Robusr/DustArrow/media/README.md

# Media

## Photos

- `photos/project/` — author’s renders, bench photos, PCB screenshots, report
  figures and GIFs. `banner.png` is the README banner.
- `photos/project/cad_renders/` — 26 CAD and PCB screenshots from the original
  `演示图片` folder, numbered in capture order.
- `photos/reference/` — figures and equations extracted from the report. They
  are the author’s own figures.

## Videos

`videos/` keeps the original files:

- `cfd_demo.mp4` — CFD demonstration with watermark.
- `cfd_demo_alt.avi` — the clean CFD animation used for the GIF.
- `canard_parachute_animation.mp4` — nose separation, canard deployment and
  recovery animation.

### TV feature excerpts

The full January 2024 Shanghai TV feature is not stored in this repository.
Seven short excerpts are included under `photos/project/`:

- `tv_still_build.png` — DustArrow X whiteboard and printed airframe
- `tv_still_ground_station.png` — ground-station interface
- `tv_still_modular.png` — modular bays during assembly
- `tv_still_launch.png` — lift-off
- `tv_still_recovery.png` — recovered parachute
- `tv_launch.gif` — 6 s launch sequence, 800 × 450, 4.6 MB
- `tv_recovery.gif` — 6 s recovery sequence, 800 × 450, 5.9 MB

The full video is held at `F:\Desktop\Robusr\《少年爱迪生》郭沫晗.mp4`;
19:43.02, 640 × 360, 25 fps, about 72.8 MB, SHA-256
`27854a95a43206bc7dd3ea3188fd81b3f9bddbf61c9e64516de09805426529c9`.
The excerpts and the full programme remain copyright Shanghai Media Group and
are excluded from MIT. See `../docs/zh-CN/media_coverage.md` for the fact-check
and rights note.

## GIFs

GIFs are stored in `photos/project/` with a poster frame. Specifications:

| File | Width | Frame rate | Size |
|---|---:|---:|---:|
| `cfd_demo.gif` | 880 px | 12 fps | about 1.0 MB |
| `canard_deployment.gif` | 800 px | 10 fps | about 2.0 MB |

Both loop, have no audio and are below the 10 MB limit. The poster files are
`cfd_demo_poster.png` and `canard_deployment_poster.png`.

## Rights

Project renders and bench photos are the author’s work. Screenshots containing
the contest logo are kept only in the archived report and presentation, not in
the public media set. See `../docs/references/README.md`.
