Robusr/DustArrow/software/README.md

# Software

- `ground_station/` — archived PyQt5 ground-station source for DustArrow X.
- `../docs/archive/software_legacy/` — earlier Theta and contest builds, kept for
  traceability. Build outputs and `__pycache__` directories were removed.

The flight firmware is **not present** in the archive. See
`../firmware/README.md`.
