Robusr/DustArrow/docs/glossary.md

# Glossary / 术语表 / Glossaire

The three READMEs and the long-form documents use the terms below consistently.
Les trois README et les documents longs utilisent les termes ci-dessous de manière cohérente.

| English | 中文 | Français |
|---|---|---|
| DustArrow X | 沙尘利“箭” X | DustArrow X |
| meteorological sounding rocket | 气象探空火箭 | fusée-sonde météorologique |
| modular telemetry system | 模块化遥测系统 | système de télémétrie modulaire |
| airframe | 箭体 | cellule |
| bay / module bay | 舱段 / 模块舱 | baie / baie modulaire |
| nose cone | 头锥 | ogive |
| canard | 鸭翼 | plan canard |
| parachute bay | 降落伞舱 | baie de parachute |
| gold-finger connector | 金手指连接器 | connecteur à doigts dorés |
| flexible printed circuit (FPC) | 柔性电路板（FPC） | circuit imprimé flexible (FPC) |
| flight computer | 箭载计算机 | calculateur de bord |
| inertial measurement unit (IMU) | 惯性测量单元 | centrale inertielle (IMU) |
| attitude estimation | 姿态估计 | estimation d’attitude |
| complementary filter | 互补滤波 | filtre complémentaire |
| roll / pitch / yaw | 横滚 / 俯仰 / 偏航 | roulis / tangage / lacet |
| quaternion | 四元数 | quaternion |
| accelerometer | 加速度计 | accéléromètre |
| gyroscope | 陀螺仪 | gyroscope |
| barometer | 气压计 | baromètre |
| GNSS | 全球导航卫星系统 | GNSS |
| telemetry frame | 遥测帧 | trame de télémétrie |
| checksum / CRC | 校验和 / 循环冗余校验 | somme de contrôle / CRC |
| ground station | 地面站 | station au sol |
| serial port | 串口 | port série |
| bill of materials (BOM) | 物料清单 | nomenclature |
| Gerber file | Gerber 制造文件 | fichier Gerber |
| FDM 3D printing | 熔融沉积 3D 打印 | impression 3D FDM |
| von Kármán curve | 冯·卡门曲线 | courbe de von Kármán |
| reproducibility | 可复现性 | reproductibilité |
| verification | 验证 | vérification |
| design target | 设计目标 | objectif de conception |
| measured value | 实测值 | valeur mesurée |
| unverified claim | 未验证结论 | affirmation non vérifiée |
| media coverage | 媒体报道 | couverture médiatique |
| test flight | 试飞 | essai en vol |
| ignition | 点火 | allumage |
| wired ignition | 线控点火 | allumage filaire |
| recovery | 回收 | récupération |
| partial recovery | 部分回收 | récupération partielle |
| broadcast | 播出 | diffusion |
