Robusr/DustArrow/docs/en/index.md

# DustArrow X Documentation

- [Theory of operation](theory_of_operation.md) — coordinate frames, attitude
  estimation, complementary filtering, telemetry framing and quaternion
  conventions.
- [System design](system_design.md) — airframe, electronics, ground station and
  interfaces.
- [Replication guide](replication_guide.md) — what can be built, tested and what
  is missing.
- [Media coverage](media_coverage.md) — TV feature, flight-test evidence and
  rights.
- [Errata](../errata.md) — sixteen reviewed items, with status and evidence.
- [Verification](../verification.md) — test inventory, results and limitations.
- [Glossary](../glossary.md) — English, Chinese and French terms.
- [References](../references/README.md) — report, datasheets and media rights.
- [Archive](../archive/README.md) — original report, presentation and legacy code.

Return to the [English README](../../README.md).
