Robusr/DustArrow/docs/fr/index.md

# Documentation DustArrow X

- [Principe de fonctionnement](theory_of_operation.md) — repères, estimation
  d’attitude, filtre complémentaire, trame de télémétrie et conventions de
  quaternion.
- [Conception du système](system_design.md) — cellule, électronique, station au
  sol et interfaces.
- [Guide de reproduction](replication_guide.md) — ce qui peut être fabriqué,
  testé et ce qui manque.
- [Couverture médiatique](media_coverage.md) — sujet télévisé, preuve d’essai en
  vol et droits.
- [Errata](../errata.md) — seize points examinés, avec statut et preuves.
- [Vérification](../verification.md) — inventaire des tests, résultats et limites.
- [Glossaire](../glossary.md) — termes en anglais, chinois et français.
- [Références](../references/README.md) — rapport, fiches techniques et droits
  sur les médias.
- [Archives](../archive/README.md) — rapport original, présentation et ancien
  code.

Retour au [README français](../../README.fr.md).
