Robusr/DustArrow/docs/zh-CN/index.md

# DustArrow X 文档

- [工作原理](theory_of_operation.md)：坐标约定、姿态解算、互补滤波、遥测分帧与
  四元数约定。
- [系统设计](system_design.md)：箭体、电子、地面站与接口。
- [复现指南](replication_guide.md)：可以制造和测试什么，还缺少什么。
- [媒体报道](media_coverage.md)：电视专题、试飞证据与版权说明。
- [勘误记录](../errata.md)：16 项审查条目、状态与依据。
- [验证记录](../verification.md)：测试清单、结果与局限。
- [术语表](../glossary.md)：英文、中文、法文对照。
- [参考资料](../references/README.md)：报告、器件手册与媒体授权。
- [归档](../archive/README.md)：原始报告、答辩材料与旧版代码。

返回[中文 README](../../README.zh-CN.md)。
