Robusr/DustArrow/docs/zh-CN/media_coverage.md

# 媒体报道：《少年爱迪生》第八季《明日世界》

<p align="center">
  <a href="../en/media_coverage.md">English</a> |
  <a href="media_coverage.md">中文</a> |
  <a href="../fr/media_coverage.md">Français</a>
</p>

本文整理上海广播电视台青少年科学梦想秀《少年爱迪生》第八季《明日世界》中郭沫晗与“沙尘利箭”专题的公开信息，并把电视叙述与仓库中的设计、代码和验证记录区分开。电视节目是叙事性证据，不是遥测数据或实验报告。

## 1. 节目与播出信息

| 项目 | 内容 |
|---|---|
| 节目 | 青少年科学梦想秀《少年爱迪生》第八季《明日世界》 |
| 制作与播出 | 上海市科委、上海市教委、上海广播电视台；上视新闻综合频道、看看新闻 APP |
| 郭沫晗专题预告 | 2024-01-25 19:53，看看新闻 |
| 郭沫晗专题页 | 2024-01-27 23:09，看看新闻 |
| 节目综述 | 2024-02-25 10:28，看看新闻 |
| 节目季背景 | 2024-01-20 首播；16 组少年发明家，来自 40 多个国家和地区 |
| 科学顾问 | 陈凯先、倪闽景、陶虎、贾阳、戴伟、汪婧雅等 |

播出时间在不同页面存在差异：预告写“1 月 27 日晚 19 点 45 分”，综述写“每周六晚 20:30”。本文保留两种口径，不把具体分钟当作已核实事实。

官方页面：

- 预告：<https://www.kankanews.com/detail/ELwxNKJWGy9>
- 专题：<https://www.kankanews.com/detail/LMwVGm9WB2z>
- 综述：<https://www.kankanews.com/detail/boy4AKjBxQ1>

## 2. 本地视频记录

| 属性 | 数值 |
|---|---|
| 文件 | `F:\Desktop\Robusr\《少年爱迪生》郭沫晗.mp4` |
| 时长 | 19:43.02 |
| 分辨率 | 640 × 360 |
| 帧率 | 25 fps |
| 视频编码 | H.264 Main，约 447 kb/s |
| 音频编码 | AAC LC，44.1 kHz，立体声，约 65 kb/s |
| 文件大小 | 76,333,836 字节，约 72.8 MB |
| SHA-256 | `27854a95a43206bc7dd3ea3188fd81b3f9bddbf61c9e64516de09805426529c9` |

完整视频为第三方电视节目，未复制进本仓库；仓库保留 5 张截图与 2 段 GIF 摘要，
位于 `media/photos/project/`。完整视频、完整字幕与其余截帧不再分发。截图与 GIF
版权归上海广播电视台所有，不在 MIT 许可范围内。

### 转录说明

音轨使用 `faster-whisper small` 本地模型转写，并人工校正人名、专有名词和明显同音错误。转写不是官方字幕，时间码为近似值。片中内嵌中文字幕用于交叉核对。完整机器转录保存在仓库外的临时目录，不纳入版本控制。

## 3. 片中确认的项目信息

### 3.1 三代火箭与命名

| 时间 | 片中陈述 |
|---|---|
| 2023-02 | 第一代火箭完成，可以监测当前姿态并把数据返回电脑地面端软件 |
| 之后 | 第二代火箭进行初步模块化设计 |
| 第三代 | 命名为 **DustArrow X**；“X 就意味着有着无限的可能” |
| 第三代结构 | 片中称“总共四个部分，可以随意拼接”；粉尘传感器可与气体传感器拼接，组成三个传感器的探测段 |
| 模块化目标 | 探测沙尘暴、酸雨等不同天气时，不更换整个箭体，只更换相应模块 |

片中在 08:08 左右说“四个部分”，而仓库正式 CAD 将箭体细分为十个功能舱段。两者不矛盾：电视用四个功能分组讲述，CAD 用十个舱段实现。该口径差异标记为需要作者确认。

### 3.2 试飞过程

片头把时间放在“2023 年秋末初冬的一天”，地点是“固原市郊外的戈壁滩”。

1. 遥控点火程序测试失败。片中解释为开发板 I/O 口有保护机制，原方案被否定。
2. 改用线控点火，在 7.5 m 距离测试成功。
3. 在戈壁滩安装临时发射架，完成倒计时和发射。
4. 火箭升空后回收。片中陈述：“伞舱部分和推进模块都丢了”，“最重要的传感器部分留了下来”，“回收的完整程度达到了 80%”。
5. 学生表示“比预期要好很多”，片中以“成功”字幕描述这次试飞。

因此，这次试飞可以表述为：**火箭成功离架并完成回收，传感器段被找回；伞舱与推进模块丢失，整箭回收并不完整。** 80% 是学生现场估计，不是独立测量。

### 3.3 地面站与数据链

片中在 08:47 左右说明地面端“读取一个文本文件中的数据，然后完成一些简单的姿态反馈任务”。这与仓库归档代码的行为一致：串口正则解析后写入 `data.txt`，六张图是占位曲线，OpenGL 组件未启用。

学生在 18:04 左右补充了两条数据链设想：

- 设计 SD 卡记录装置；
- 在主控部分增加远程数传装置；
- “理论上是可以实时把数据传回来的”。

这是设计意图，不是片中演示结果。片中未展示遥测日志、SD 卡数据或实时回传画面。

### 3.4 设计理念

- 模块化、可回收；可以连续发射多枚火箭，对沙尘天气做立体分析。
- 现有市售粉尘传感器多为模拟传感器，存在误差；学生希望未来使用更专业、更精密的传感器。
- 项目从个人兴趣出发，逐渐转向为家乡沙尘天气监测提供工具。

## 4. 片中未提供的量化信息

片中**没有**给出以下数据：

- 飞行高度、速度、加速度、姿态角、气压、温度、湿度；
- 粉尘浓度、气体浓度或传感器标定结果；
- 通信距离、RSSI、误码率、链路余量；
- 回收撞击速度、伞舱分离高度或残骸位置；
- 整箭质量、推力、质心或转动惯量。

因此，电视节目不能替代飞行日志、传感器标定或链路预算。它只证明“进行过一次试飞并回收了部分箭体”，不证明“千米级稳定数传”或“精确气象探测”。

## 5. 与仓库资料的口径差异

| 主题 | 电视表述 | 仓库表述 | 处理 |
|---|---|---|---|
| 项目类型 | 气候监测火箭 | 气象探空火箭、模块化遥测系统 | 同一对象的不同表述；仓库使用技术术语 |
| 第三代结构 | 四个部分，可随意拼接 | 十个功能舱段 | 功能分组与 CAD 细分不同，待作者确认 |
| 第一代完成时间 | 2023-02 | 报告与 BOM 为 2023-08 | 不矛盾：2 月完成第一代，8 月形成比赛/报告材料 |
| 回收结果 | “成功”，回收完整度 80% | 归档无飞行日志 | 采用“部分回收”表述，80% 标注为学生估计 |
| 数据链 | “理论上可以实时传回” | 归档无遥测日志 | 设计意图，不作实测结论 |
| 奖项 | SkillsMP 资料称全国二等奖 | 仓库只写参加全国青少年科技创新大赛 | 官方名单未取得，标记 `[未核实]` |

关于奖项：第三方资料 SkillsMP 称项目在 2023 年 8 月第 37 届全国青少年科技创新大赛获二等奖。检索未取得官方获奖名单附件，因此本文不把它写成既成事实，也不写入 README 主规格。

## 6. 事实核查表

| 陈述 | 证据 | 状态 |
|---|---|---|
| 进行过一次火箭试飞 | 专题片 00:27–17:24；看看新闻专题页 | 电视已确认 |
| 遥控点火失败，改用线控 | 专题片 11:30–12:23 | 电视已确认 |
| 7.5 m 线控点火成功 | 专题片 12:21–12:23 | 电视已确认 |
| 传感器段回收，伞舱与推进模块丢失 | 专题片 17:09–17:24 | 电视已确认 |
| 回收完整度 80% | 专题片 17:16–17:19 | 学生现场估计，非独立测量 |
| 地面站读取文本文件并做简单姿态反馈 | 专题片 08:47–08:49；归档代码 | 已确认，属原型 |
| 实时数传 | 专题片 18:20–18:22 | 设计意图，未演示 |
| 千米级数传 | 报告声明 | 未验证 |
| 全国二等奖 | SkillsMP 资料 | `[未核实]`，无官方名单 |
| X 表示无限可能 | 专题片 08:02–08:05 | 电视已确认 |
| 试飞时间为 2023 年秋末初冬 | 专题片 00:27–00:32 | 电视陈述，无精确日期 |

## 7. 引用、版权与使用边界

- 电视节目版权归上海广播电视台及节目制作方所有。看看新闻页面注明“未经授权，不得转载”。
- 仓库包含 5 张截图和 2 段 GIF 摘要，位于 `media/photos/project/`；不包含完整视频、完整字幕或其他截帧。这些摘要属于第三方材料，不适用 MIT 许可。
- 引用建议：上海广播电视台《少年爱迪生》第八季《明日世界》郭沫晗专题，2024-01-27；本地视频文件 SHA-256 见上。
- 节目中的学生陈述属于个人叙述；涉及技术性能的数字应按“电视陈述”而非“实测数据”引用。

## 8. 对仓库信息的影响

- 三个 README 增加“媒体报道”章节，并补充 X 命名来源。
- 设计规格表把“飞行试验”从“归档中无记录”改为“电视记录的试飞，部分回收，无遥测日志”。
- 勘误表新增 E-16，记录电视证据的范围与限制。
- 不修改理论推导、BOM、CAD 或验证结果；电视叙述不作为定量依据。
