Robusr/DustArrow/docs/archive/display_board/展板文字.docx

项目背景

每逢初春，频繁恶劣的沙尘天气席卷西北大地。年初，各省市的猛烈沙尘暴登上了新闻热搜，粉尘携带细菌，造成空气质量下降，人居环境健康每况愈下，导致了呼吸系统疾病，严重影响了日常的工作和生活，沙尘天气的危害不言而喻。有效治理以精确探测为基础，地面的低空沙尘监测装置往往不能得到全面立体的沙尘暴数据，目前的气象火箭不能针对沙尘天气进行有效的实时探测，对各类恶劣天气的研究也存在局限性。中国空间站的模块化结构让我受到启发，研究设计了气象探测火箭的模块化遥测系统。

创新要点

火箭端

箭体由10个功能模块构成，根据实际需求，主体采用不同材质3D打印，各模块间设计了PCB金手指结构连接电路。其中运算模块使用了RP2040芯片作为微处理器；测控模块搭载了MPU6050六轴运动处理组件、GNSS卫星定位模组和BMP280气压传感器，用于反馈火箭姿态、高度和定位数据，参与运算并执行控制命令；数据模块使用了A39C-T400A22D1a数传模组，能实现千米级稳定精确的数据传输；3个传感器模块可根据具体的探测需求灵活调整；鸭翼和降落伞模块保障了火箭的平稳运行和有效回收。

地面端

在地面端遥测软件中，使用Python的Matplotlib数据可视化库，以Qt为UI框架，开发了简洁高效的操作界面。搭配OpenGL组件实现了3D姿态信息的实时反馈，结合Numpy库编写了相关的数据分析算法，对传感器返回的气象数据进行实时分析和精确记录，可实现多元化的探测需求。

发展前景

在各类恶劣气象灾害的防治过程中，继续完善火箭的控制算法和回收机制，以应对复杂多变的气象条件。拓展火箭搭载的传感器种类，探索模块化结构更多的可能性。接入智慧城市的物联网系统，多部门协调统筹管理，对气象灾害的预防治理整体规划，统一部署，让沙尘利“箭”带来天朗气清。
