Robusr/DustArrow/electronics/output/silkscreen/dustarrow_silkscreen.png

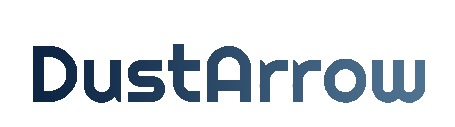
electronics/output/silkscreen/dustarrow_silkscreen.png
