Robusr/DustArrow/electronics/output/silkscreen/name_silkscreen.png

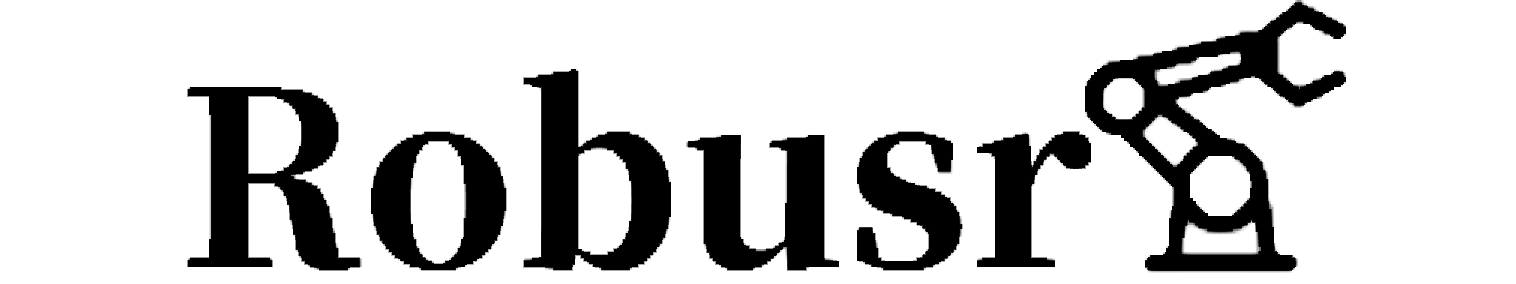
electronics/output/silkscreen/name_silkscreen.png
