Robusr/DustArrow/electronics/output/silkscreen/rocket_silkscreen.png

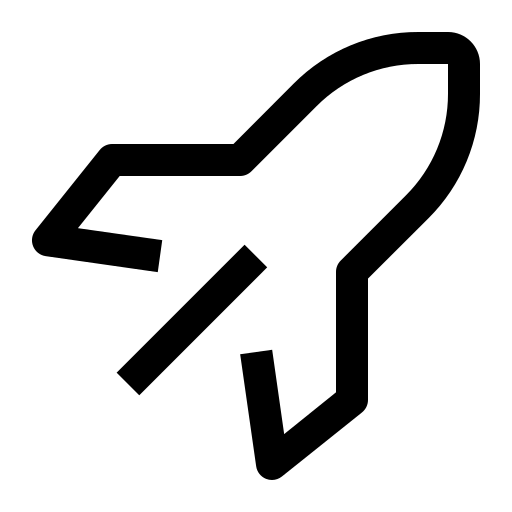
electronics/output/silkscreen/rocket_silkscreen.png
