Robusr/DustArrow/media/photos/project/attitude_render_x60_y90.png

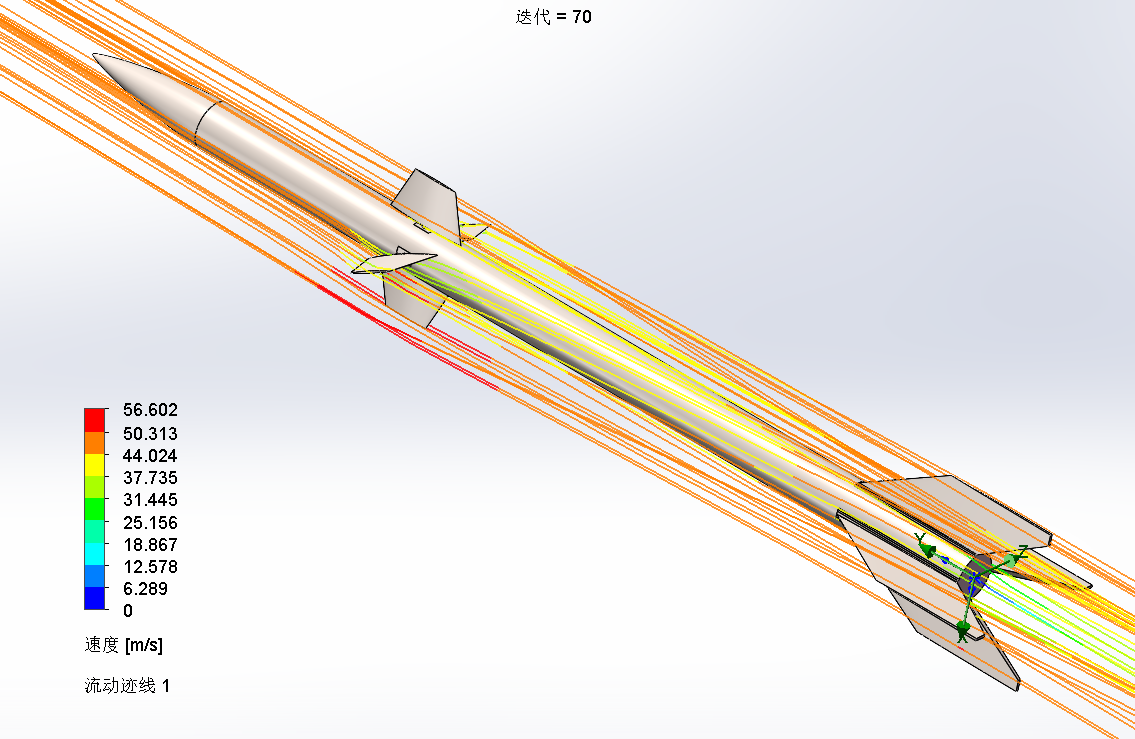
media/photos/project/attitude_render_x60_y90.png
