Robusr/DustArrow/media/photos/project/attitude_render_x90_y90.png

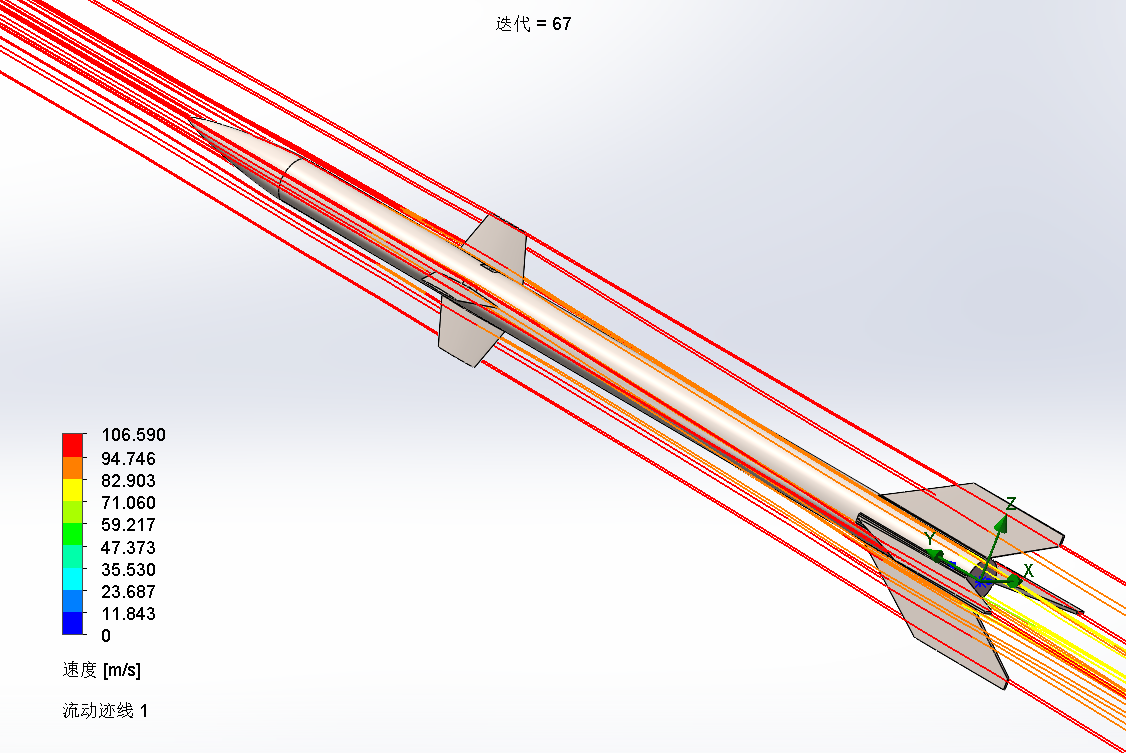
media/photos/project/attitude_render_x90_y90.png
