Robusr/DustArrow/media/photos/project/cad_renders/cad_render_01.png

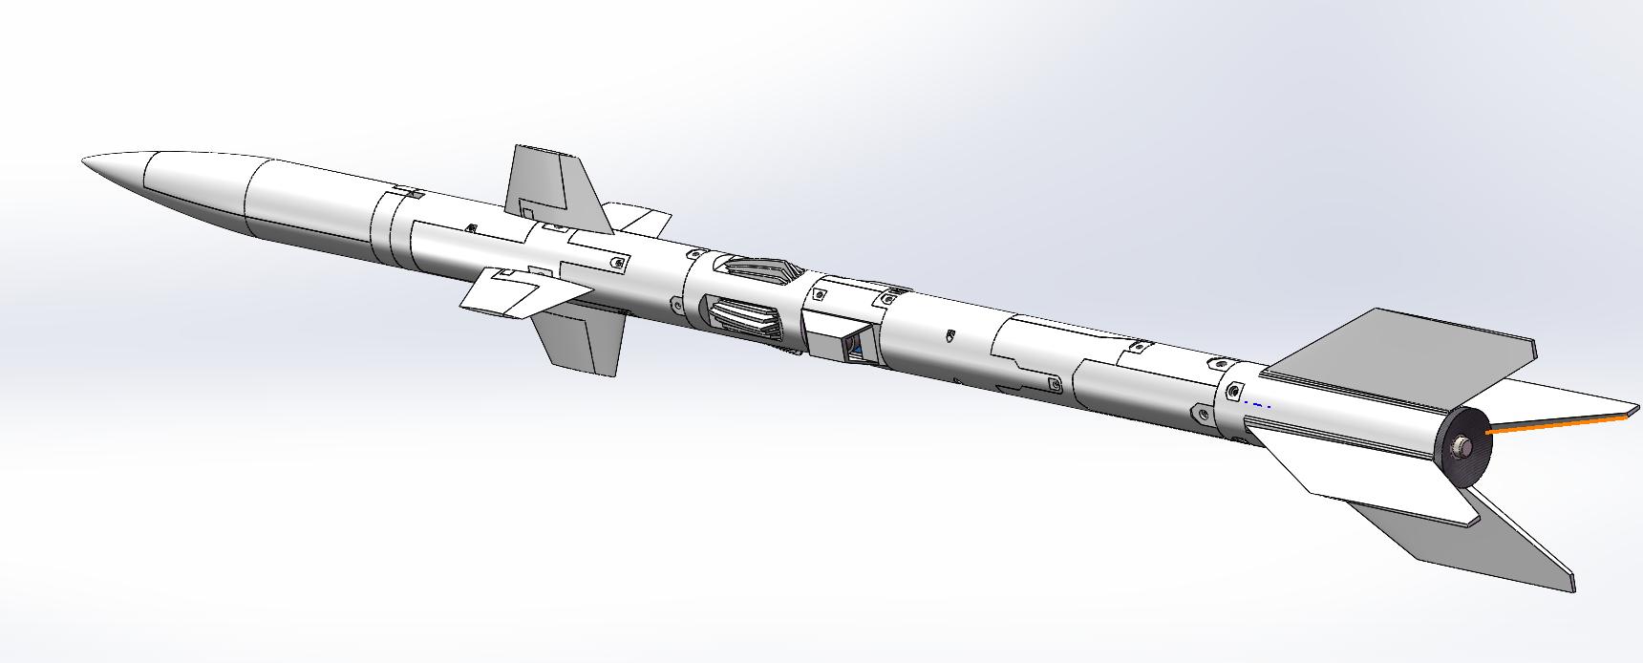
media/photos/project/cad_renders/cad_render_01.png
