Robusr/DustArrow/media/photos/project/cad_renders/cad_render_02.png

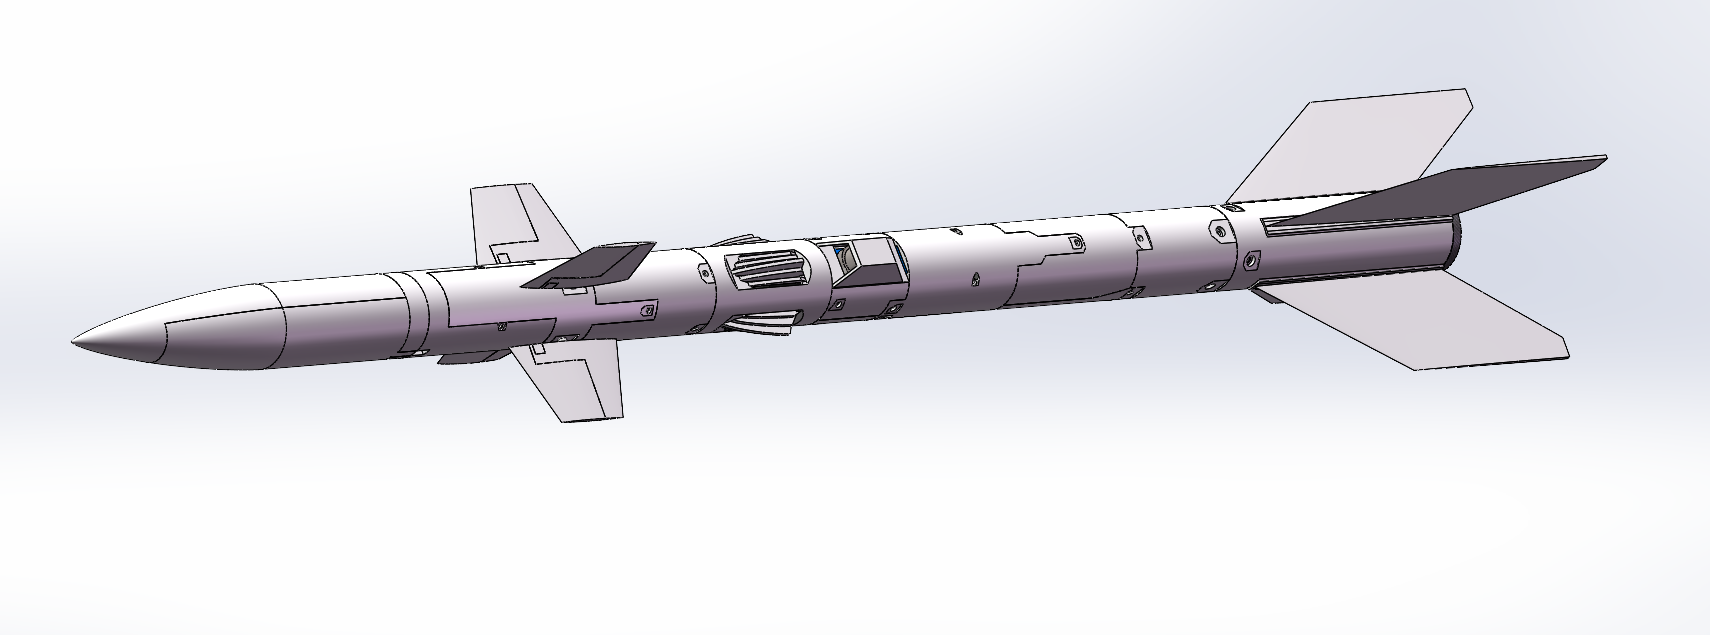
media/photos/project/cad_renders/cad_render_02.png
