Robusr/DustArrow/media/photos/project/cad_renders/cad_render_03.png

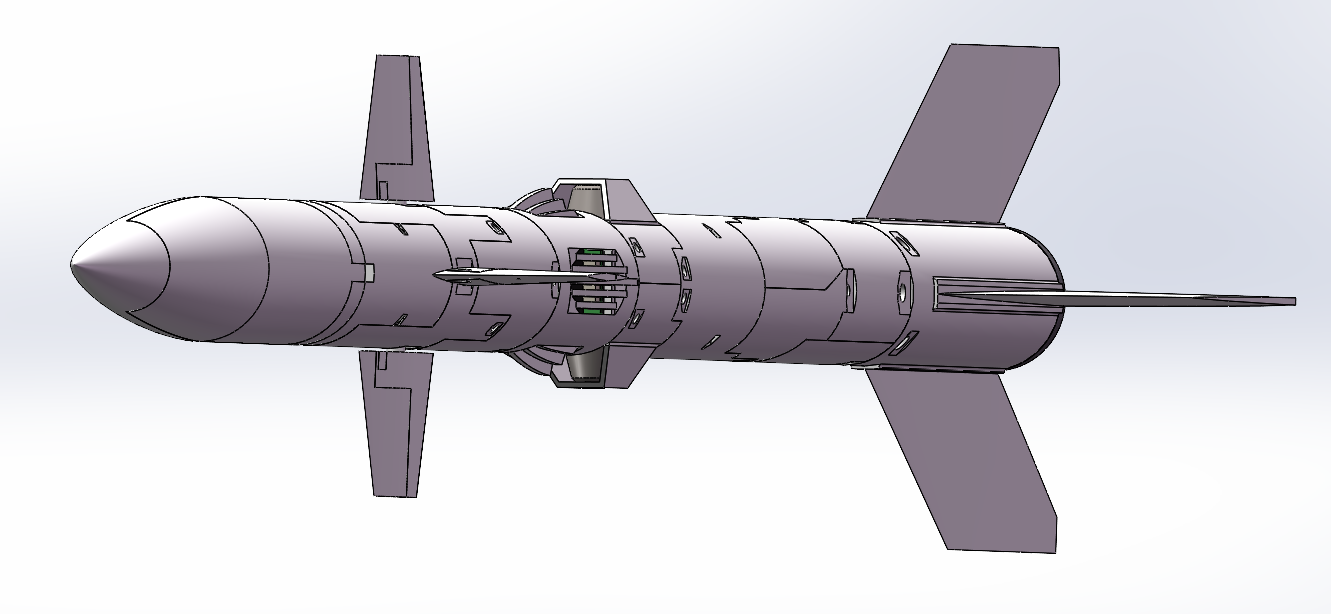
media/photos/project/cad_renders/cad_render_03.png
