Robusr/DustArrow/media/photos/project/cad_renders/cad_render_04.png

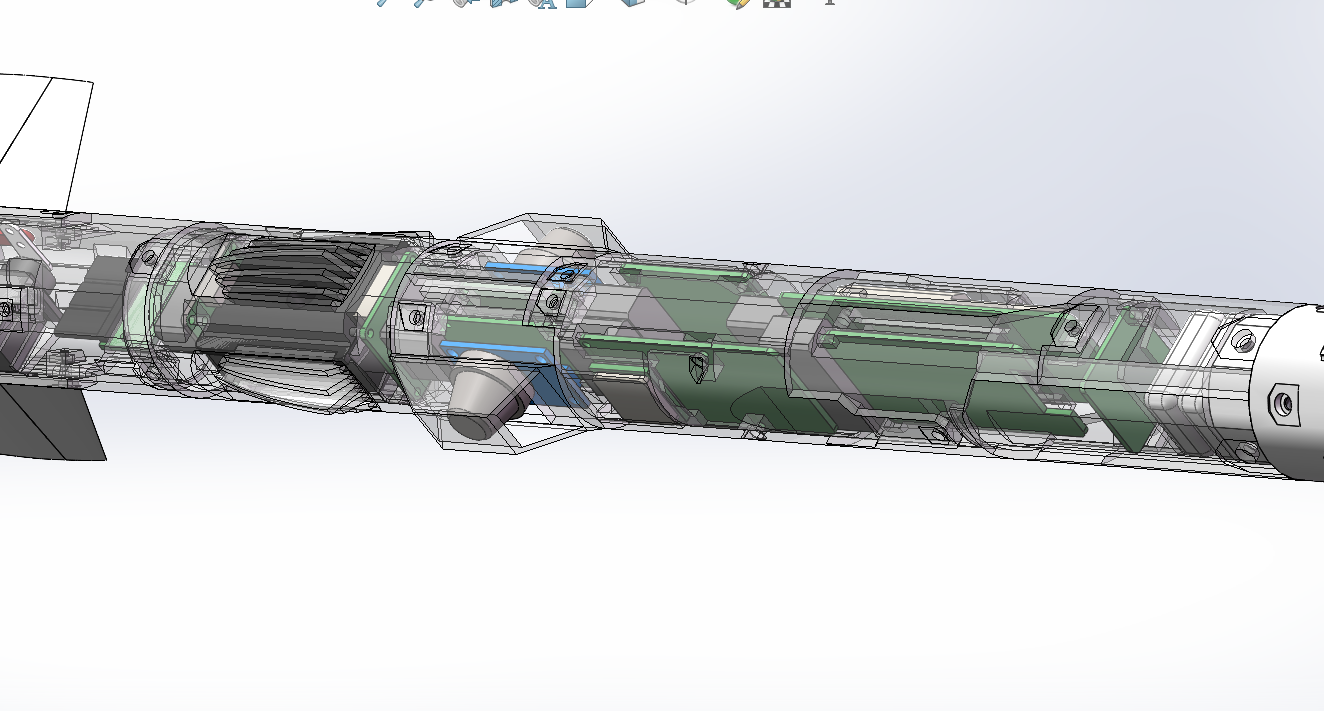
media/photos/project/cad_renders/cad_render_04.png
