Robusr/DustArrow/media/photos/project/cad_renders/cad_render_05.png

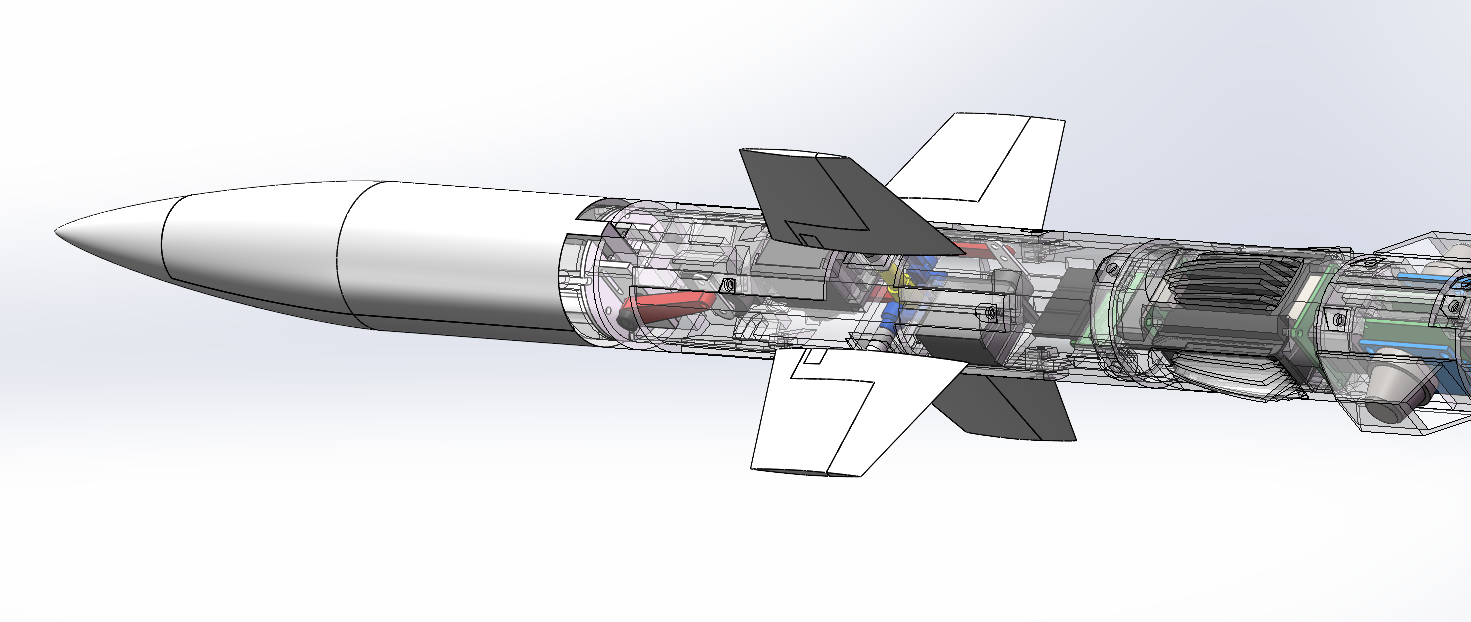
media/photos/project/cad_renders/cad_render_05.png
