Robusr/DustArrow/media/photos/project/cad_renders/cad_render_11.png

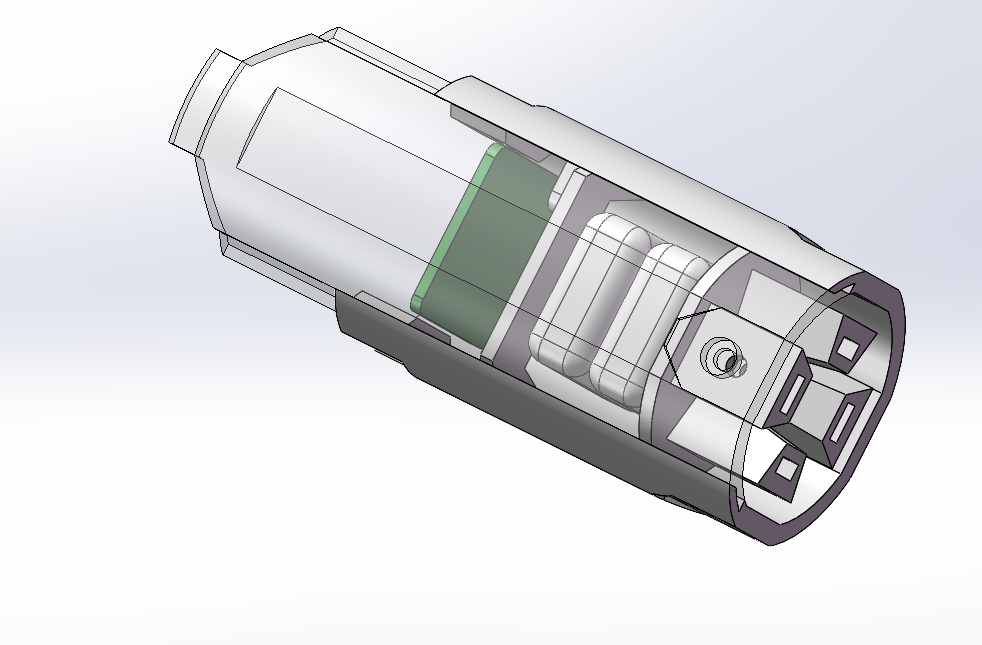
media/photos/project/cad_renders/cad_render_11.png
