Robusr/DustArrow/media/photos/project/cad_renders/cad_render_13.png

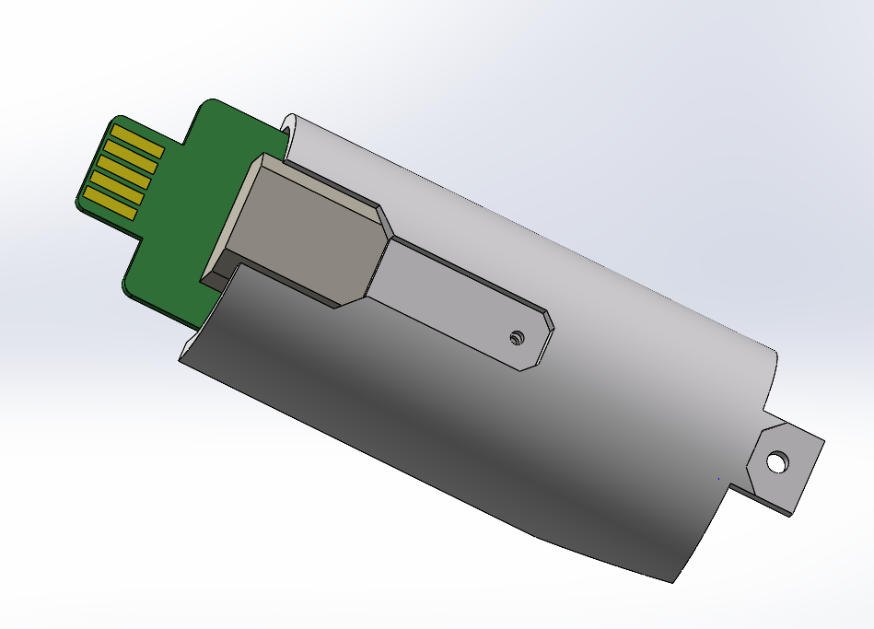
media/photos/project/cad_renders/cad_render_13.png
