Robusr/DustArrow/media/photos/project/cad_renders/cad_render_14.png

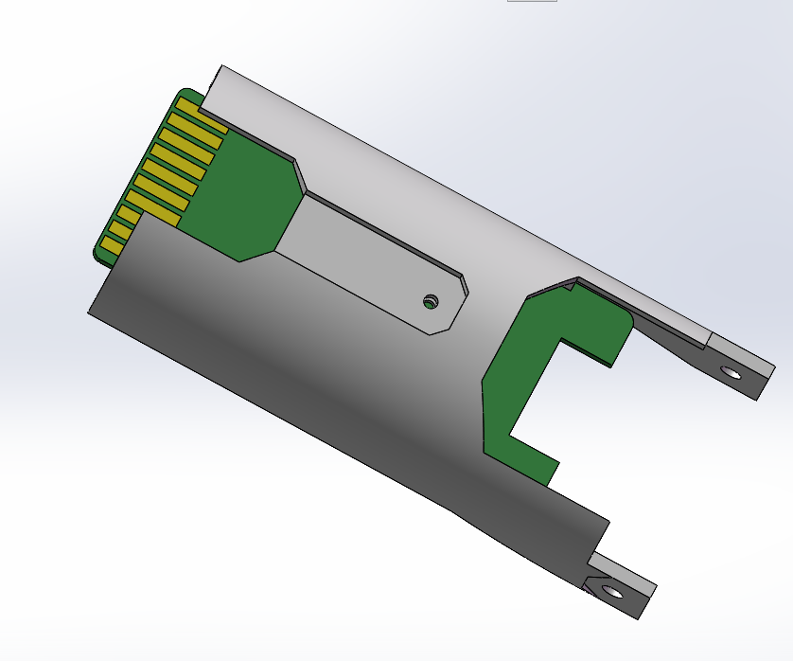
media/photos/project/cad_renders/cad_render_14.png
