Robusr/DustArrow/media/photos/project/cad_renders/cad_render_15.png

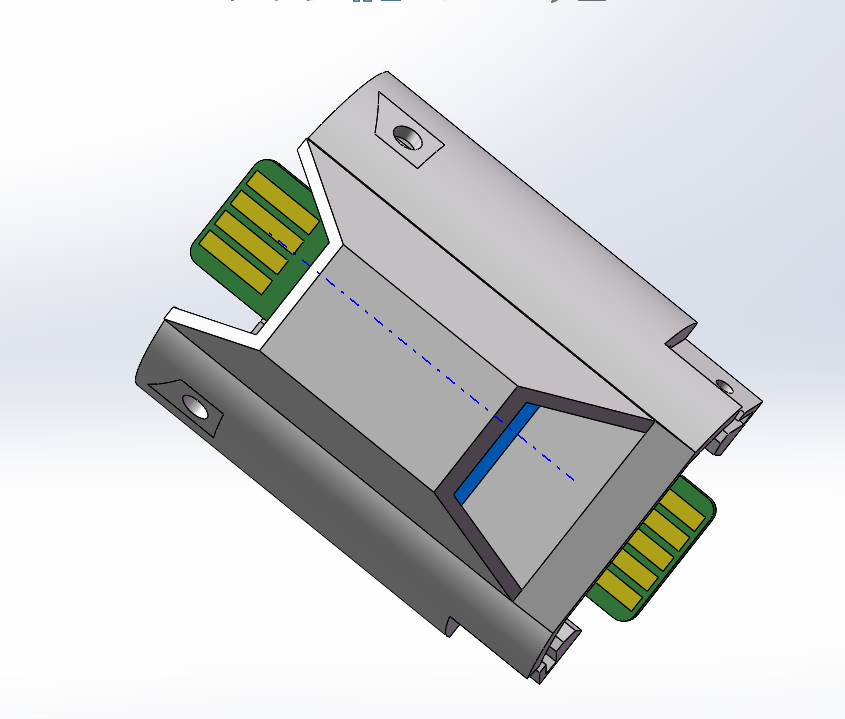
media/photos/project/cad_renders/cad_render_15.png
