Robusr/DustArrow/media/photos/project/cad_renders/cad_render_16.png

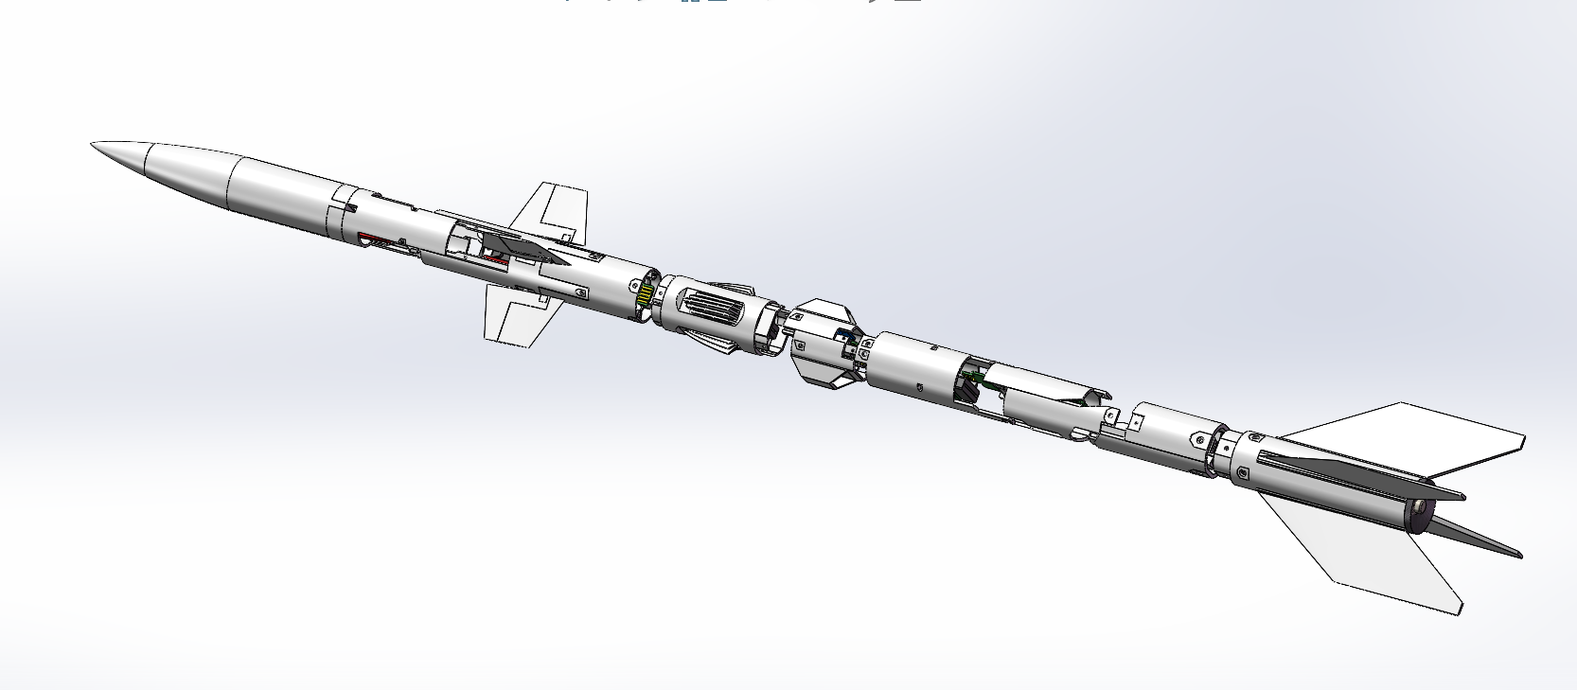
media/photos/project/cad_renders/cad_render_16.png
