Robusr/DustArrow/media/photos/project/cad_renders/cad_render_17.png

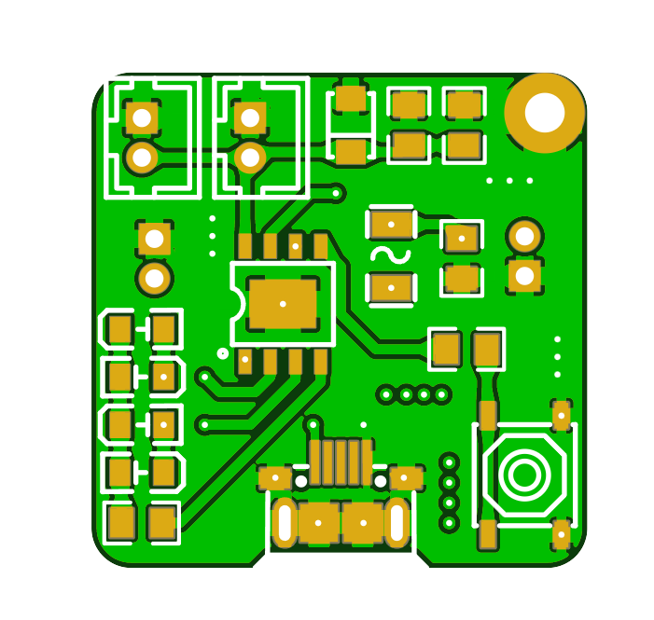
media/photos/project/cad_renders/cad_render_17.png
