Robusr/DustArrow/media/photos/project/cad_renders/cad_render_18.png

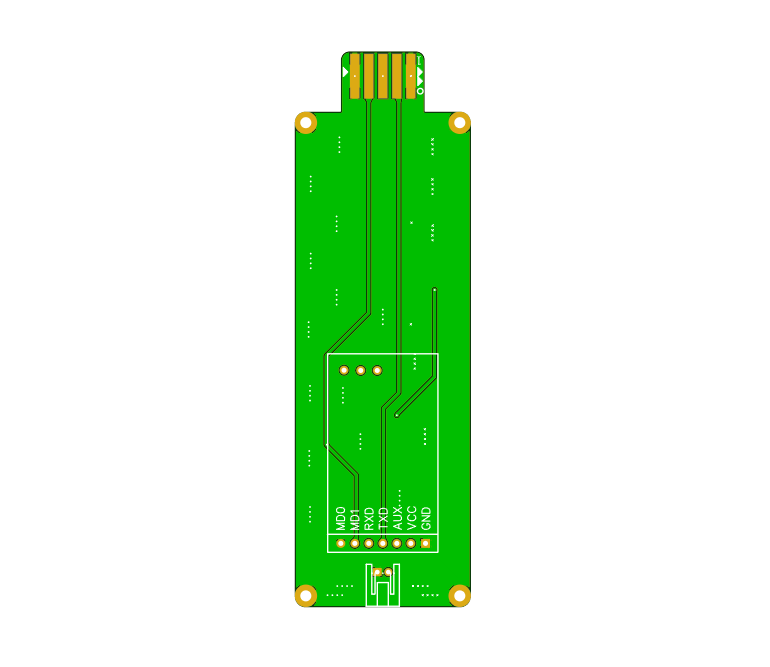
media/photos/project/cad_renders/cad_render_18.png
