Robusr/DustArrow/media/photos/project/cad_renders/cad_render_20.png

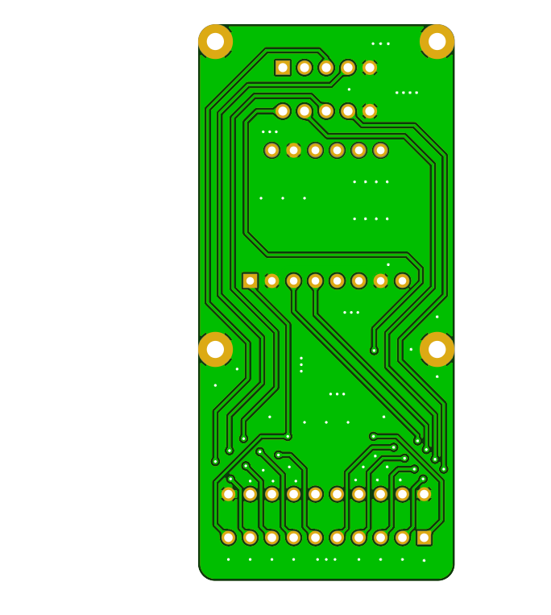
media/photos/project/cad_renders/cad_render_20.png
