Robusr/DustArrow/media/photos/project/cad_renders/cad_render_22.png

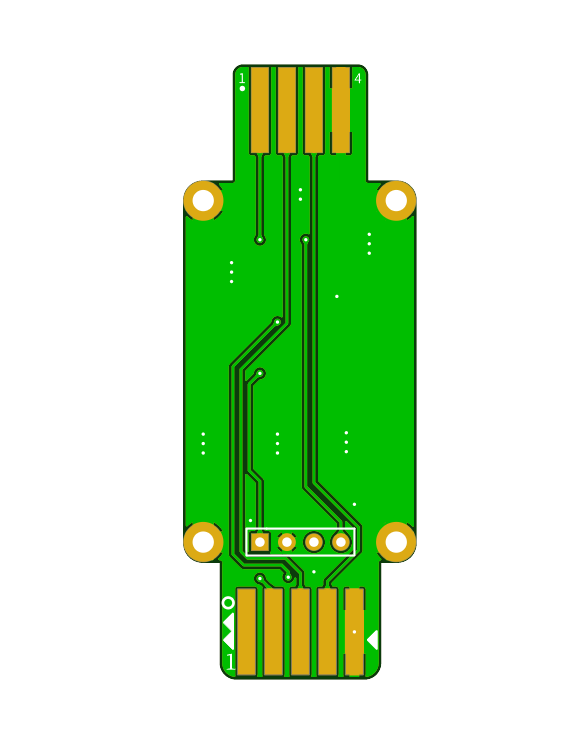
media/photos/project/cad_renders/cad_render_22.png
