Robusr/DustArrow/media/photos/project/cad_renders/cad_render_24.png

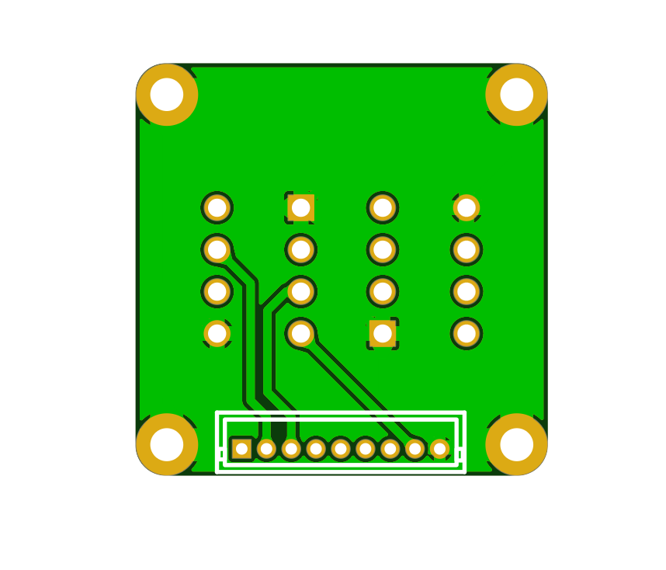
media/photos/project/cad_renders/cad_render_24.png
