Robusr/DustArrow/media/photos/project/canard_bay_render.jpg

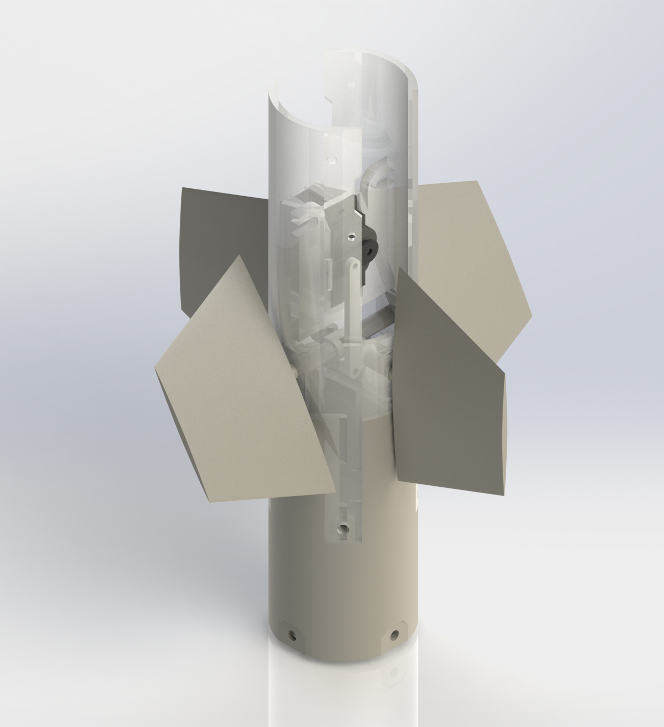
media/photos/project/canard_bay_render.jpg
