Robusr/DustArrow/media/photos/project/canard_deployment_poster.png

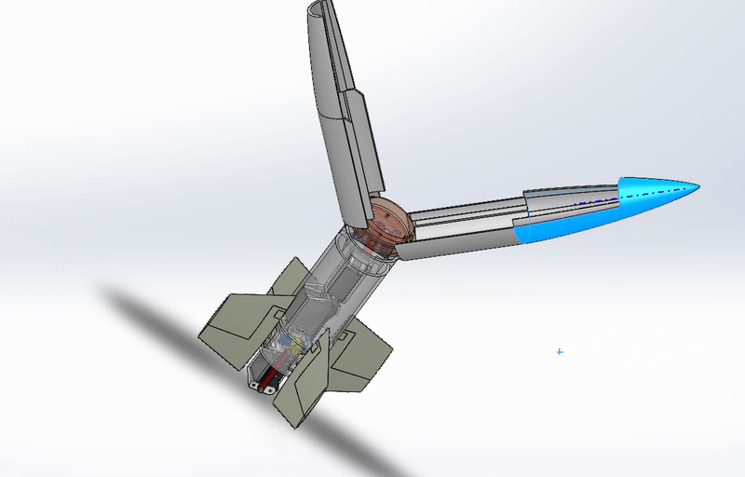
media/photos/project/canard_deployment_poster.png
