Robusr/DustArrow/media/photos/project/cfd_demo_poster.png

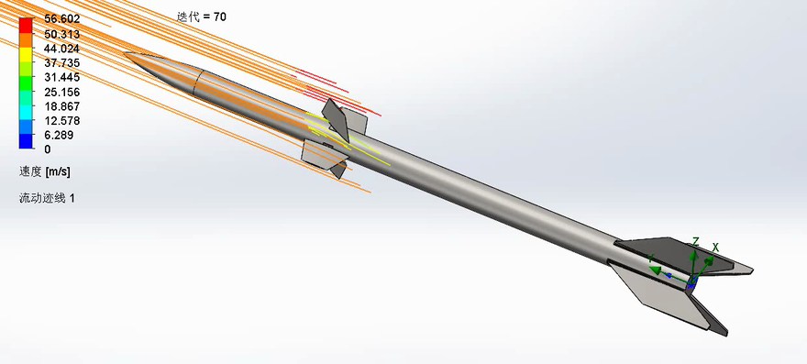
media/photos/project/cfd_demo_poster.png
