Robusr/DustArrow/media/photos/project/gas_sensor_module_render.jpg

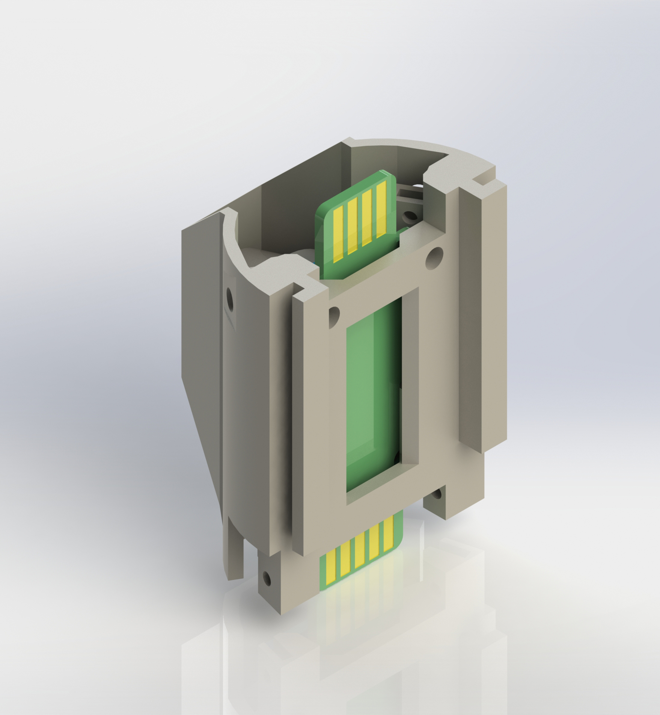
media/photos/project/gas_sensor_module_render.jpg
