Robusr/DustArrow/media/photos/reference/fig2_1b_control_flowchart.png

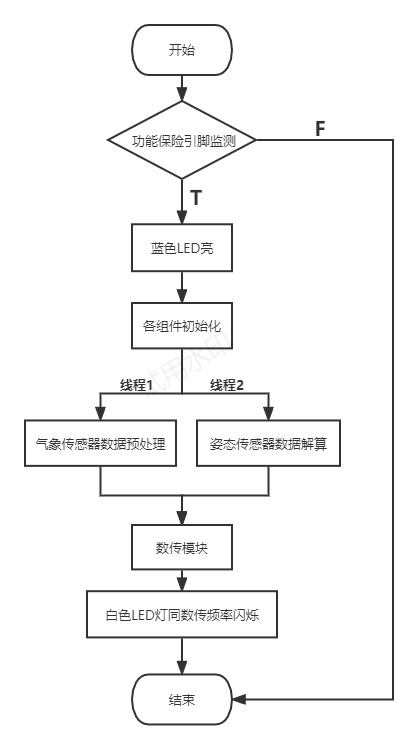
media/photos/reference/fig2_1b_control_flowchart.png
