Robusr/DustArrow/media/photos/reference/fig2_111_rp2040_pico_module.png

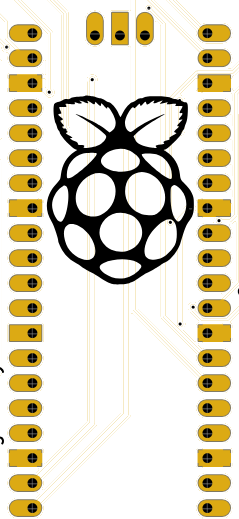
media/photos/reference/fig2_111_rp2040_pico_module.png
