Robusr/DustArrow/media/photos/reference/fig2_132_program_structure.png

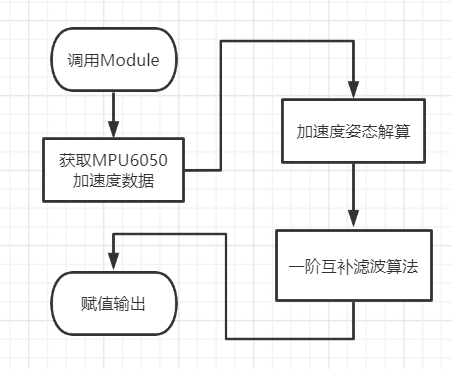
media/photos/reference/fig2_132_program_structure.png
