Robusr/DustArrow/media/photos/reference/fig2_141b_telemetry_pcba.png

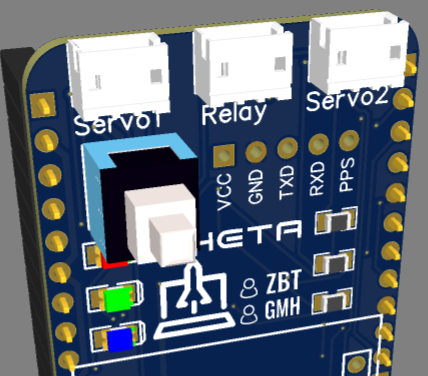
media/photos/reference/fig2_141b_telemetry_pcba.png
