Robusr/DustArrow/media/photos/reference/fig2_214_opengl_attitude_cube.png

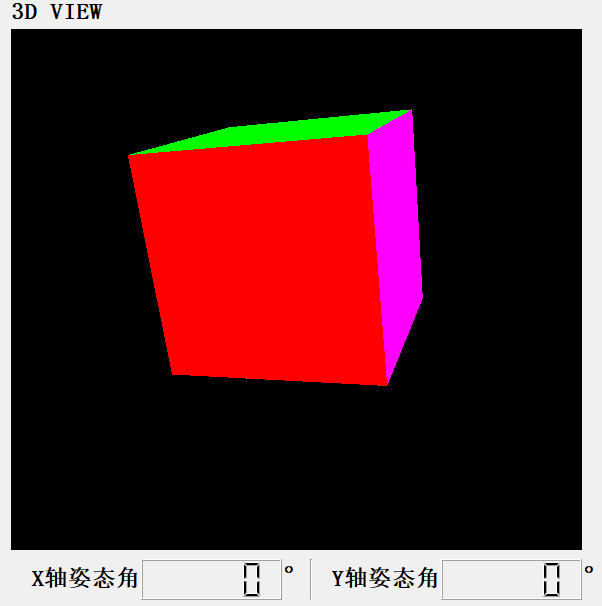
media/photos/reference/fig2_214_opengl_attitude_cube.png
