Robusr/DustArrow/BOM/bill_of_materials.csv

module | id | name | designator | footprint | quantity | manufacturer_part | manufacturer | supplier | supplier_part | unit_price_cny | line_total_cny | price_status
command_a | 1 | Connection | FPC1 | FPC-SMD_P1.00-14P_LCS-XJ-H2.5 | 1 | AFA07-S14FCA-00 | JS(钜硕电子) | LCSC | C262720 | 0.6868 | 0.6868 | priced
command_a | 2 | GPS_Module | U1 | CONN-TH_5P-P2.00_HDGC_HDGC2001WV-5P | 1 | HDGC2001WV-5P | HDGC(华德共创) | LCSC | C5175233 | 0.0884 | 0.0884 | priced
command_a | 3 | Connection | U2,U3 | CONN-TH_10P-P2.54_WINGTAT_ER10BGFBK | 2 | ER10BGFBK | WingTAT(格林柏) | LCSC | C5173327 | 2.4000 | 4.8000 | priced
command_b | 1 | Connection | FPC1 | FPC-SMD_P1.00-14P_LCS-XJ-H2.5 | 1 | AFA07-S14FCA-00 | JS(钜硕电子) | LCSC | C262720 | 0.6868 | 0.6868 | priced
command_b | 2 | MPU6050 | J1 | HDR-M-2.54_1X8 | 1 |  |  | LCSC | C190820 | 0.3252 | 0.3252 | priced
command_b | 3 | MCU | U1 | CONN-TH_ER20BGFBK | 1 | ER20BGFBK | WingTAT(格林柏) | LCSC | C5173332 | 3.4200 | 3.4200 | priced
command_b | 4 | Connection | U2 | CONN-TH_10P-P2.54_WINGTAT_ER10BGFBK | 1 | ER10BGFBK | WingTAT(格林柏) | LCSC | C5173327 | 2.4000 | 2.4000 | priced
command_b | 5 | GY-BMP280 | U3 | GY-BMP280 | 1 |  |  |  |  |  |  | missing
data | 1 | LoRa-A39C | U2 | LORA-A39C-MODULE | 1 |  | ashining |  |  |  |  | missing
data | 2 | Power | U1 | CONN-TH_S2B-PH-K-S-LF-SN | 1 | S2B-PH-K-S(LF)(SN) | JST | LCSC | C173752 | 0.1806 | 0.1806 | priced
dust_sensor_down | 1 | MQ-2 | CN1 | CONN-TH_SA08BL01D | 1 | SA08BL01D | UMaxconn | LCSC | C601198 | 3.0600 | 3.0600 | priced
dust_sensor_down | 2 | MQ-135 | CN2 | CONN-TH_SA08BL01D | 1 | SA08BL01D | UMaxconn | LCSC | C601198 | 3.0600 | 3.0600 | priced
dust_sensor_down | 3 | Connection | CN3 | CONN-TH_9P-P1.50_HCTL_HC-ZH1.5-9A | 1 | HC-ZH1.5-9A | HCTL(华灿天禄) | LCSC | C2845557 | 0.5167 | 0.5167 | priced
dust_sensor_up | 1 | 220u | C1 | C0805 | 1 |  |  |  |  |  |  | missing
dust_sensor_up | 2 | Connection | CN2 | CONN-TH_9P-P1.50_HCTL_HC-ZH1.5-9A | 1 | HC-ZH1.5-9A | HCTL(华灿天禄) | LCSC | C2845557 | 0.5167 | 0.5167 | priced
dust_sensor_up | 3 | DustSensor | CN3 | CONN-TH_HC-ZH1.5-6A | 1 | HC-ZH1.5-6A | HCTL(华灿天禄) | LCSC | C2845554 | 0.3317 | 0.3317 | priced
dust_sensor_up | 4 | 150 | R1 | R0805 | 1 |  |  |  |  |  |  | missing
dust_sensor_up | 5 | CF_10P | CN1 | CONN-TH_SA10BL01D | 1 | SA10BL01D | UMaxconn | LCSC | C444351 | 3.2900 | 3.2900 | priced
dust_sensor_up | 6 | LED_DustSensor | LED1 | LED0603_RED | 1 | 19-217/R6C-AL1M2VY/3T | EVERLIGHT(台湾亿光) | LCSC | C72044 | 0.0995 | 0.0995 | priced
exploration | 1 | Power | U2 | CONN-TH_S2B-PH-K-S-LF-SN | 1 | S2B-PH-K-S(LF)(SN) | JST | LCSC | C173752 | 0.1806 | 0.1806 | priced
exploration | 2 | Switch | J1 | HDR-M-2.54_1X2 | 1 |  |  | LCSC | C124375 | 0.1546 | 0.1546 | priced
exploration | 3 | LED_Power | LED1 | LED0805_RED | 1 | 17-21SURC/S530-A3/TR8 | EVERLIGHT(台湾亿光) |  | C72037 | 0.1116 | 0.1116 | priced
exploration | 4 | LED_Data | LED2 | LED0805_GREEN | 1 | NCD0805G1 | 国星光电 |  | C84260 | 0.1200 | 0.1200 | priced
exploration | 5 | NO | U1 | 2.54MM金手指20PIN | 1 |  |  |  |  |  |  | missing
exploration | 6 | 树莓派-PICO（引脚正常） | M1 | RASPBERRYPI-PICO使用 | 1 |  |  |  |  |  |  | missing
gas_sensor_hat | 1 | MQ-135 | H1 | HDR-F-2.54_1X4 | 1 |  |  | LCSC | C225501 | 0.4525 | 0.4525 | priced
gas_sensor_hat | 2 | NO | U1 | 金手指插板 2.54-2*4 | 1 | 1125-1204G0S165C001 | Wcon | LCSC | C721448 | 0.9613 | 0.9613 | priced
power | 1 | 1K | R1,R2,R4 | 0805 | 3 |  |  |  |  |  |  | missing
power | 2 | 471 | C1,C5,C4 | 0805 | 3 |  |  |  |  |  |  | missing
power | 3 | 105 | C2,C6 | 0805 | 2 |  |  |  |  |  |  | missing
power | 4 | 0Ω | R3 | 0805 | 1 |  |  |  |  |  |  | missing
power | 5 | 10μF | C3,C7 | CAP-SMD_L3.2-W1.6 | 2 | CA45-A010K106T | Xiangyee | LCSC | C119052 | 0.2460 | 0.4920 | priced
power | 6 | 1μH | L1 | IND-SMD_L6.0-W6.0_SMDRS6028 | 1 | PCMB063T-1R0MS | Cyntec | LCSC | C367324 | 1.6845 | 1.6845 | priced
power | 7 | Power | U2,U3 | CONN-TH_2P-P2.00_HDGC_HDGC2001WV-2P | 2 | HDGC2001WV-2P | HDGC(华德共创) | LCSC | C5175230 | 0.0424 | 0.0848 | priced
power | 8 | 25% | LED1 | LED0805-RD | 1 | D-G080508G1 | ARKLED | LCSC | C107402 | 0.1324 | 0.1324 | priced
power | 9 | 50% | LED2 | LED0805-RD | 1 | D-G080508G1 | ARKLED | LCSC | C107402 | 0.1324 | 0.1324 | priced
power | 10 | 75% | LED3 | LED0805-RD | 1 | D-G080508G1 | ARKLED | LCSC | C107402 | 0.1324 | 0.1324 | priced
power | 11 | 100% | LED4 | LED0805-RD | 1 | D-G080508G1 | ARKLED | LCSC | C107402 | 0.1324 | 0.1324 | priced
power | 12 | TS-1187A-B-A-B | SW2 | SW-SMD_4P-L5.1-W5.1-P3.70-LS6.4 | 1 | TS-1187A-B-A-B | XKB Enterprise | LCSC | C318884 | 0.0970 | 0.0970 | priced
power | 13 | IP5306 | U1 | ESOP-8_L4.9-W3.9-P1.27-LS6.0-BL-EP | 1 | IP5306 | INJOINIC | LCSC | C181692 | 1.3600 | 1.3600 | priced
power | 14 | Power_OUT | U4,U5 | CONN-TH_2P-P2.00_HDGC_HDGC2001WV-2P | 2 | HDGC2001WV-2P | HDGC(华德共创) | LCSC | C5175230 | 0.0424 | 0.0848 | priced
power | 15 | MICROUSB | USB1 | MICRO USB | 1 | MICRO5.9mmusb | SHOU HAN | LCSC | C393940 | 0.1722 | 0.1722 | priced
power | 16 | 10K | R5 | 0805 | 1 |  |  |  |  |  |  | missing
power | 17 | 1A5-8V | F1 | F1206 | 1 | JK-nSMD150SF | Shenzhen Jinkaisheng Elec | LCSC | C369553 | 0.2586 | 0.2586 | priced
servo_hat | 1 | ServoPara | LED1 | LED0805_RED | 1 | 17-21SURC/S530-A3/TR8 | EVERLIGHT(台湾亿光) |  | C72037 | 0.1116 | 0.1116 | priced
servo_hat | 2 | ServoA | LED2 | LED0805_GREEN | 1 | NCD0805G1 | 国星光电 |  | C84260 | 0.1200 | 0.1200 | priced
servo_hat | 3 | ServoB | LED3 | LED0805_BLUE | 1 | D-B080508B1-KS2 | 方舟 ARKLED |  | C108412 | 0.1204 | 0.1204 | priced
servo_hat | 4 | Servo | J1 | HDR-M-2.54_1X9 | 1 |  |  | LCSC | C225484 | 0.8787 | 0.8787 | priced
