Robusr/DustArrow/electronics/output/bom/command_b_bom.csv

ID | Name | Designator | Footprint | Quantity | Manufacturer Part | Manufacturer | Supplier | Supplier Part | Price
1 | Connection | FPC1 | FPC-SMD_P1.00-14P_LCS-XJ-H2.5 | 1 | AFA07-S14FCA-00 | JS(钜硕电子) | LCSC | C262720 | 0.6868
2 | MPU6050 | J1 | HDR-M-2.54_1X8 | 1 |  |  | LCSC | C190820 | 0.3252
3 | MCU | U1 | CONN-TH_ER20BGFBK | 1 | ER20BGFBK | WingTAT(格林柏) | LCSC | C5173332 | 3.42
4 | Connection | U2 | CONN-TH_10P-P2.54_WINGTAT_ER10BGFBK | 1 | ER10BGFBK | WingTAT(格林柏) | LCSC | C5173327 | 2.4
5 | GY-BMP280 | U3 | GY-BMP280 | 1
