Robusr/DustArrow/electronics/output/bom/exploration_bom.csv

ID | Name | Designator | Footprint | Quantity | Manufacturer Part | Manufacturer | Supplier | Supplier Part | Price
1 | Power | U2 | CONN-TH_S2B-PH-K-S-LF-SN | 1 | S2B-PH-K-S(LF)(SN) | JST | LCSC | C173752 | 0.1806
2 | Switch | J1 | HDR-M-2.54_1X2 | 1 |  |  | LCSC | C124375 | 0.1546
3 | LED_Power | LED1 | LED0805_RED | 1 | 17-21SURC/S530-A3/TR8 | EVERLIGHT(台湾亿光) |  | C72037 | 0.1116
4 | LED_Data | LED2 | LED0805_GREEN | 1 | NCD0805G1 | 国星光电 |  | C84260 | 0.12
5 | NO | U1 | 2.54MM金手指20PIN | 1
6 | 树莓派-PICO（引脚正常） | M1 | RASPBERRYPI-PICO使用 | 1
