Robusr/DustArrow/electronics/output/bom/power_bom.csv

ID | Name | Designator | Footprint | Quantity | Manufacturer Part | Manufacturer | Supplier | Supplier Part | Price
1 | 1K | R1,R2,R4 | 0805 | 3
2 | 471 | C1,C5,C4 | 0805 | 3
3 | 105 | C2,C6 | 0805 | 2
4 | 0Ω | R3 | 0805 | 1
5 | 10μF | C3,C7 | CAP-SMD_L3.2-W1.6 | 2 | CA45-A010K106T | Xiangyee | LCSC | C119052 | 0.246
6 | 1μH | L1 | IND-SMD_L6.0-W6.0_SMDRS6028 | 1 | PCMB063T-1R0MS | Cyntec | LCSC | C367324 | 1.6845
7 | Power | U2,U3 | CONN-TH_2P-P2.00_HDGC_HDGC2001WV-2P | 2 | HDGC2001WV-2P | HDGC(华德共创) | LCSC | C5175230 | 0.0424
8 | 25% | LED1 | LED0805-RD | 1 | D-G080508G1 | ARKLED | LCSC | C107402 | 0.1324
9 | 50% | LED2 | LED0805-RD | 1 | D-G080508G1 | ARKLED | LCSC | C107402 | 0.1324
10 | 75% | LED3 | LED0805-RD | 1 | D-G080508G1 | ARKLED | LCSC | C107402 | 0.1324
11 | 100% | LED4 | LED0805-RD | 1 | D-G080508G1 | ARKLED | LCSC | C107402 | 0.1324
12 | TS-1187A-B-A-B | SW2 | SW-SMD_4P-L5.1-W5.1-P3.70-LS6.4 | 1 | TS-1187A-B-A-B | XKB Enterprise | LCSC | C318884 | 0.097
13 | IP5306 | U1 | ESOP-8_L4.9-W3.9-P1.27-LS6.0-BL-EP | 1 | IP5306 | INJOINIC | LCSC | C181692 | 1.36
14 | Power_OUT | U4,U5 | CONN-TH_2P-P2.00_HDGC_HDGC2001WV-2P | 2 | HDGC2001WV-2P | HDGC(华德共创) | LCSC | C5175230 | 0.0424
15 | MICROUSB | USB1 | MICRO USB | 1 | MICRO5.9mmusb | SHOU HAN | LCSC | C393940 | 0.1722
16 | 10K | R5 | 0805 | 1
17 | 1A5-8V | F1 | F1206 | 1 | JK-nSMD150SF | Shenzhen Jinkaisheng Elec | LCSC | C369553 | 0.2586
