Robusr/DustArrow/mechanical/output/step/overall_assembly.step

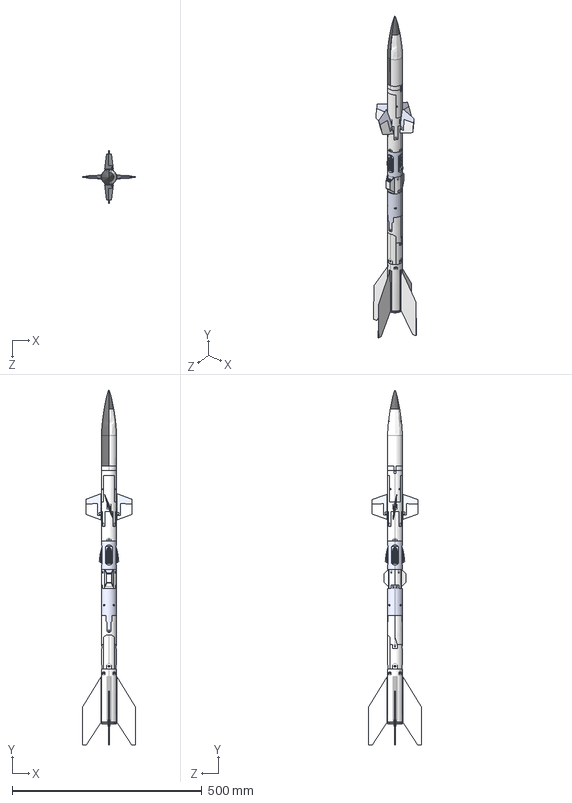
[picture p41: CAD file, 2026-10-19]
mechanical/output/step/overall_assembly.step
139.7 x 935.9 x 139.7 mm
推进舱段主体
推进发动机支撑
YSR-25楷雄儂
电源模块主体
萇喀 x 2
ｵ釀ｴﾄ｣ｿ餘CB
电源模块调试滑动盖板
主控模块主体
主控模块PCB
数据模块主体
数据模块PCB
测控模块主体
Aえ聆諷PCB
Bえ聆諷PCB
烟雾传感器模块主体
烟雾传感器模块PCB
MQ-2ァ极換覜ん
有害气体传感器模块主体
有害气体传感器模块PCB
MQ-135ァ极換覜ん
粉尘传感器模块主体
粉尘传感器模块下端PCB
GP2Y1014AU0F粉尘传感器
粉尘传感器模块上端PCB
鸭翼舱段连接
舵机控制引出PCB
鸭翼舱段主体
ES08AII舵机(部分拟合) x 3
15T舵机臂(部分拟合) x 3
捊秫Aえ x 4
捊秫Bえ x 4
捊秫嘐隅脣种 x 4
鸭翼内直轴
鸭翼传动连杆 x 2
鸭翼内弯轴
伞舱基座
ͷAƬ
ͷBƬ
氶組賑輸
氶組賑輸裔啣
GPS耀輸
陶瓷天线
头锥推出连杆
伞舱舵机轴A段
伞舱舵机轴B段
