Robusr/DustArrow/mechanical/source/draft/3D/航电舱/主控模块/主控模块装配.SLDASM

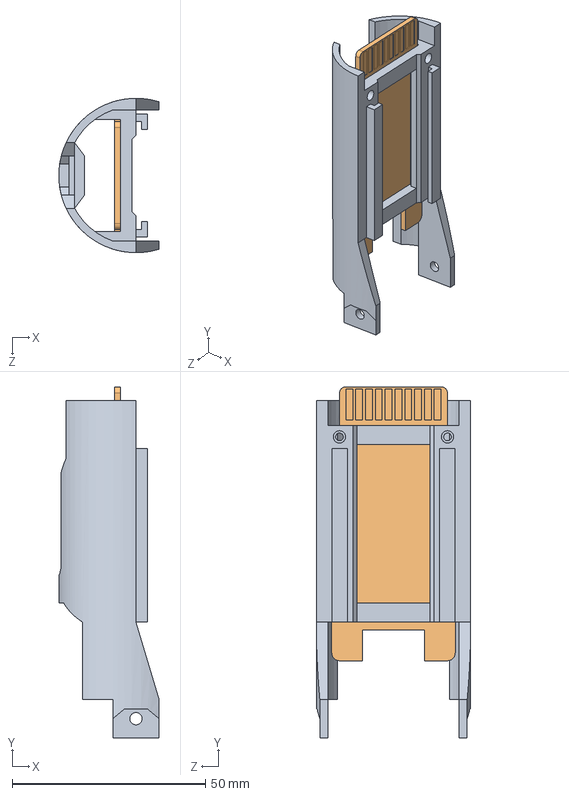
[picture p42: CAD file, 2026-10-19]
mechanical/source/draft/3D/航电舱/主控模块/主控模块装配.SLDASM
26.0 x 90.9 x 40.0 mm
主控模块
主控模块PCB
