Robusr/DustArrow/mechanical/source/draft/3D/航电舱/粉尘传感器模块/粉尘传感器模块装配.SLDASM

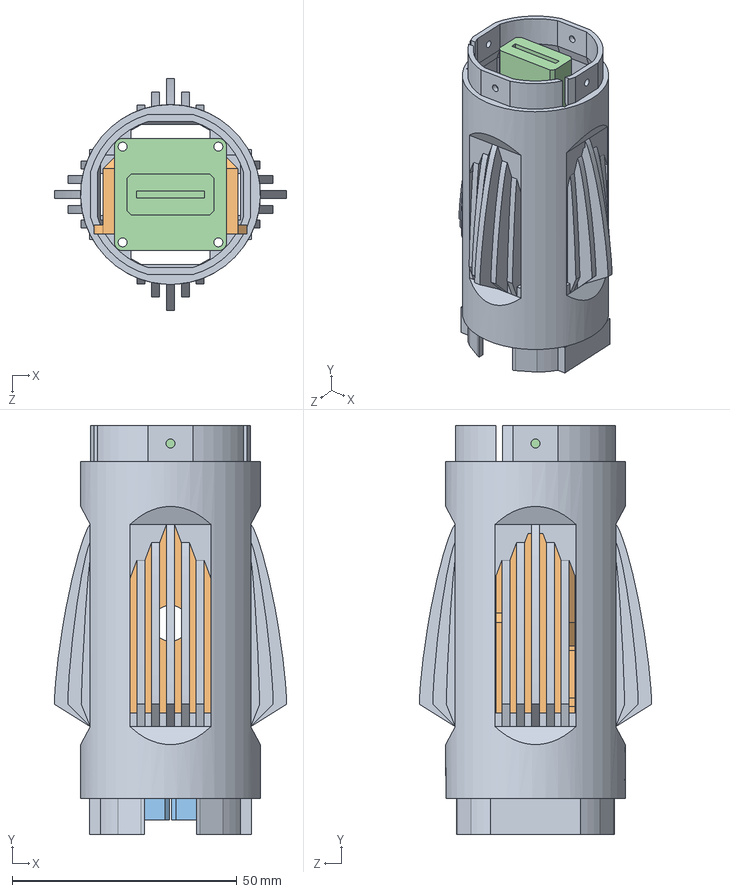
[picture p43: CAD file, 2026-10-19]
mechanical/source/draft/3D/航电舱/粉尘传感器模块/粉尘传感器模块装配.SLDASM
51.7 x 91.0 x 51.7 mm
粉尘传感器模块
GP2Y1014AU0F粉尘传感器
粉尘传感器模块下端PCB
粉尘传感器模块上端PCB
