Robusr/DustArrow/mechanical/source/draft/3D/鸭翼舱/四通道/鸭翼舵机舵臂.SLDASM

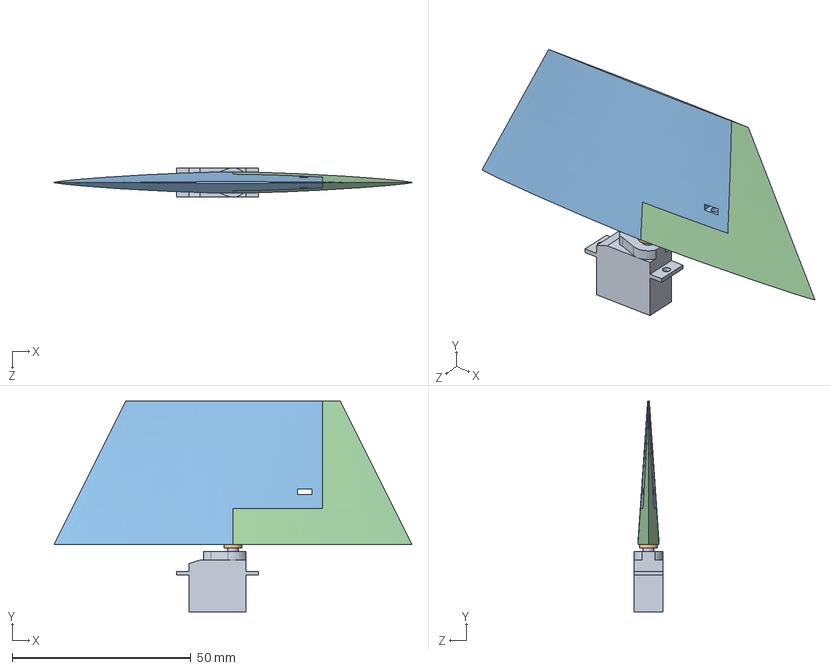
[picture p44: CAD file, 2026-10-19]
mechanical/source/draft/3D/鸭翼舱/四通道/鸭翼舵机舵臂.SLDASM
100.0 x 58.9 x 8.20 mm
AS0017舵机
AS0017舵臂
鸭翼A片
鸭翼B片
