Robusr/DustArrow/mechanical/source/formal/装配/整体装配.SLDASM

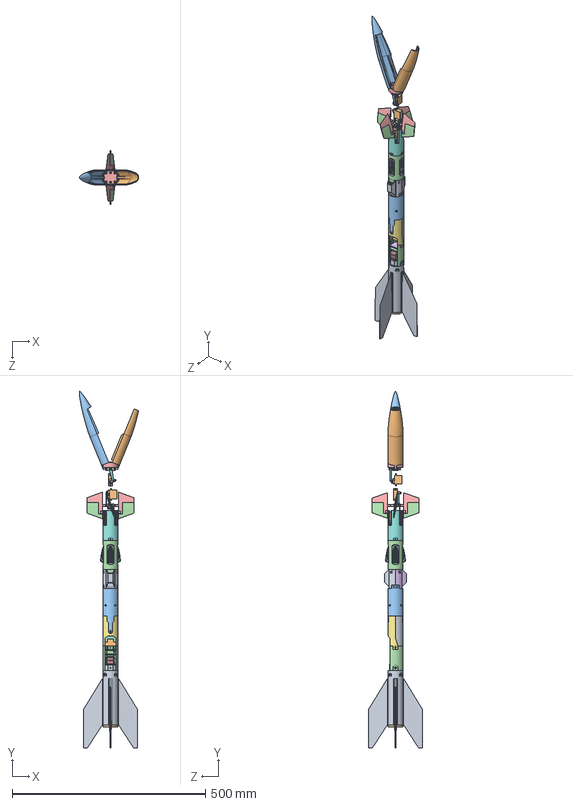
[picture p45: CAD file, 2026-10-19]
mechanical/source/formal/装配/整体装配.SLDASM
153.7 x 924.2 x 139.7 mm
推进舱段主体
推进发动机支撑
YSR-25发动机
电源模块主体
电池 x 2
电源模块PCB
主控模块主体
主控模块PCB
数据模块主体
数据模块PCB
测控模块主体
A片测控PCB
B片测控PCB
烟雾传感器模块主体
烟雾传感器模块PCB
MQ-2气体传感器
有害气体传感器模块主体
有害气体传感器模块PCB
MQ-135气体传感器
粉尘传感器模块主体
粉尘传感器模块下端PCB
GP2Y1014AU0F粉尘传感器
粉尘传感器模块上端PCB
鸭翼舱段连接
舵机控制引出PCB
ES08AII舵机(部分拟合) x 3
15T舵机臂(部分拟合) x 3
鸭翼A片 x 4
鸭翼B片 x 4
鸭翼固定插销 x 4
鸭翼内直轴
鸭翼传动连杆 x 2
鸭翼内弯轴
头锥A片
头锥B片
伞舱滑块
伞舱滑块盖板
GPS模块
陶瓷天线
头锥推出连杆
伞舱舵机轴A段
伞舱舵机轴B段
