Robusr/DustArrow/mechanical/source/formal/零件/模块化舱段/数据模块/分体装配/数据模块装配.SLDASM

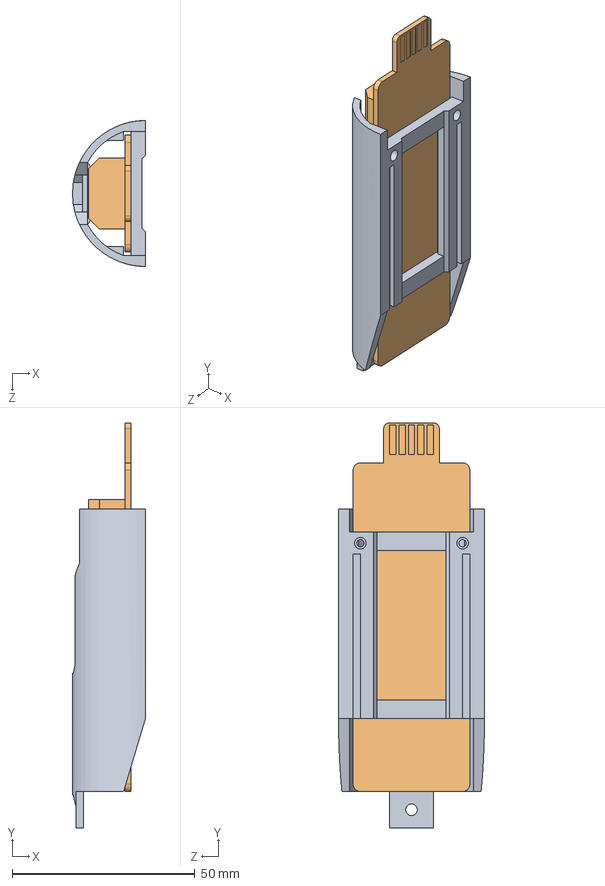
[picture p46: CAD file, 2026-10-19]
mechanical/source/formal/零件/模块化舱段/数据模块/分体装配/数据模块装配.SLDASM
20.0 x 110.9 x 40.0 mm
数据模块主体
数据模块PCB
