Robusr/DustArrow/mechanical/source/formal/零件/模块化舱段/测控模块/分体装配/测控模块装配.SLDASM

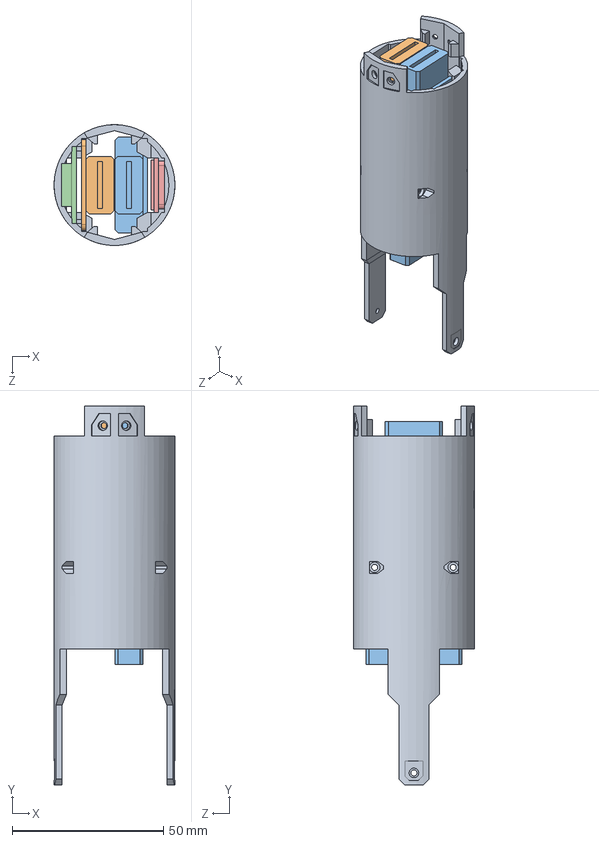
[picture p47: CAD file, 2026-10-19]
mechanical/source/formal/零件/模块化舱段/测控模块/分体装配/测控模块装配.SLDASM
40.0 x 125.4 x 40.0 mm
测控模块主体
A片测控PCB
B片测控PCB
GPS模块
陶瓷天线
