Robusr/DustArrow/mechanical/source/formal/零件/模块化舱段/烟雾传感器/分体装配/烟雾模块装配.SLDASM

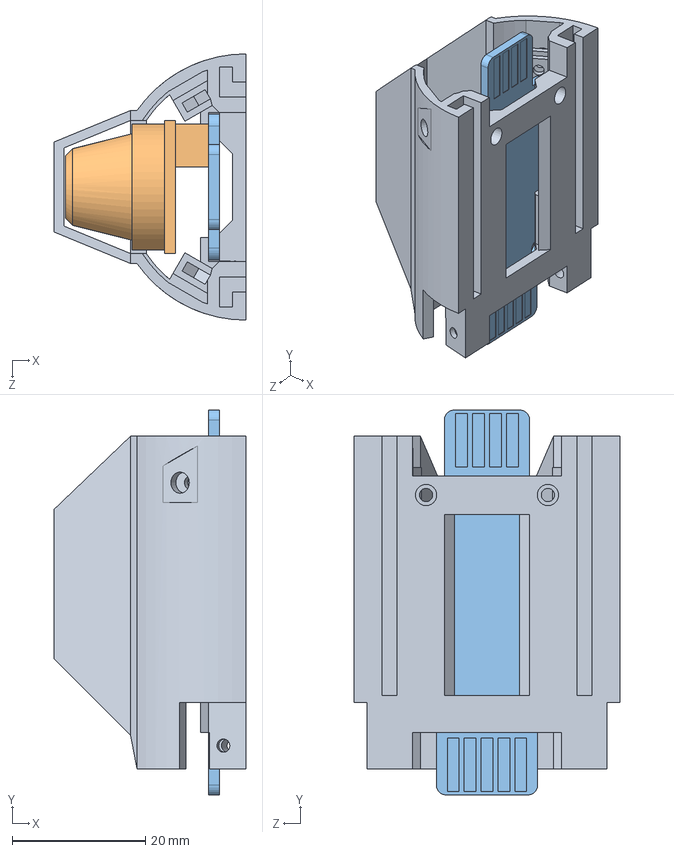
[picture p48: CAD file, 2026-10-19]
mechanical/source/formal/零件/模块化舱段/烟雾传感器/分体装配/烟雾模块装配.SLDASM
28.8 x 57.8 x 40.0 mm
烟雾传感器模块主体
MQ-2气体传感器
烟雾传感器模块PCB
