Robusr/DustArrow/mechanical/source/formal/零件/降落伞舱段/分体装配/伞舱装配.SLDASM

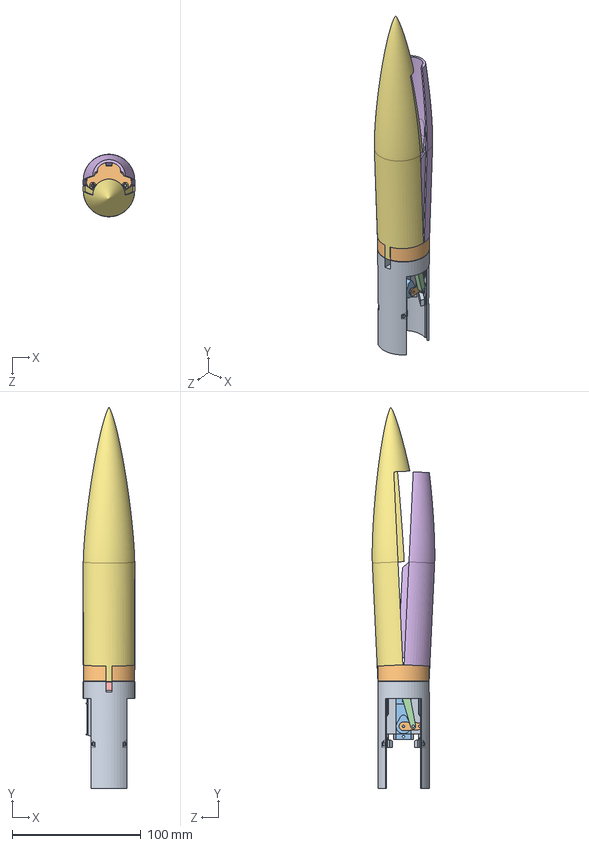
[picture p49: CAD file, 2026-10-19]
mechanical/source/formal/零件/降落伞舱段/分体装配/伞舱装配.SLDASM
40.0 x 295.8 x 48.6 mm
伞舱基座
15T舵机臂(部分拟合)
ES08AII舵机(部分拟合)
头锥推出连杆
伞舱滑块
头锥A片
头锥B片
伞舱舵机轴A段
伞舱舵机轴B段
