Robusr/DustArrow/mechanical/source/formal/零件/鸭翼舱段/分体装配/鸭翼装配.SLDASM

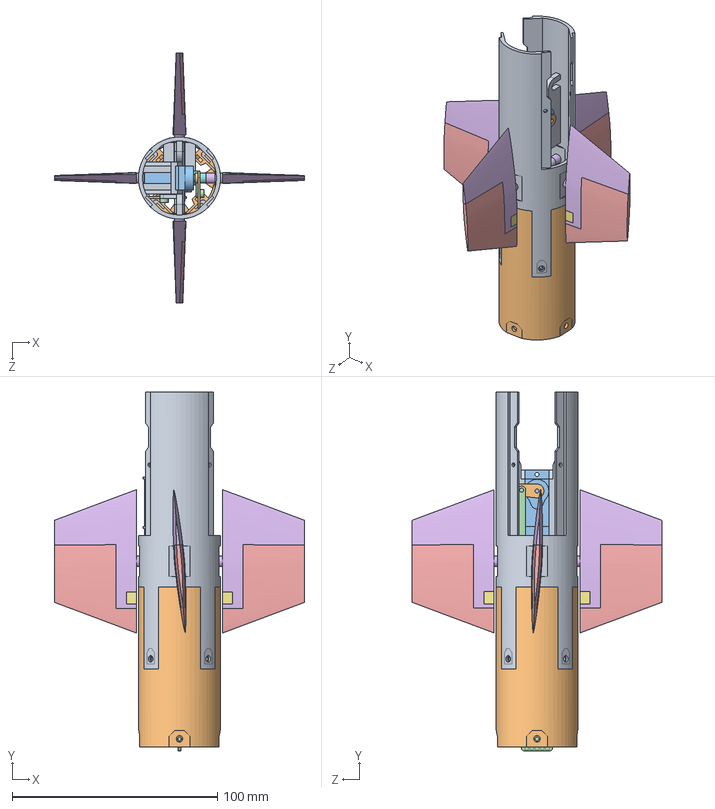
[picture p50: CAD file, 2026-10-19]
mechanical/source/formal/零件/鸭翼舱段/分体装配/鸭翼装配.SLDASM
121.9 x 174.9 x 121.9 mm
鸭翼舱段主体
15T舵机臂(部分拟合) x 2
ES08AII舵机(部分拟合) x 2
鸭翼传动连杆 x 2
鸭翼A片 x 4
鸭翼B片 x 4
鸭翼固定插销 x 4
鸭翼内弯轴
鸭翼内直轴
鸭翼舱段连接
舵机插头
舵机控制引出PCB
