Robusr/DustArrow/mechanical/source/draft/3D/航电舱/数据模块/数据模块装配测试.SLDASM

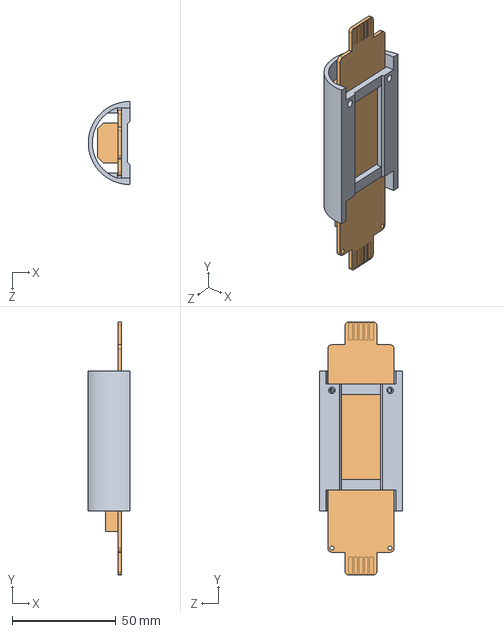
[picture p51: CAD file, 2026-10-19]
mechanical/source/draft/3D/航电舱/数据模块/数据模块装配测试.SLDASM
20.0 x 121.8 x 40.0 mm
数据模块测试
数据模块PCB
