Robusr/DustArrow/mechanical/source/draft/3D/航电舱/烟雾传感器模块/气体模块连接装配.SLDASM

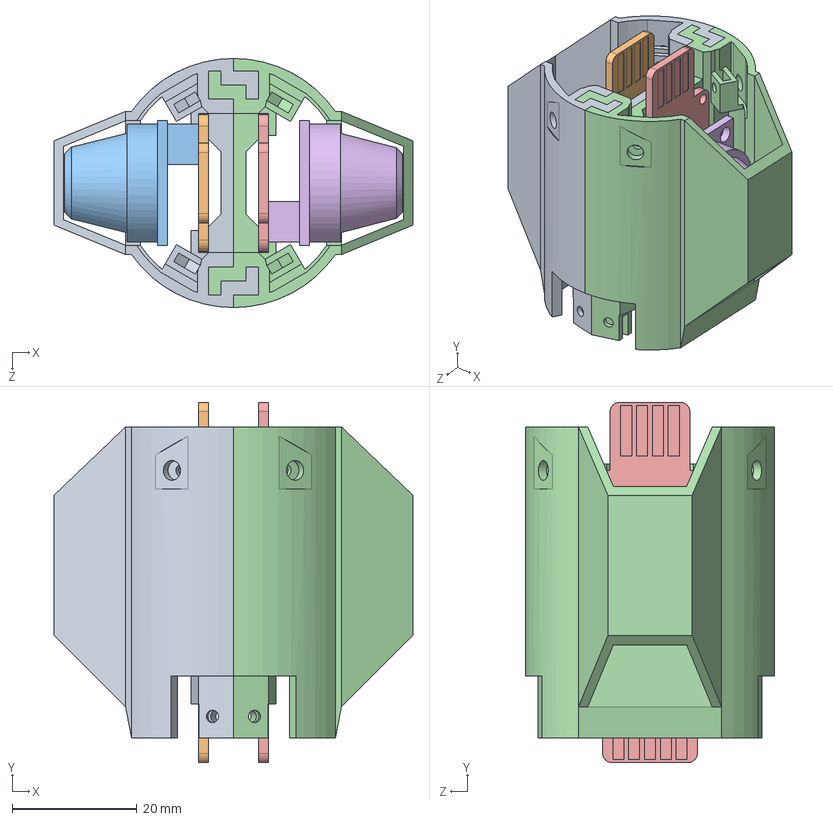
[picture p52: CAD file, 2026-10-19]
mechanical/source/draft/3D/航电舱/烟雾传感器模块/气体模块连接装配.SLDASM
57.6 x 57.8 x 40.0 mm
烟雾传感器模块
烟雾传感器模块PCB
MQ-2气体传感器
有害气体传感器模块
有害气体传感器模块PCB
MQ-135气体传感器
