Robusr/DustArrow/mechanical/source/draft/3D/鸭翼舱/两通道/X轴鸭翼装配.SLDASM

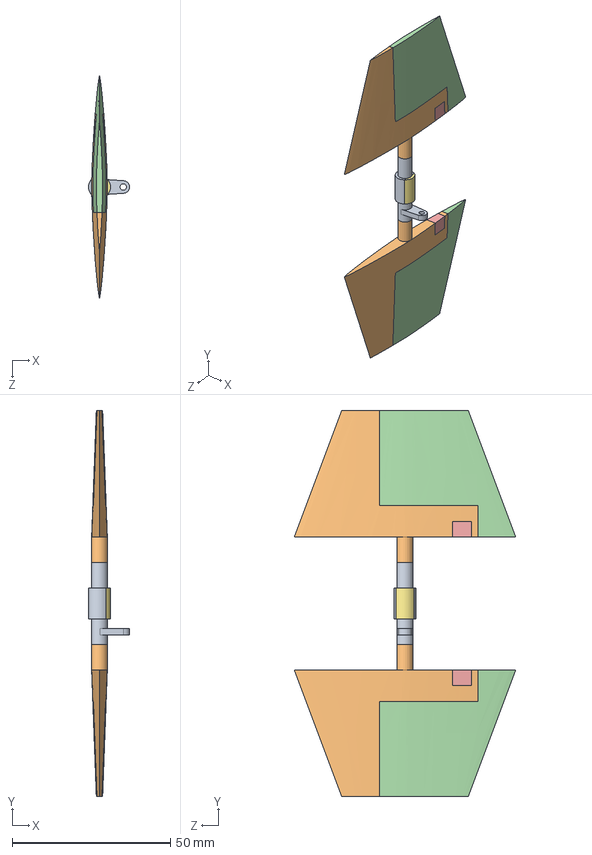
[picture p53: CAD file, 2026-10-19]
mechanical/source/draft/3D/鸭翼舱/两通道/X轴鸭翼装配.SLDASM
13.0 x 121.9 x 70.0 mm
内直连杆
两通道鸭翼B片 x 2
M2-20螺丝 x 2
两通道鸭翼A片 x 2
鸭翼固定插销 x 2
M2螺母 x 2
内直螺母固定插销
