Robusr/DustArrow/mechanical/source/draft/草图/鸭翼伞舱连接段装配测试、.SLDASM

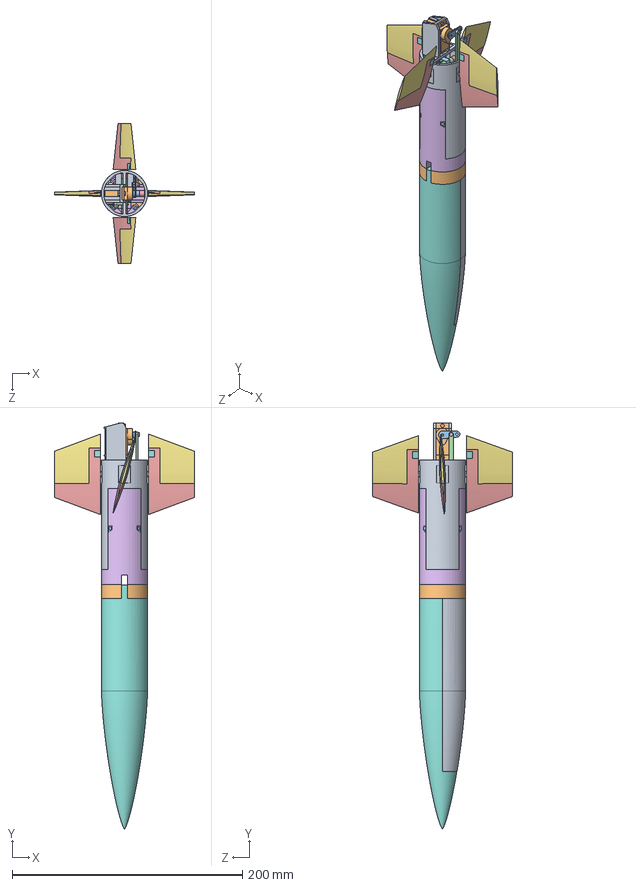
[picture p54: CAD file, 2026-10-19]
mechanical/source/draft/草图/鸭翼伞舱连接段装配测试、.SLDASM
121.9 x 352.6 x 121.9 mm
两通道鸭翼舱精简
ES08AII舵机(部分拟合) x 3
15T舵机臂(部分拟合) x 3
内直连杆
两通道鸭翼B片 x 4
M2-20螺丝 x 4
两通道鸭翼A片 x 4
鸭翼固定插销 x 4
M2螺母 x 11
内直螺母固定插销
内弯连杆
直连传动杆 x 2
M2-5螺丝 x 8
滑杆基座
滑杆
头锥B片
头锥A片
竖直滑道上盖板
M2-10螺丝 x 3
