Robusr/DustArrow/mechanical/source/draft/草图/总装配测试4.SLDASM

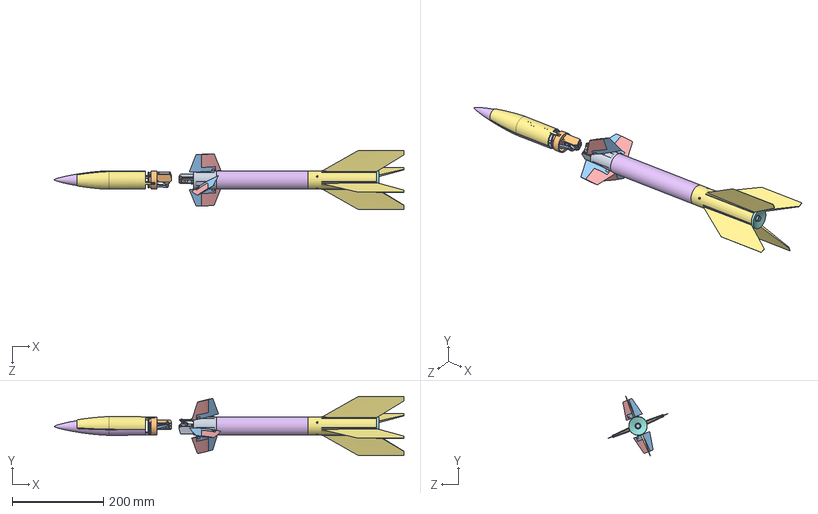
[picture p55: CAD file, 2026-10-19]
mechanical/source/draft/草图/总装配测试4.SLDASM
765.6 x 129.3 x 129.3 mm
两通道鸭翼舱优化
内直连杆
两通道鸭翼B片 x 4
M2-20螺丝 x 4
两通道鸭翼A片 x 4
鸭翼固定插销 x 4
M2螺母 x 12
内直螺母固定插销
ES08AII舵机(部分拟合) x 3
15T舵机臂(部分拟合) x 3
内弯连杆
M2-4螺丝 x 8
直连传动杆 x 2
航电舱测试
动力一体舱段平滑曲面
发动机支撑
YSR-25发动机
滑杆基座
滑杆
开口测试2 x 2
竖直滑道
头锥A片
头锥B片
