Robusr/DustArrow/mechanical/source/draft/3D/伞舱/头锥装配.SLDASM

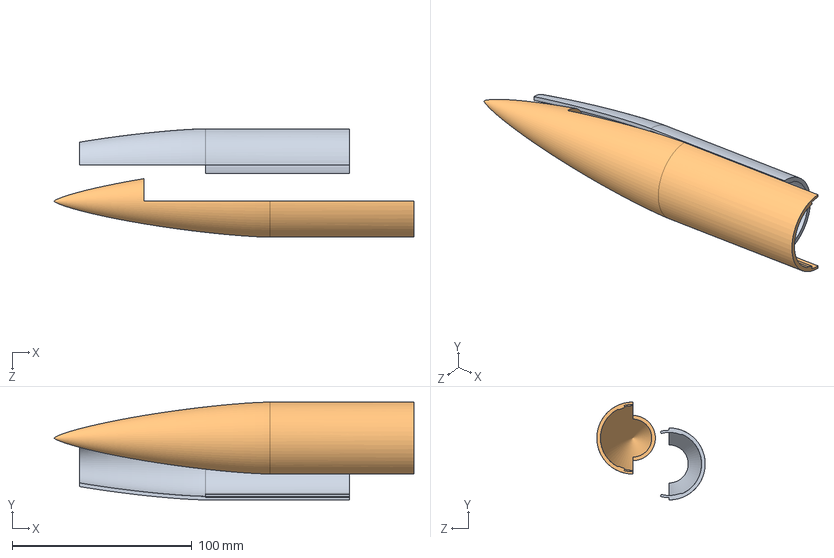
[picture p56: CAD file, 2026-10-19]
mechanical/source/draft/3D/伞舱/头锥装配.SLDASM
200.0 x 54.4 x 60.2 mm
头锥A片
头锥B片
