Robusr/DustArrow/mechanical/source/draft/3D/伞舱/伞舱装配测试1.SLDASM

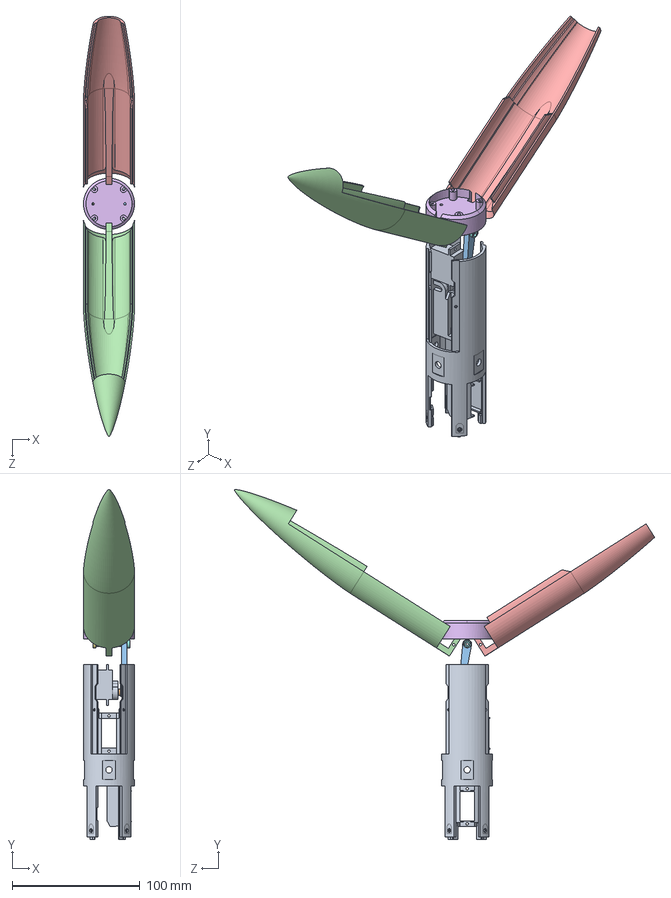
[picture p57: CAD file, 2026-10-19]
mechanical/source/draft/3D/伞舱/伞舱装配测试1.SLDASM
40.0 x 273.9 x 329.0 mm
ES08AII舵机(部分拟合)
15T舵机臂(部分拟合)
滑杆
头锥B片
头锥A片
竖直滑道上盖板
伞舱舵机轴B段
伞舱舵机轴A段
两通道鸭翼舱精简
