Robusr/DustArrow/mechanical/source/draft/草图/总装配测试5.SLDASM

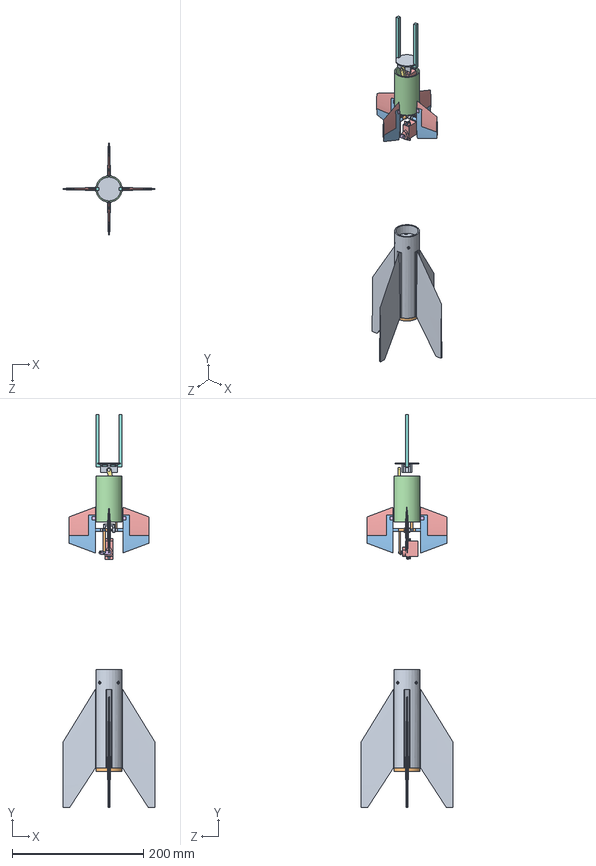
[picture p58: CAD file, 2026-10-19]
mechanical/source/draft/草图/总装配测试5.SLDASM
139.7 x 598.5 x 139.7 mm
动力一体舱段平滑曲面
发动机支撑
YSR-25发动机
伞舱测试
ES08AII舵机(部分拟合) x 3
15T舵机臂(部分拟合) x 3
滑杆
开口测试2 x 2
竖直滑道
内直连杆
两通道鸭翼B片 x 4
M2-20螺丝 x 4
两通道鸭翼A片 x 4
鸭翼固定插销 x 4
M2螺母 x 11
内直螺母固定插销
内弯连杆
直连传动杆 x 2
M2-5螺丝 x 8
