Robusr/DustArrow/mechanical/source/draft/草图/总装配测试3.SLDASM

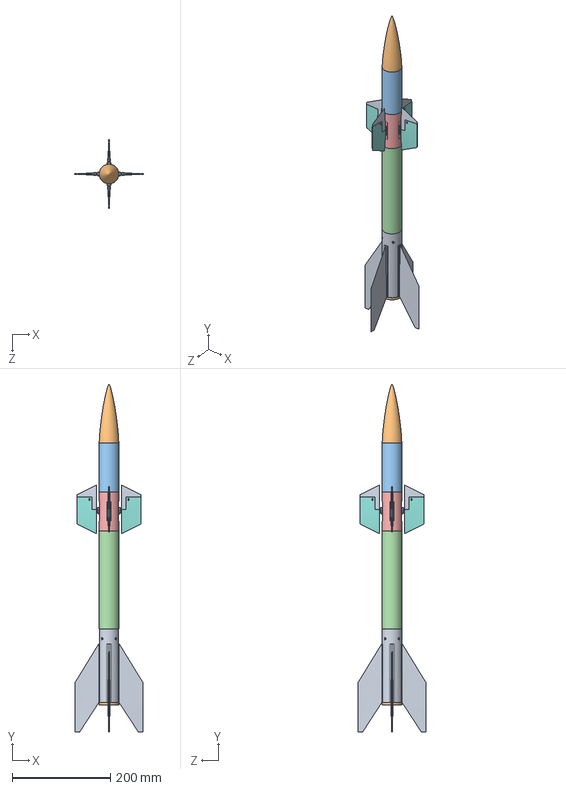
[picture p60: CAD file, 2026-10-19]
mechanical/source/draft/草图/总装配测试3.SLDASM
139.7 x 710.0 x 139.7 mm
动力一体舱段平滑曲面
发动机支撑
YSR-25发动机
航电舱测试
鸭翼舱
AS0017舵机 x 4
AS0017舵臂 x 4
鸭翼A片 x 4
鸭翼B片 x 4
头锥测试
伞舱测试
