Robusr/DustArrow/mechanical/source/draft/草图/鸭翼舱装配测试1.SLDASM

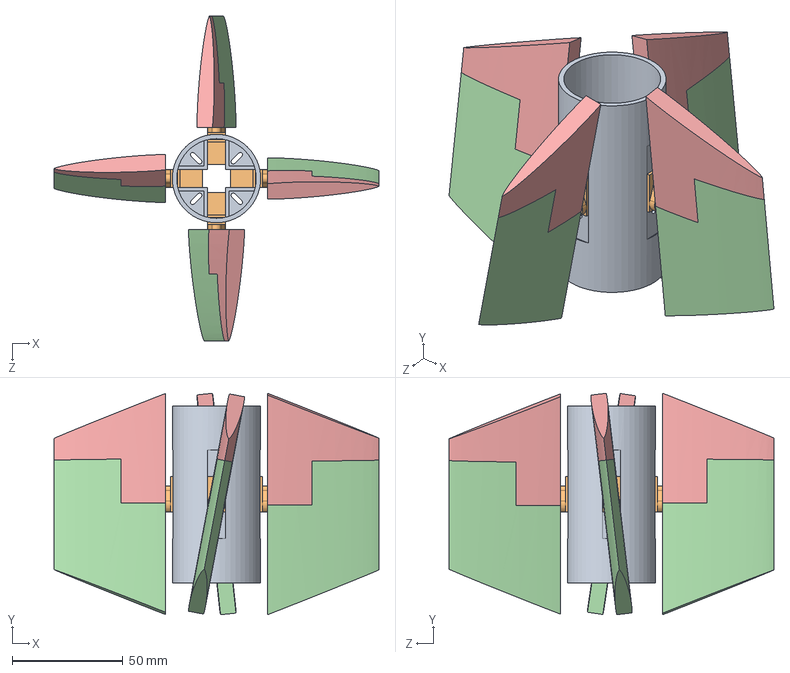
[picture p61: CAD file, 2026-10-19]
mechanical/source/draft/草图/鸭翼舱装配测试1.SLDASM
147.0 x 100.2 x 147.0 mm
鸭翼舱
AS0017舵机 x 4
舵臂测试 x 4
鸭翼测试2 x 4
鸭翼测试3 x 4
