Robusr/DustArrow/mechanical/output/3dp/propulsion_bay_body.stl

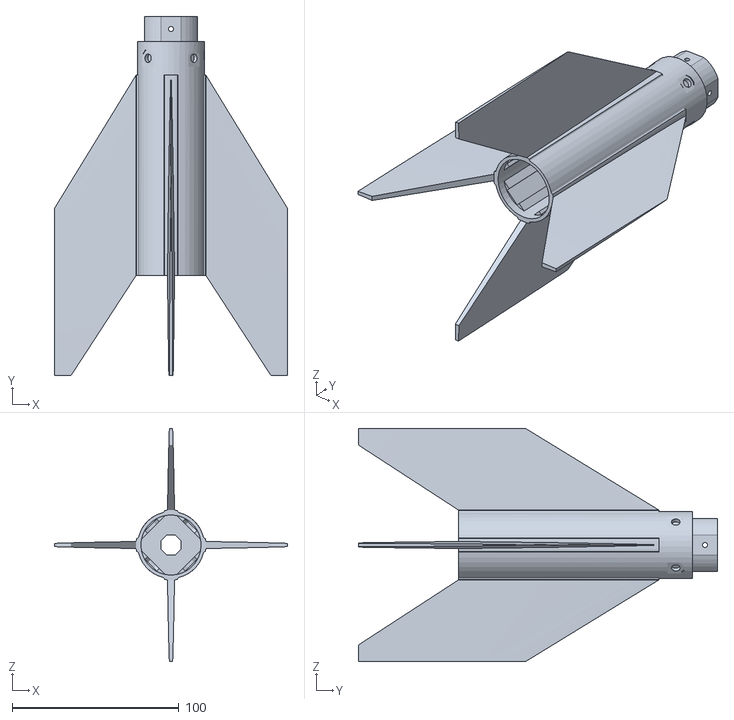
[picture p62: CAD file, 2026-10-19]
mechanical/output/3dp/propulsion_bay_body.stl
139.7 x 215.0 x 139.7
