Robusr/DustArrow/mechanical/output/reprint/reprint_parachute_bay_slider_cover.stl

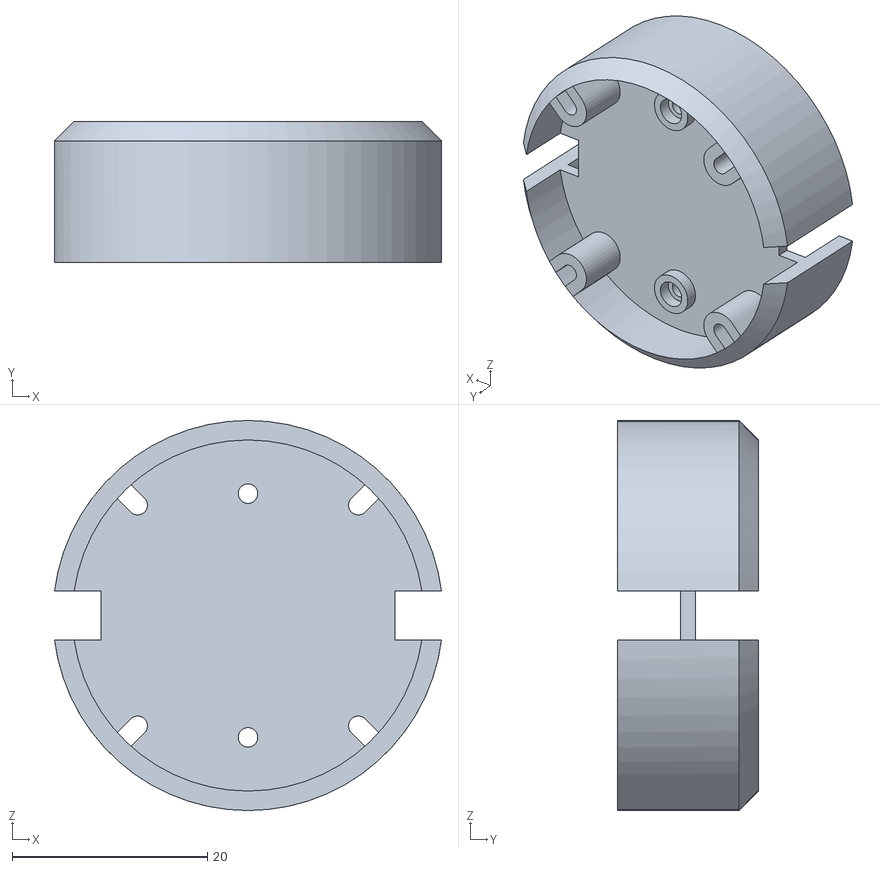
[picture p63: CAD file, 2026-10-19]
mechanical/output/reprint/reprint_parachute_bay_slider_cover.stl
39.7 x 14.5 x 40.0
