Robusr/DustArrow/mechanical/source/draft/3D/伞舱/连接杆测试.SLDPRT

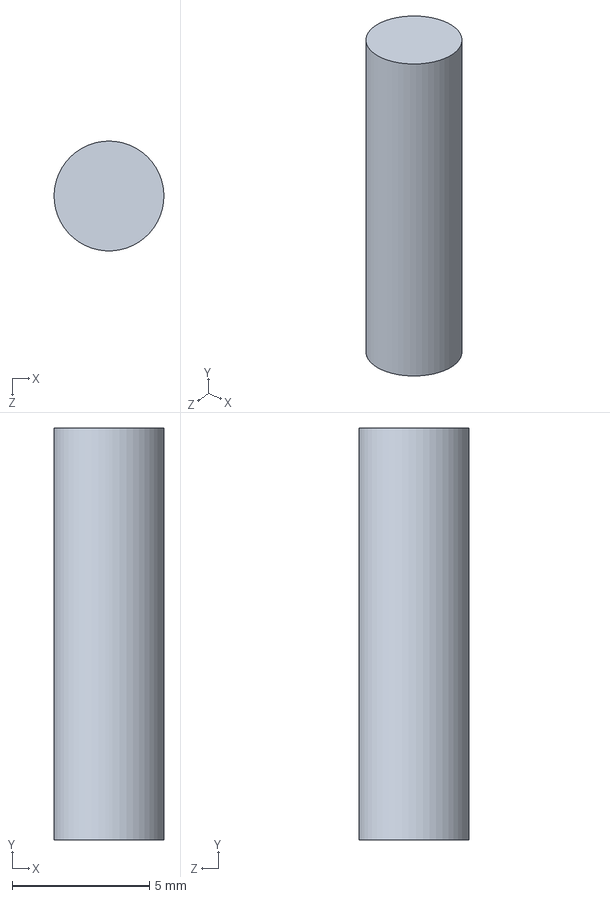
[picture p64: CAD file, 2026-10-19]
mechanical/source/draft/3D/伞舱/连接杆测试.SLDPRT
4.00 x 15.0 x 4.00 mm
