Robusr/DustArrow/mechanical/source/draft/3D/推进舱/动力一体舱段.SLDPRT

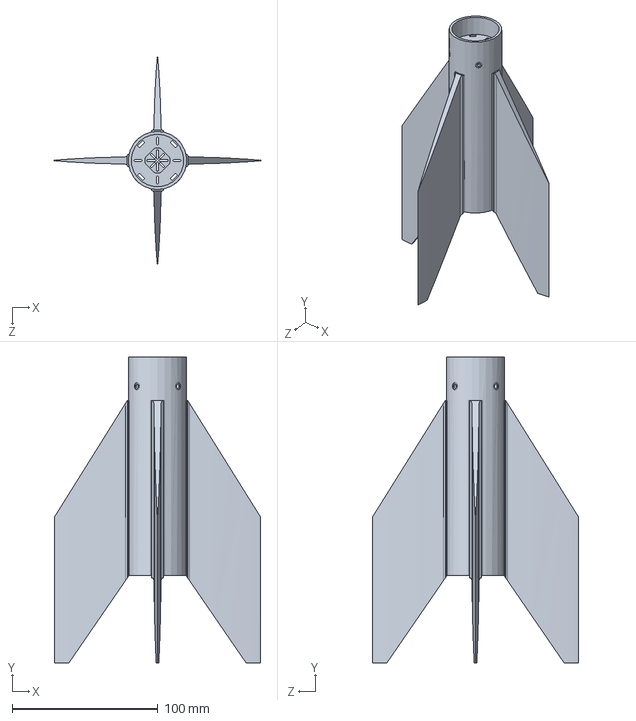
[picture p65: CAD file, 2026-10-19]
mechanical/source/draft/3D/推进舱/动力一体舱段.SLDPRT
141.7 x 210.0 x 141.7 mm
