Robusr/DustArrow/mechanical/source/draft/3D/航电舱/伞舱鸭翼/舵机插头.SLDPRT

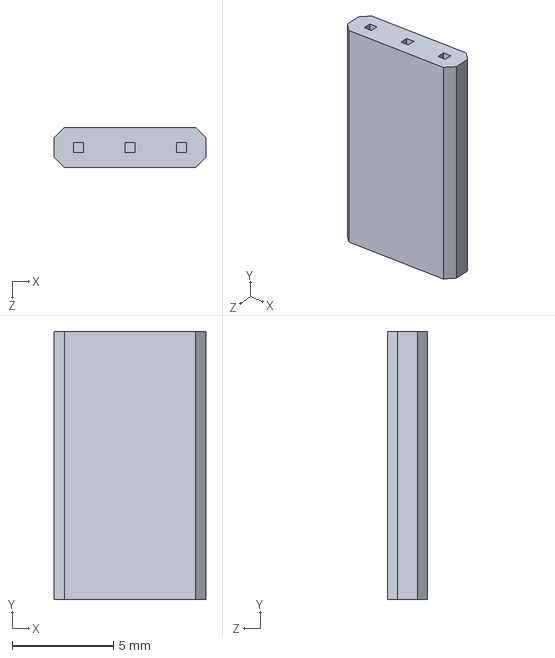
[picture p66: CAD file, 2026-10-19]
mechanical/source/draft/3D/航电舱/伞舱鸭翼/舵机插头.SLDPRT
7.50 x 13.2 x 2.00 mm
