Robusr/DustArrow/mechanical/source/draft/3D/航电舱/有害气体传感器模块/有害气体传感器模块.SLDPRT

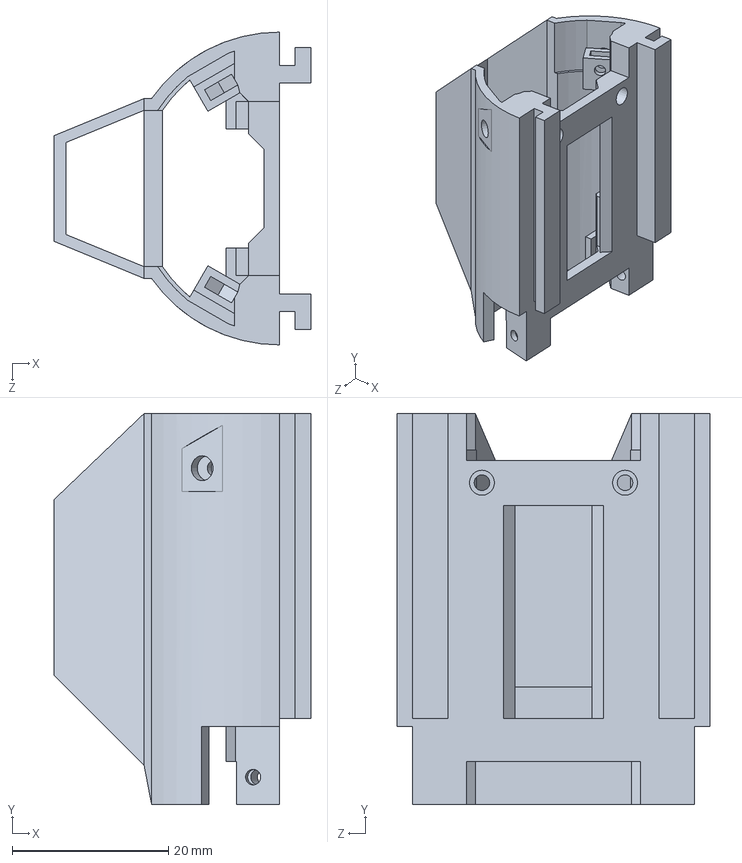
[picture p68: CAD file, 2026-10-19]
mechanical/source/draft/3D/航电舱/有害气体传感器模块/有害气体传感器模块.SLDPRT
32.8 x 50.0 x 40.0 mm
