Robusr/DustArrow/mechanical/source/draft/3D/航电舱/测控模块/B片测控PCB.SLDPRT

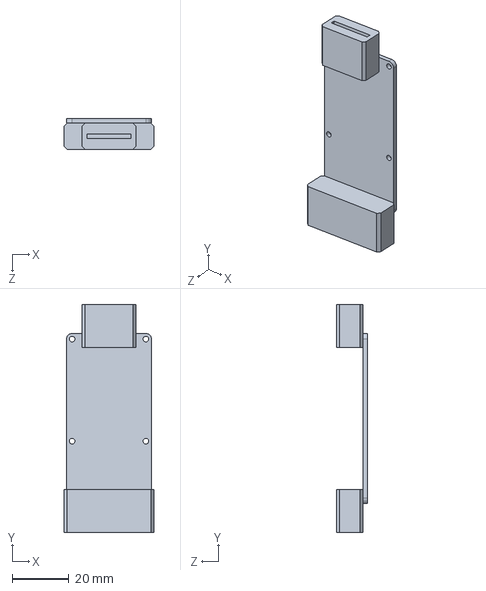
[picture p69: CAD file, 2026-10-19]
mechanical/source/draft/3D/航电舱/测控模块/B片测控PCB.SLDPRT
31.7 x 80.4 x 10.8 mm
