Robusr/DustArrow/mechanical/source/draft/3D/航电舱/烟雾传感器模块/MQ-2气体传感器.SLDPRT

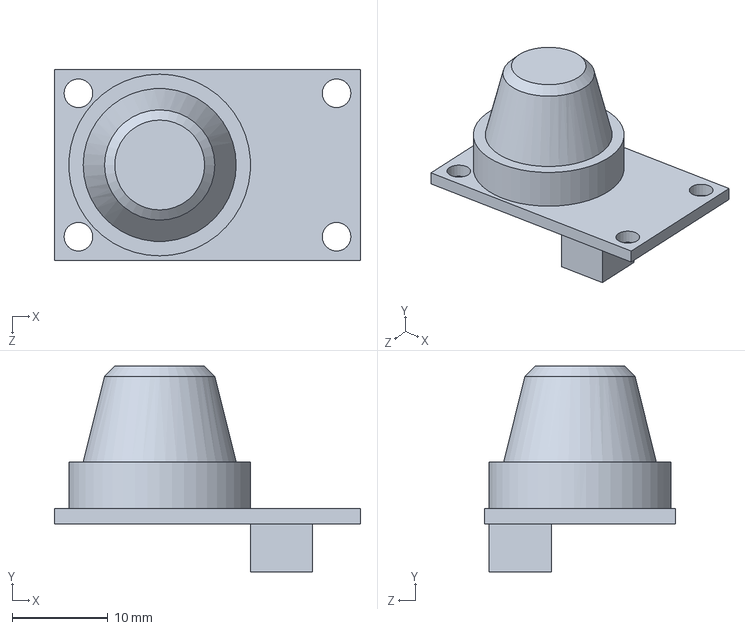
[picture p70: CAD file, 2026-10-19]
mechanical/source/draft/3D/航电舱/烟雾传感器模块/MQ-2气体传感器.SLDPRT
32.0 x 21.5 x 20.0 mm
