Robusr/DustArrow/mechanical/source/draft/3D/航电舱/电源模块/电池.SLDPRT

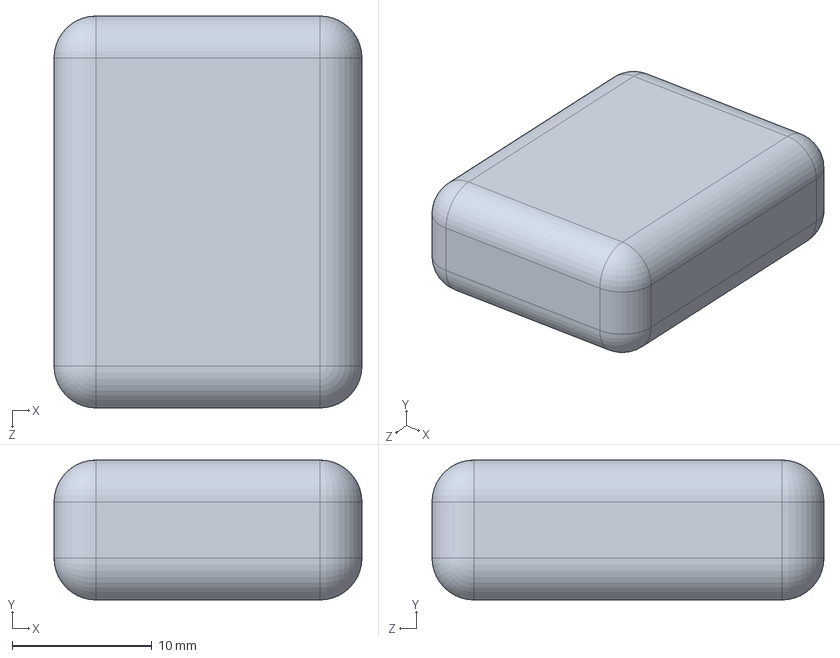
[picture p71: CAD file, 2026-10-19]
mechanical/source/draft/3D/航电舱/电源模块/电池.SLDPRT
22.0 x 10.0 x 28.0 mm
