Robusr/DustArrow/mechanical/source/draft/3D/鸭翼舱/两通道/内直螺母固定插销.SLDPRT

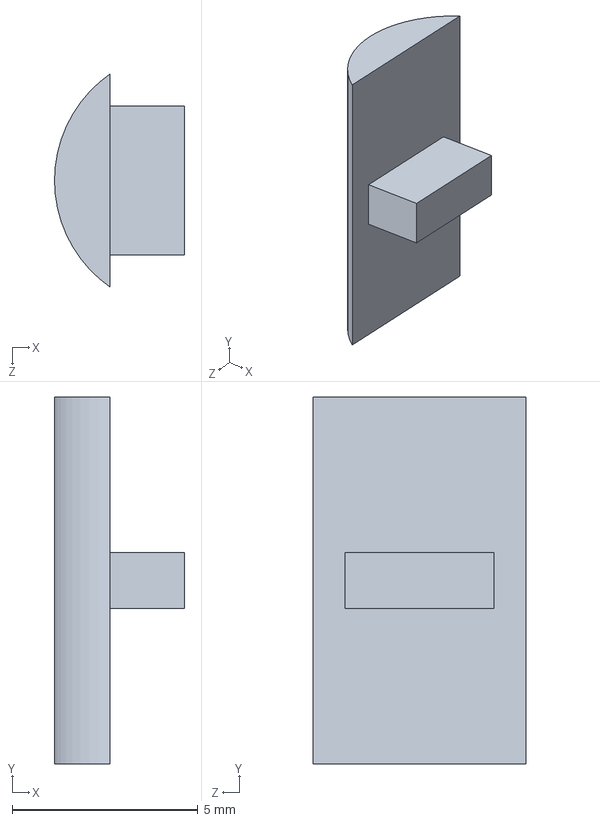
[picture p72: CAD file, 2026-10-19]
mechanical/source/draft/3D/鸭翼舱/两通道/内直螺母固定插销.SLDPRT
3.50 x 9.88 x 5.74 mm
