Robusr/DustArrow/mechanical/source/draft/草图/连接件测试.SLDPRT

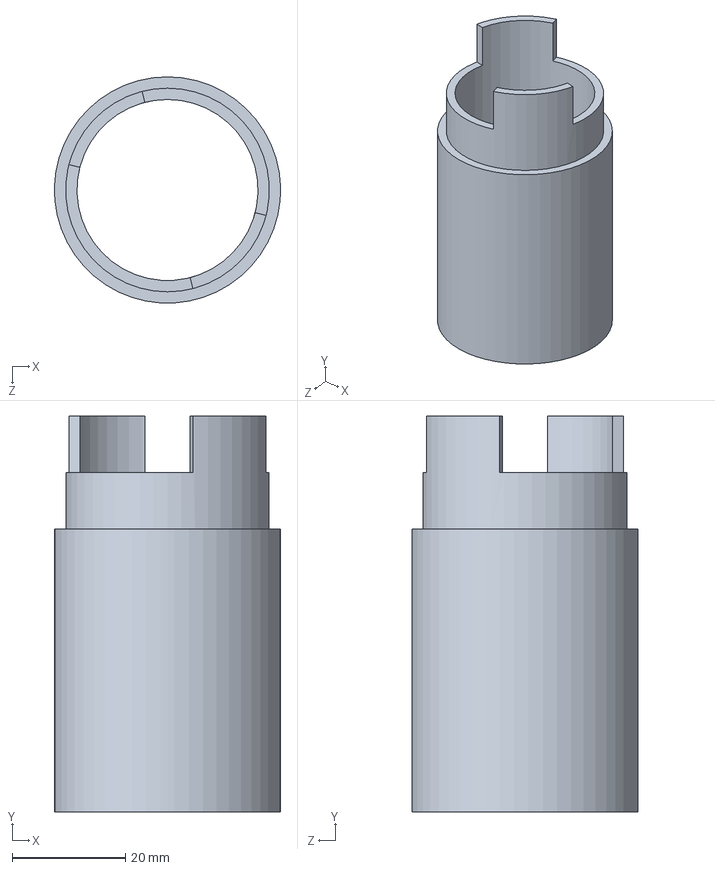
[picture p73: CAD file, 2026-10-19]
mechanical/source/draft/草图/连接件测试.SLDPRT
40.0 x 70.0 x 40.0 mm
