Robusr/DustArrow/mechanical/source/formal/3D打印/原文件/鸭翼舱段连接.SLDPRT

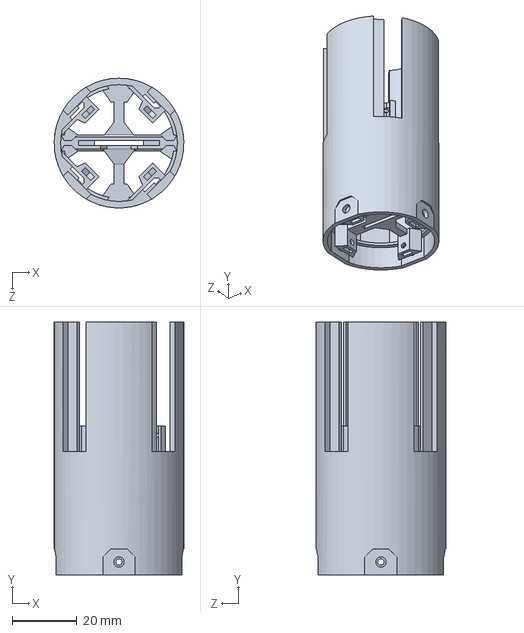
[picture p74: CAD file, 2026-10-19]
mechanical/source/formal/3D打印/原文件/鸭翼舱段连接.SLDPRT
40.0 x 78.0 x 40.0 mm
