Robusr/DustArrow/mechanical/source/formal/零件/推进尾翼舱段/推进发动机支撑.SLDPRT

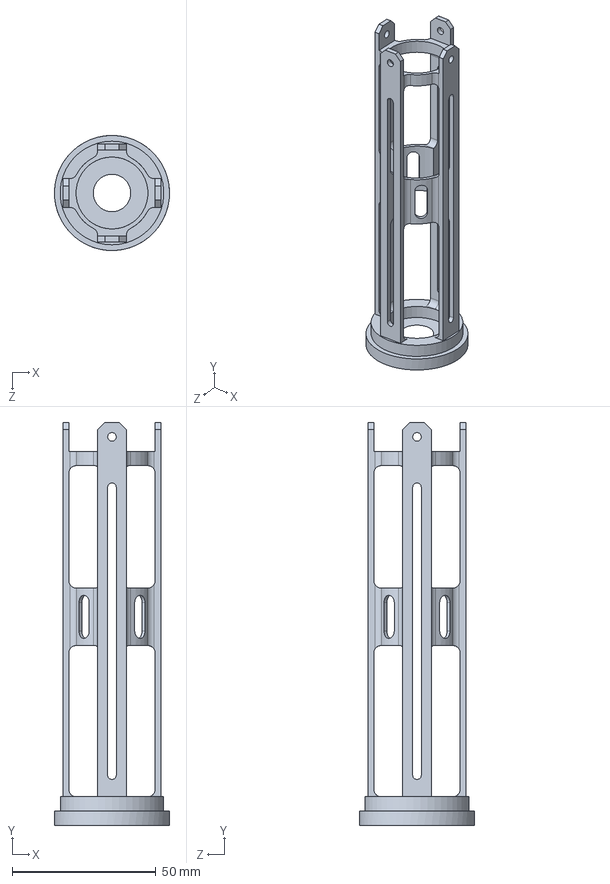
[picture p75: CAD file, 2026-10-19]
mechanical/source/formal/零件/推进尾翼舱段/推进发动机支撑.SLDPRT
40.0 x 140.0 x 40.0 mm
