Robusr/DustArrow/mechanical/source/formal/零件/推进尾翼舱段/模拟/YSR-25发动机.SLDPRT

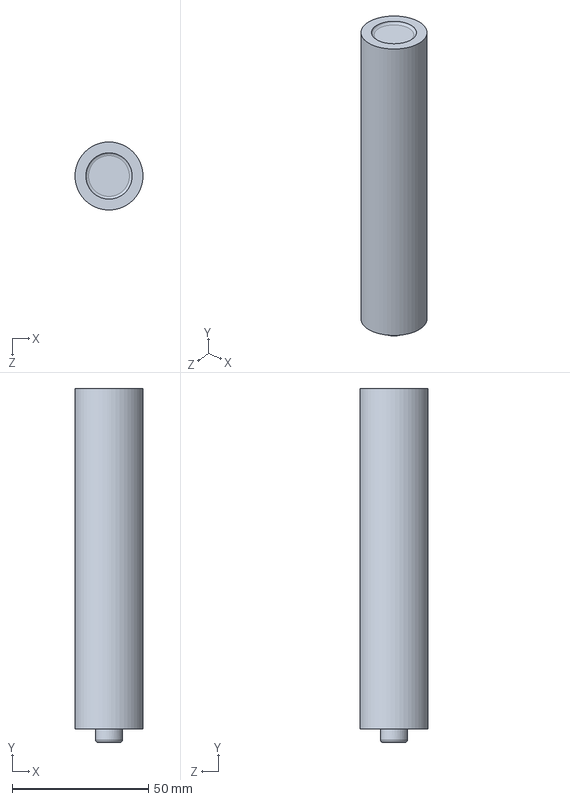
[picture p76: CAD file, 2026-10-19]
mechanical/source/formal/零件/推进尾翼舱段/模拟/YSR-25发动机.SLDPRT
25.0 x 130.0 x 25.0 mm
