Robusr/DustArrow/mechanical/source/formal/零件/模块化舱段/测控模块/模拟/A片测控PCB.SLDPRT

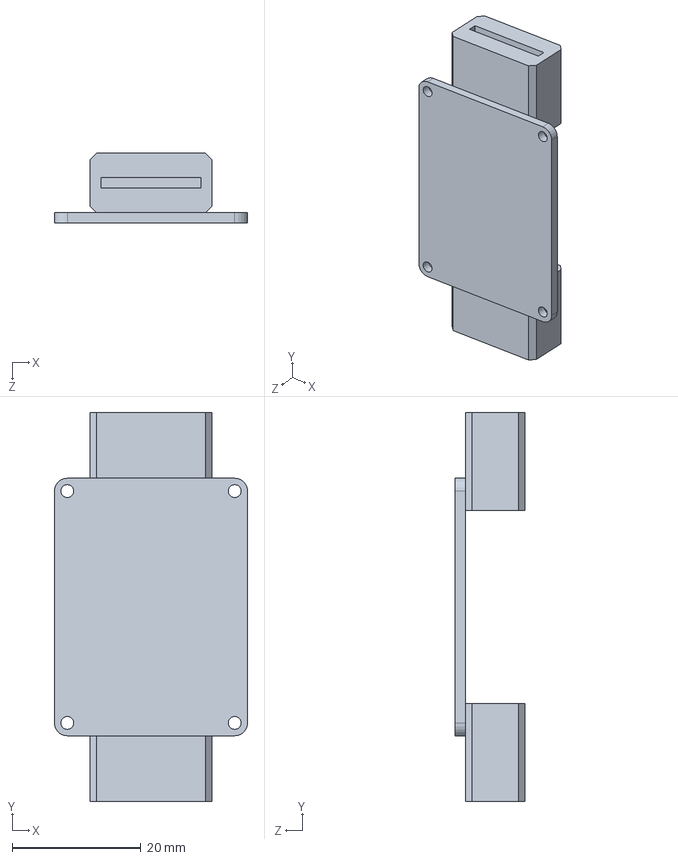
[picture p77: CAD file, 2026-10-19]
mechanical/source/formal/零件/模块化舱段/测控模块/模拟/A片测控PCB.SLDPRT
30.0 x 60.4 x 10.8 mm
