Robusr/DustArrow/mechanical/source/formal/零件/模块化舱段/测控模块/测控模块主体.SLDPRT

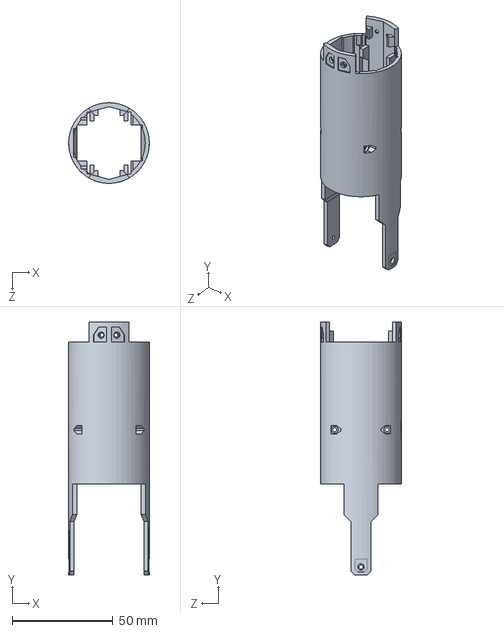
[picture p78: CAD file, 2026-10-19]
mechanical/source/formal/零件/模块化舱段/测控模块/测控模块主体.SLDPRT
40.0 x 125.4 x 40.0 mm
