Robusr/DustArrow/mechanical/source/formal/零件/模块化舱段/烟雾传感器/模拟/烟雾传感器模块PCB.SLDPRT

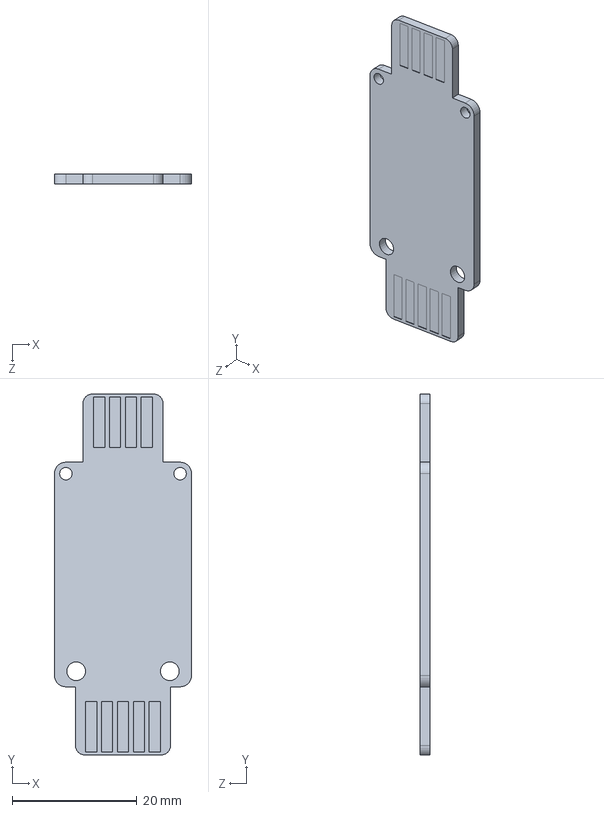
[picture p79: CAD file, 2026-10-19]
mechanical/source/formal/零件/模块化舱段/烟雾传感器/模拟/烟雾传感器模块PCB.SLDPRT
22.0 x 57.8 x 1.60 mm
