Robusr/DustArrow/mechanical/source/formal/零件/模块化舱段/电源模块/电源模块主体.SLDPRT

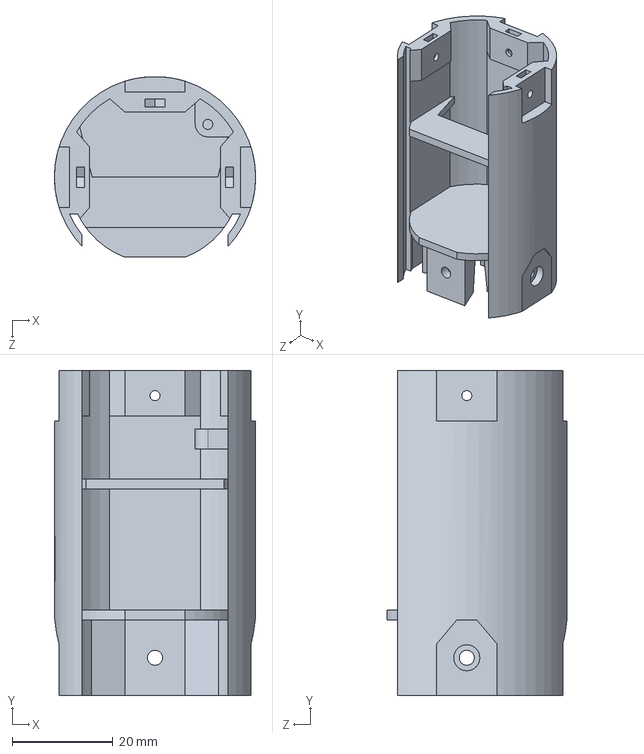
[picture p80: CAD file, 2026-10-19]
mechanical/source/formal/零件/模块化舱段/电源模块/电源模块主体.SLDPRT
40.0 x 64.6 x 35.9 mm
