Robusr/DustArrow/mechanical/source/formal/零件/模块化舱段/粉尘传感器/模拟/GP2Y1014AU0F粉尘传感器.SLDPRT

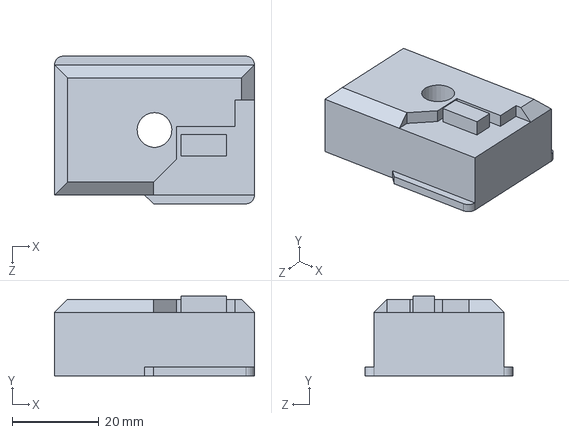
[picture p81: CAD file, 2026-10-19]
mechanical/source/formal/零件/模块化舱段/粉尘传感器/模拟/GP2Y1014AU0F粉尘传感器.SLDPRT
46.0 x 18.3 x 34.0 mm
