Robusr/DustArrow/mechanical/source/formal/零件/降落伞舱段/头锥推出连杆.SLDPRT

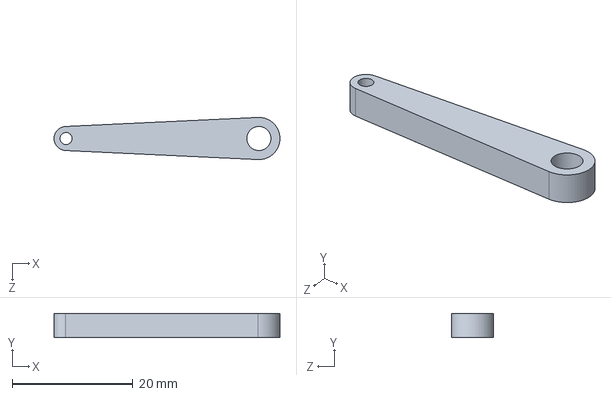
[picture p82: CAD file, 2026-10-19]
mechanical/source/formal/零件/降落伞舱段/头锥推出连杆.SLDPRT
37.5 x 4.00 x 6.99 mm
