Robusr/DustArrow/mechanical/source/formal/零件/鸭翼舱段/模拟/15T舵机臂(部分拟合).SLDPRT

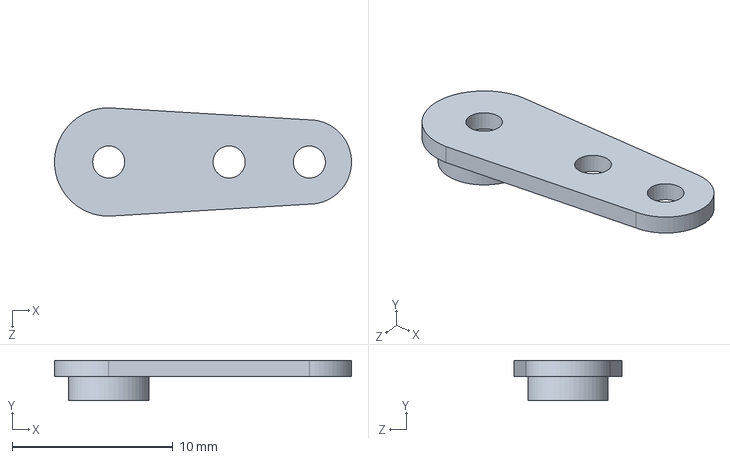
[picture p83: CAD file, 2026-10-19]
mechanical/source/formal/零件/鸭翼舱段/模拟/15T舵机臂(部分拟合).SLDPRT
18.5 x 2.50 x 6.75 mm
