Robusr/DustArrow/mechanical/source/formal/零件/鸭翼舱段/鸭翼内弯轴.SLDPRT

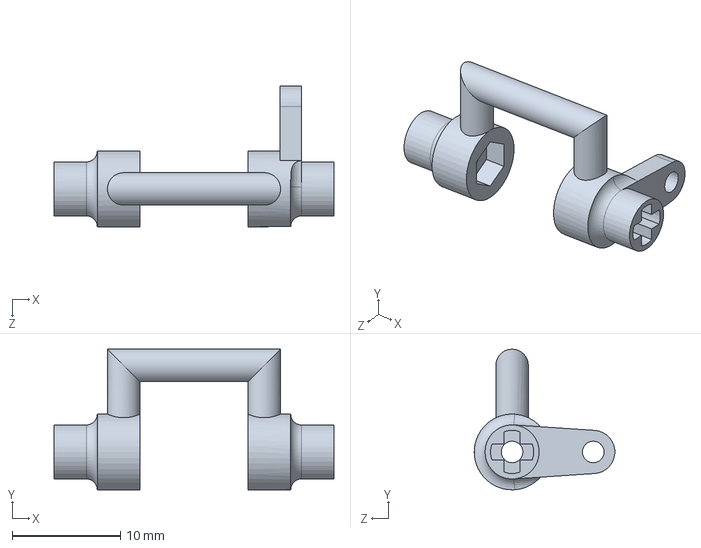
[picture p84: CAD file, 2026-10-19]
mechanical/source/formal/零件/鸭翼舱段/鸭翼内弯轴.SLDPRT
25.9 x 13.0 x 13.0 mm
