Robusr/DustArrow/mechanical/source/reprint_models/伞舱舵机轴A段.SLDPRT

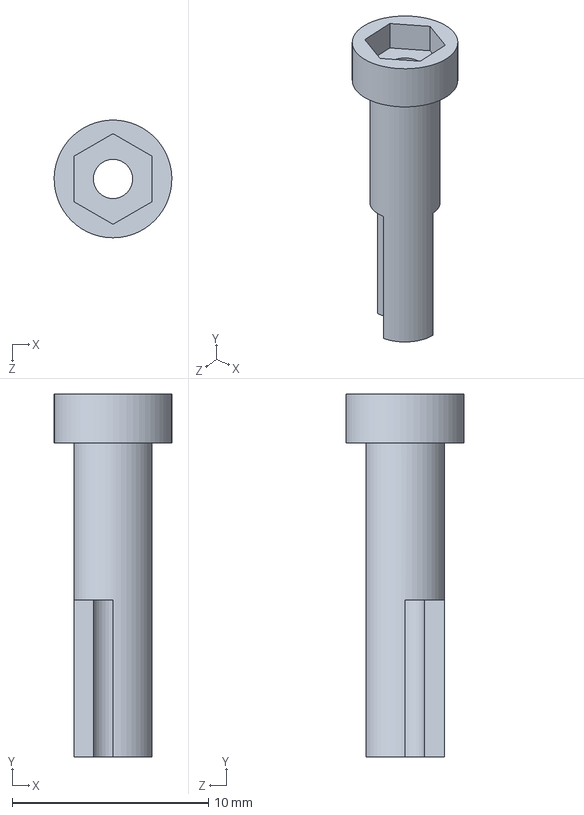
[picture p85: CAD file, 2026-10-19]
mechanical/source/reprint_models/伞舱舵机轴A段.SLDPRT
6.00 x 18.5 x 6.00 mm
