Robusr/DustArrow/simulation/cfd/理想化模型 X90 Y90.SLDPRT

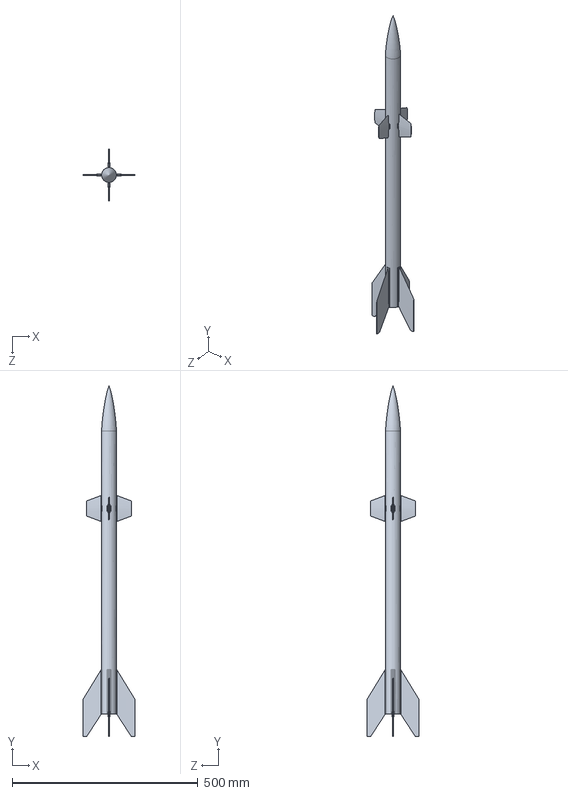
[picture p86: CAD file, 2026-10-19]
simulation/cfd/理想化模型 X90 Y90.SLDPRT
139.7 x 940.9 x 139.7 mm
