Robusr/DustArrow/mechanical/output/3dp/canard_inner_straight_shaft.stl

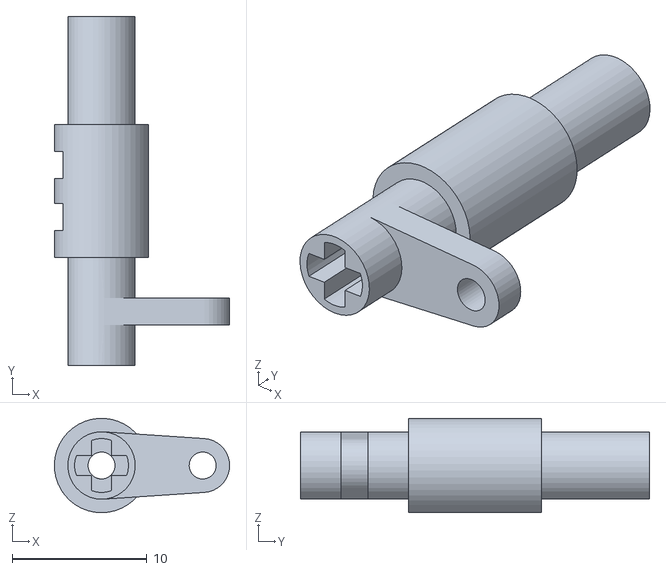
[picture p87: CAD file, 2026-10-19]
mechanical/output/3dp/canard_inner_straight_shaft.stl
13.0 x 25.9 x 7.00
