Robusr/DustArrow/mechanical/output/reprint/reprint_parachute_bay_base.stl

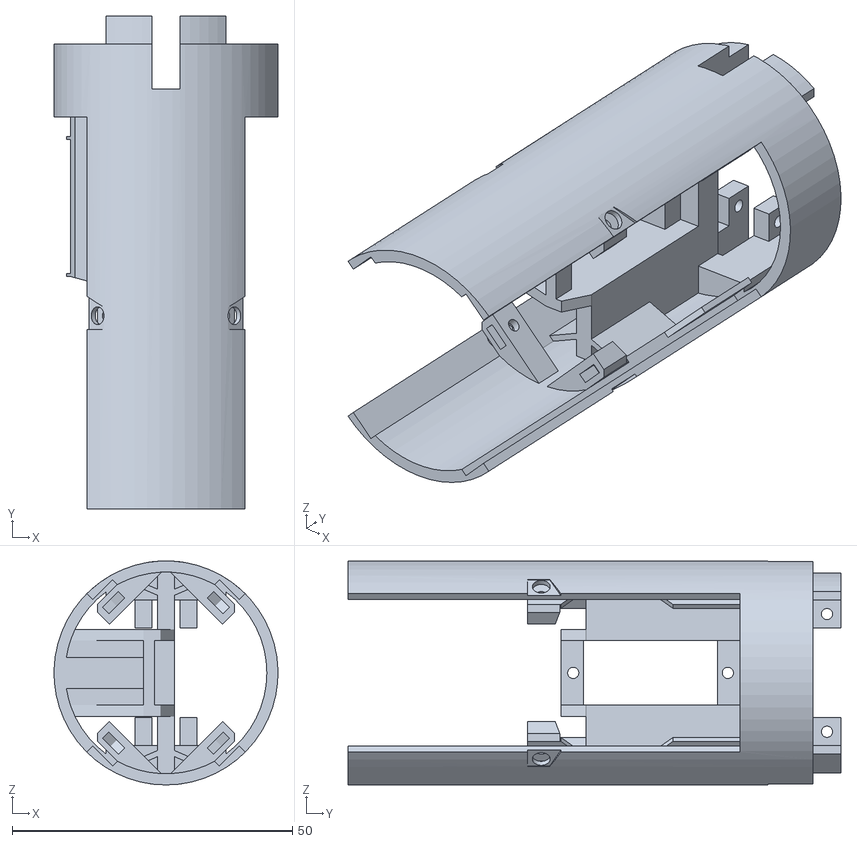
[picture p88: CAD file, 2026-10-19]
mechanical/output/reprint/reprint_parachute_bay_base.stl
40.0 x 88.0 x 40.0
