Robusr/DustArrow/mechanical/source/draft/3D/伞舱/竖直滑道上盖板.SLDPRT

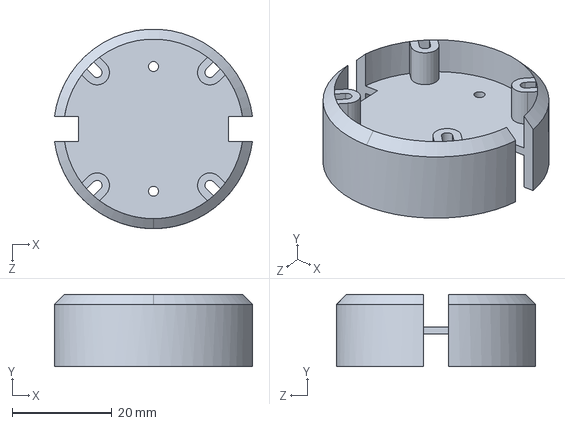
[picture p89: CAD file, 2026-10-19]
mechanical/source/draft/3D/伞舱/竖直滑道上盖板.SLDPRT
39.7 x 14.5 x 40.0 mm
