Robusr/DustArrow/mechanical/source/draft/3D/航电舱/测控模块/l76x_gps_module.stp.SLDPRT

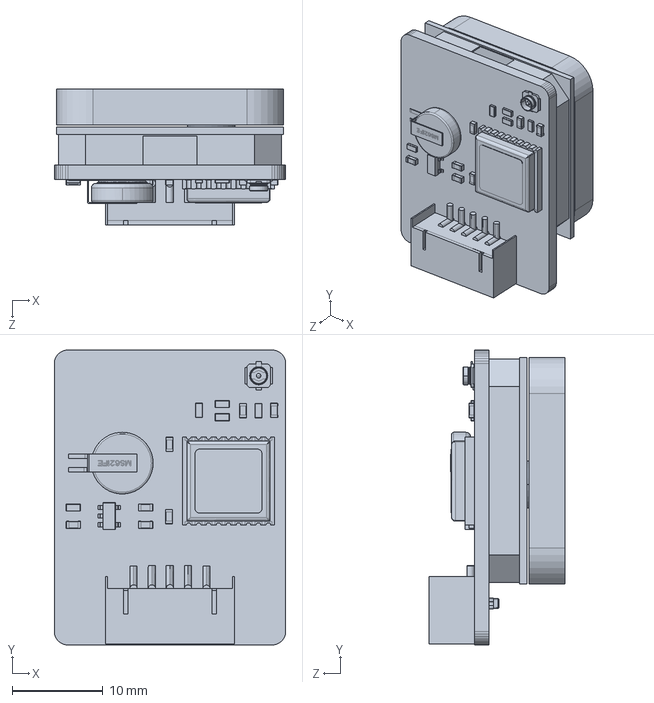
[picture p90: CAD file, 2026-10-19]
mechanical/source/draft/3D/航电舱/测控模块/l76x_gps_module.stp.SLDPRT
25.5 x 32.5 x 15.0 mm
