Robusr/DustArrow/mechanical/source/draft/3D/航电舱/电源模块/电源模块.SLDPRT

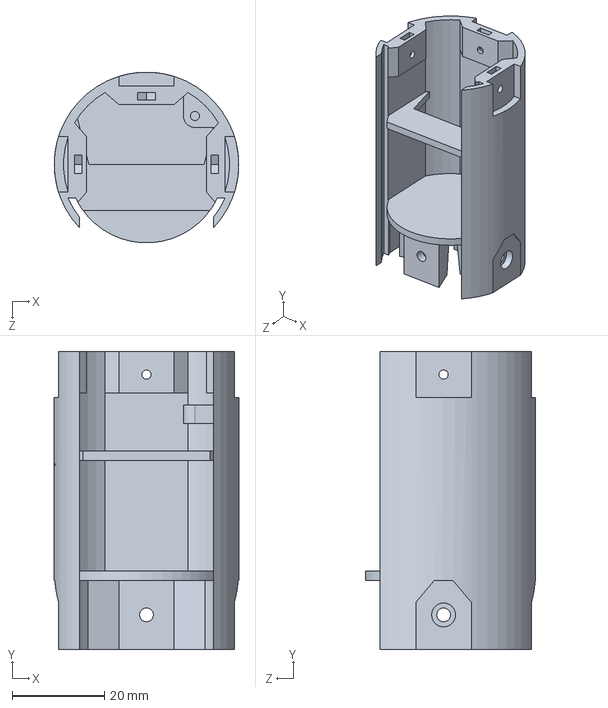
[picture p91: CAD file, 2026-10-19]
mechanical/source/draft/3D/航电舱/电源模块/电源模块.SLDPRT
40.0 x 64.6 x 36.9 mm
