Robusr/DustArrow/mechanical/source/draft/3D/航电舱/粉尘传感器模块/粉尘传感器模块上端PCB.SLDPRT

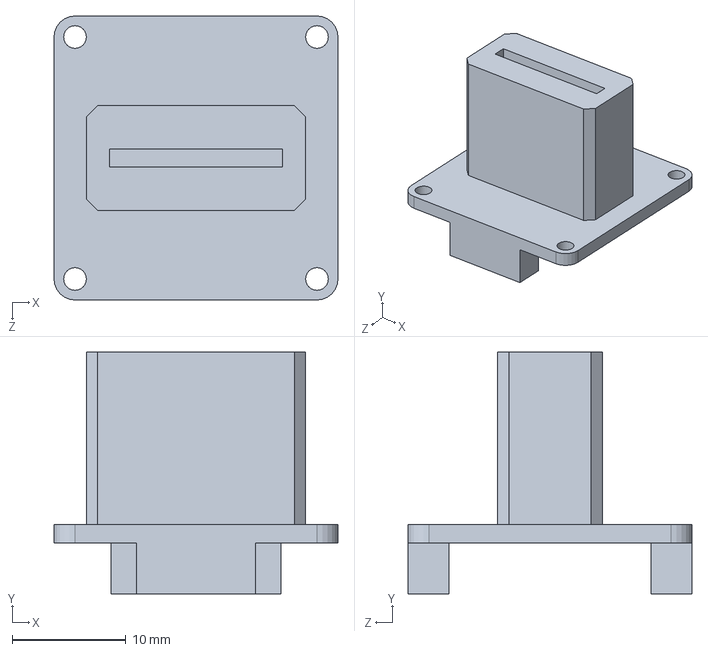
[picture p92: CAD file, 2026-10-19]
mechanical/source/draft/3D/航电舱/粉尘传感器模块/粉尘传感器模块上端PCB.SLDPRT
25.0 x 21.3 x 25.0 mm
