Robusr/DustArrow/mechanical/source/draft/3D/鸭翼舱/四通道/AS0017舵臂.SLDPRT

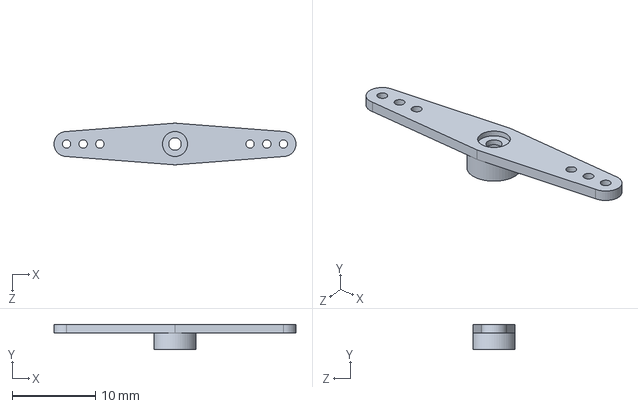
[picture p93: CAD file, 2026-10-19]
mechanical/source/draft/3D/鸭翼舱/四通道/AS0017舵臂.SLDPRT
29.0 x 3.00 x 5.00 mm
