Robusr/DustArrow/mechanical/source/draft/草图/主箭体测试.SLDPRT

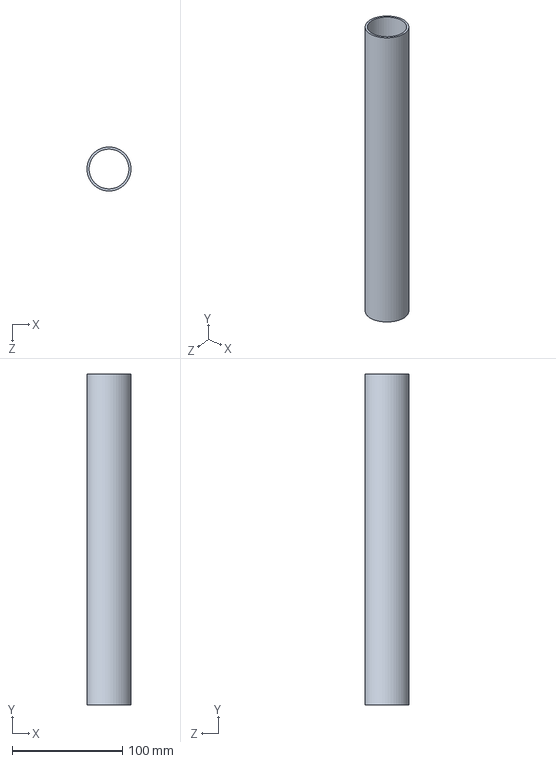
[picture p94: CAD file, 2026-10-19]
mechanical/source/draft/草图/主箭体测试.SLDPRT
40.0 x 300.0 x 40.0 mm
