Robusr/DustArrow/mechanical/source/formal/零件/模块化舱段/测控模块/模拟/陶瓷天线.SLDPRT

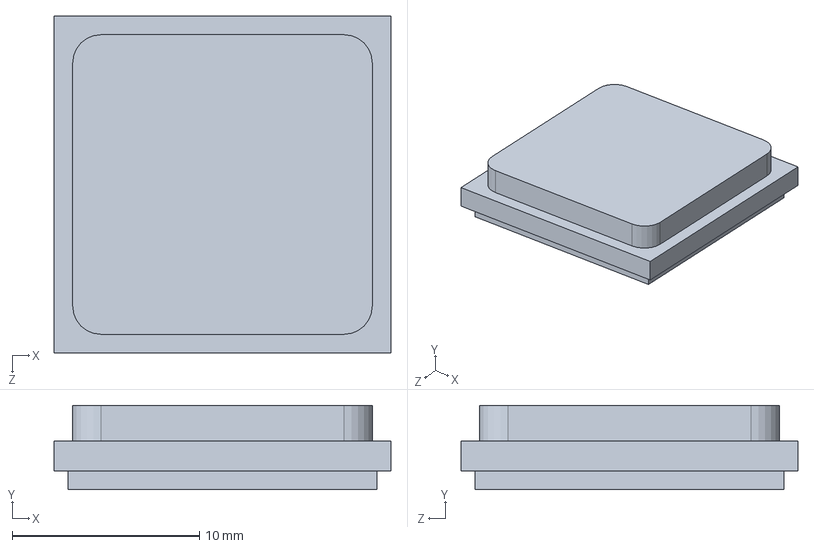
[picture p95: CAD file, 2026-10-19]
mechanical/source/formal/零件/模块化舱段/测控模块/模拟/陶瓷天线.SLDPRT
18.0 x 4.50 x 18.0 mm
