Robusr/DustArrow/mechanical/source/formal/零件/鸭翼舱段/鸭翼B片.SLDPRT

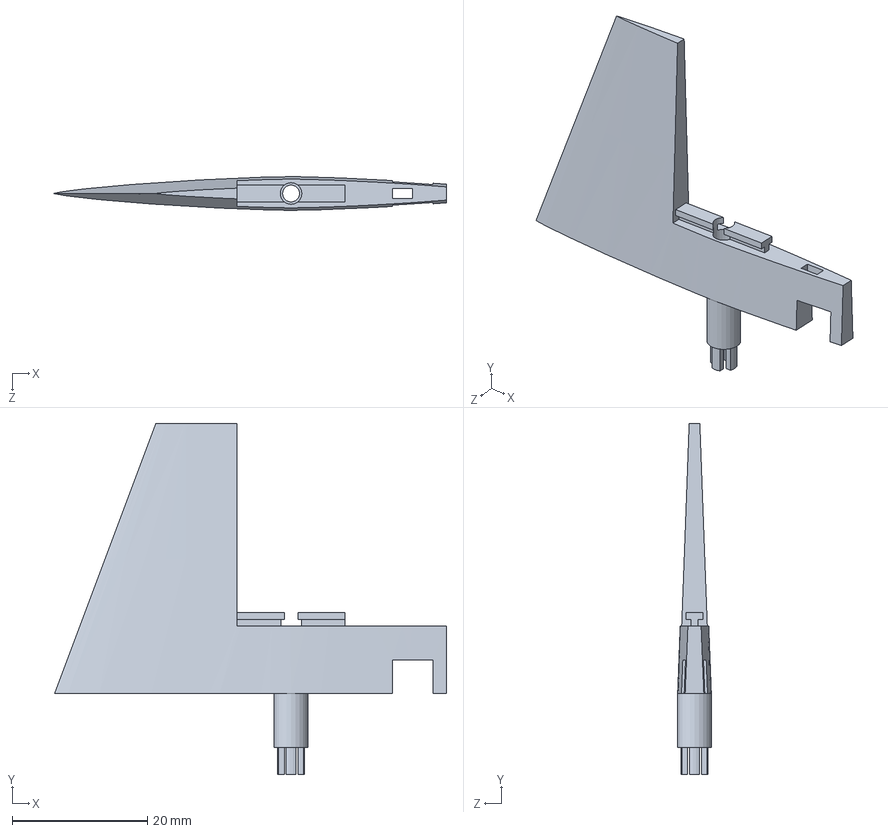
[picture p96: CAD file, 2026-10-19]
mechanical/source/formal/零件/鸭翼舱段/鸭翼B片.SLDPRT
58.0 x 52.0 x 4.99 mm
