Robusr/DustArrow/mechanical/source/launch_revision/鸭翼舱段主体.SLDPRT

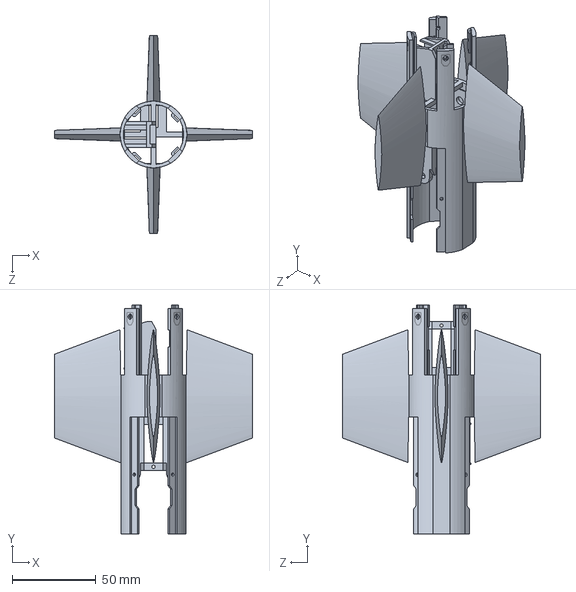
[picture p97: CAD file, 2026-10-19]
mechanical/source/launch_revision/鸭翼舱段主体.SLDPRT
118.7 x 137.0 x 118.7 mm
