Robusr/DustArrow/mechanical/output/3dp/canard_blade_a.stl

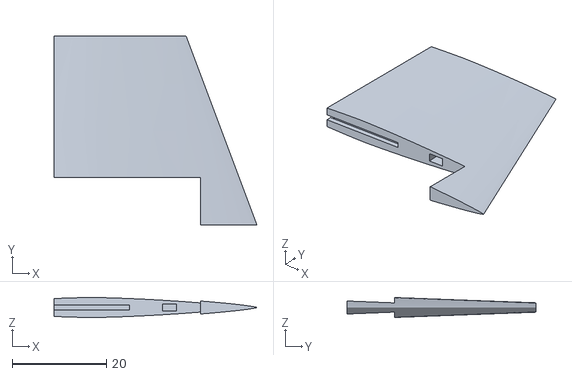
[picture p98: CAD file, 2026-10-19]
mechanical/output/3dp/canard_blade_a.stl
43.0 x 40.0 x 4.24
