Robusr/DustArrow/mechanical/output/reprint/reprint_parachute_bay_slider_v2.stl

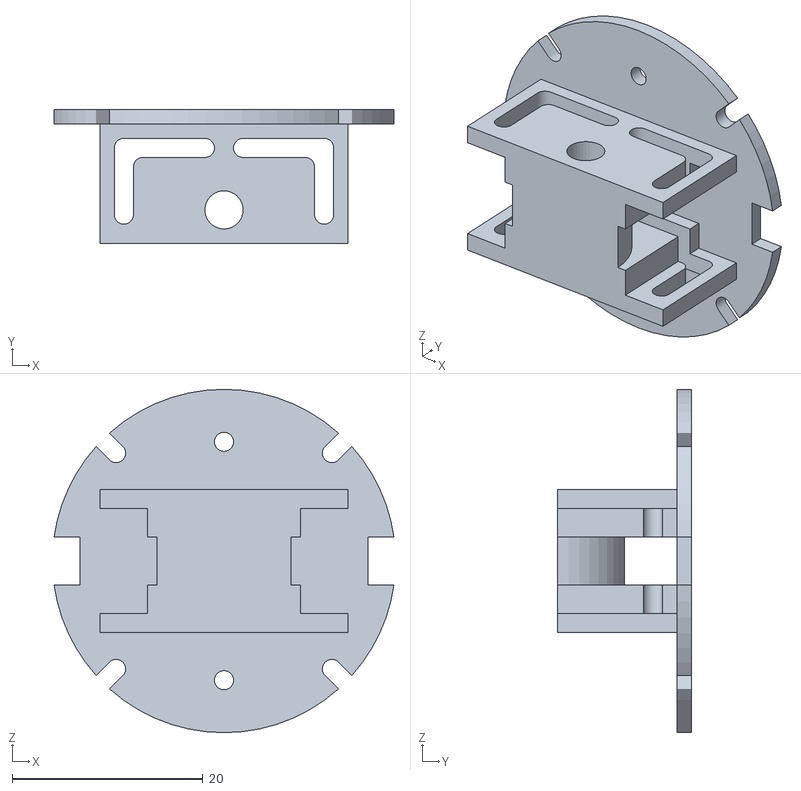
[picture p99: CAD file, 2026-10-19]
mechanical/output/reprint/reprint_parachute_bay_slider_v2.stl
35.7 x 14.0 x 36.0
