Robusr/DustArrow/mechanical/source/draft/3D/伞舱/开口测试.SLDPRT

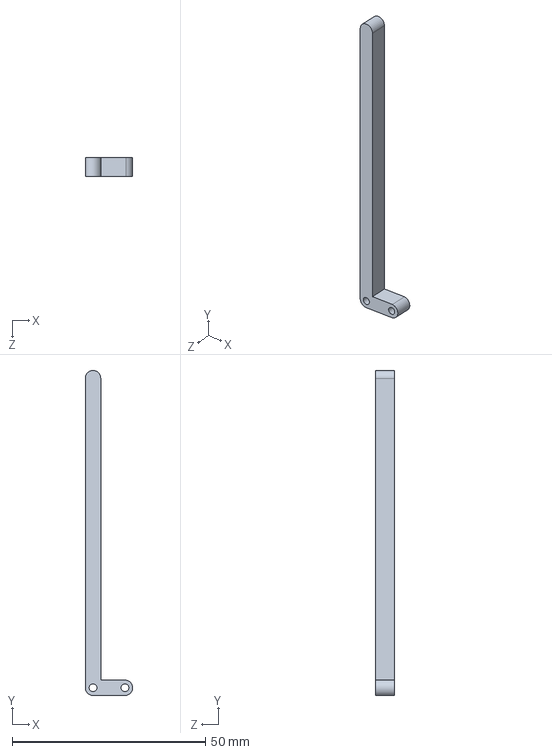
[picture p100: CAD file, 2026-10-19]
mechanical/source/draft/3D/伞舱/开口测试.SLDPRT
12.2 x 84.0 x 5.00 mm
