Robusr/DustArrow/mechanical/source/draft/3D/航电舱/数据模块/数据模块测试.SLDPRT

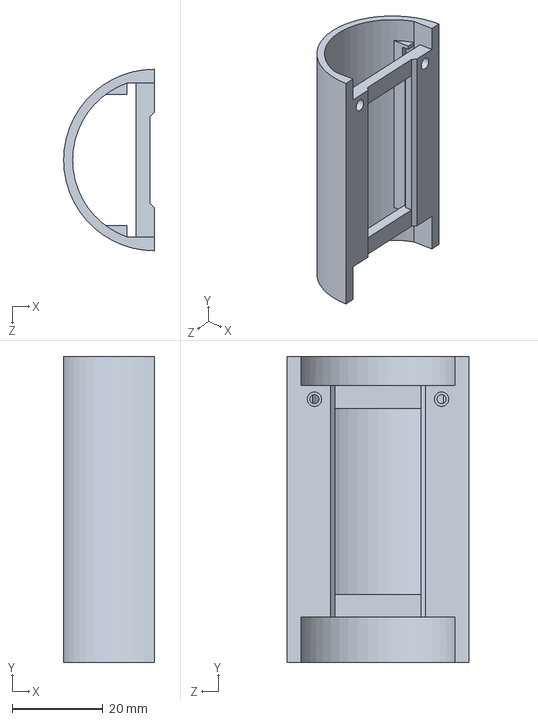
[picture p101: CAD file, 2026-10-19]
mechanical/source/draft/3D/航电舱/数据模块/数据模块测试.SLDPRT
20.0 x 67.4 x 40.0 mm
