Robusr/DustArrow/mechanical/source/draft/3D/航电舱/烟雾传感器模块/烟雾传感器模块.SLDPRT

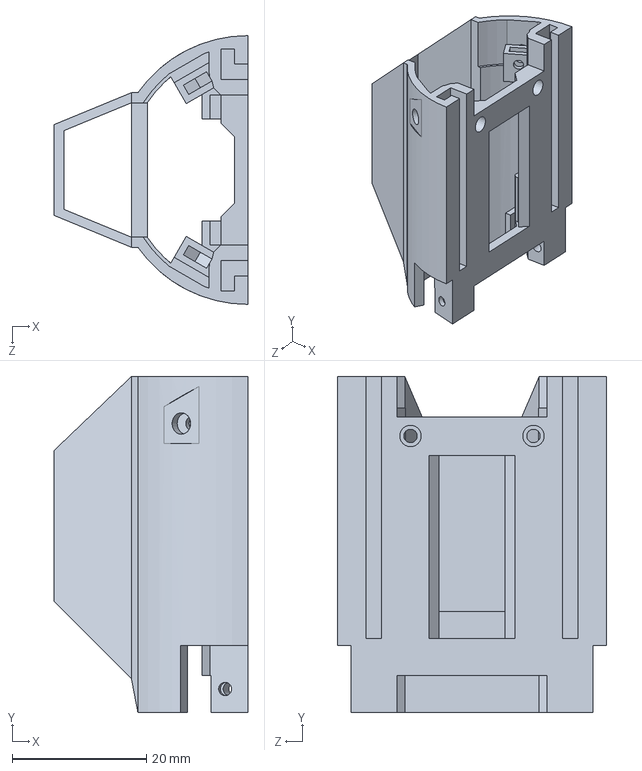
[picture p102: CAD file, 2026-10-19]
mechanical/source/draft/3D/航电舱/烟雾传感器模块/烟雾传感器模块.SLDPRT
28.8 x 50.0 x 40.0 mm
