Robusr/DustArrow/mechanical/source/draft/3D/鸭翼舱/四通道/鸭翼舱.SLDPRT

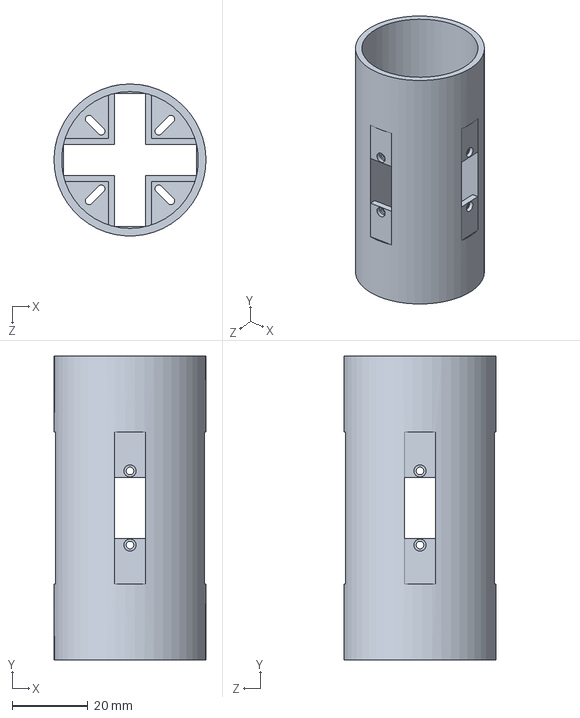
[picture p104: CAD file, 2026-10-19]
mechanical/source/draft/3D/鸭翼舱/四通道/鸭翼舱.SLDPRT
40.0 x 80.0 x 40.0 mm
