Robusr/DustArrow/mechanical/source/formal/零件/模块化舱段/测控模块/模拟/GPS模块.SLDPRT

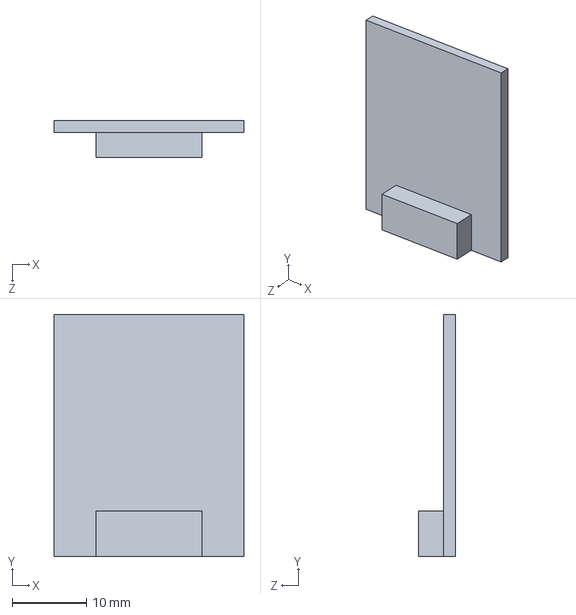
[picture p105: CAD file, 2026-10-19]
mechanical/source/formal/零件/模块化舱段/测控模块/模拟/GPS模块.SLDPRT
25.5 x 32.5 x 5.00 mm
