Robusr/DustArrow/mechanical/source/formal/零件/鸭翼舱段/模拟/舵机控制引出PCB.SLDPRT

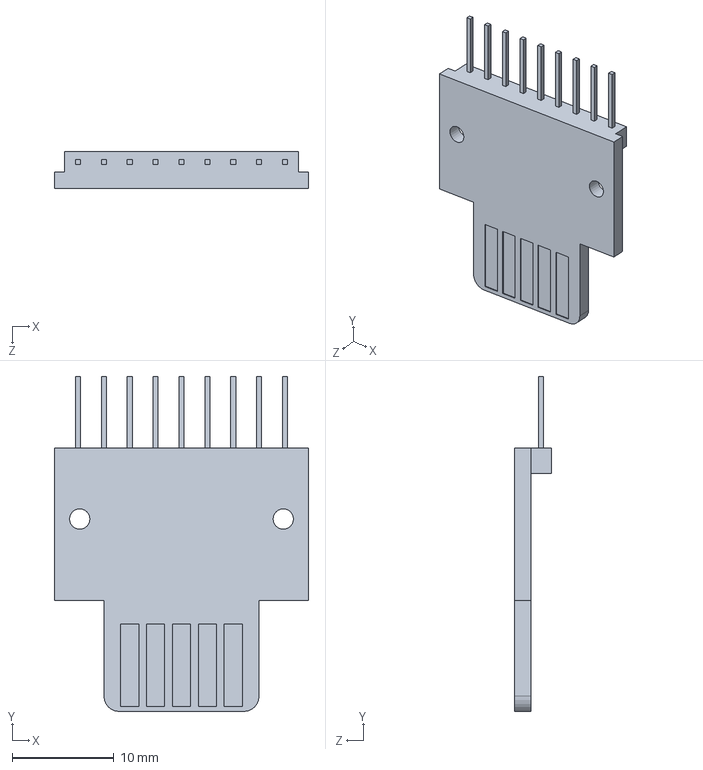
[picture p106: CAD file, 2026-10-19]
mechanical/source/formal/零件/鸭翼舱段/模拟/舵机控制引出PCB.SLDPRT
25.0 x 32.9 x 3.60 mm
