Robusr/DustArrow/mechanical/source/launch_revision/电源模块调试滑动盖板.SLDPRT

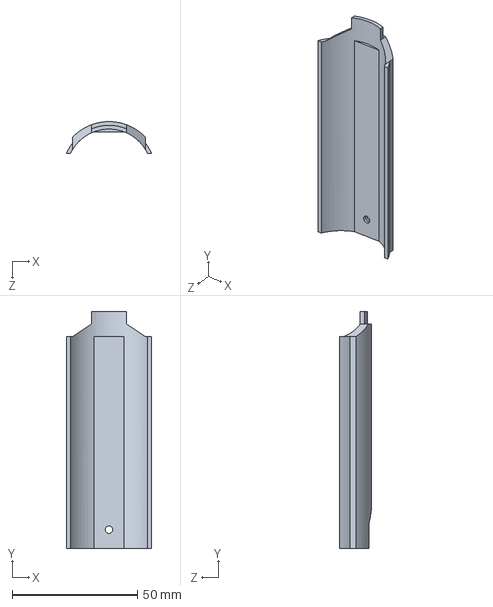
[picture p107: CAD file, 2026-10-19]
mechanical/source/launch_revision/电源模块调试滑动盖板.SLDPRT
34.0 x 94.6 x 12.7 mm
