Robusr/DustArrow/mechanical/source/reprint_models/头锥B片.SLDPRT

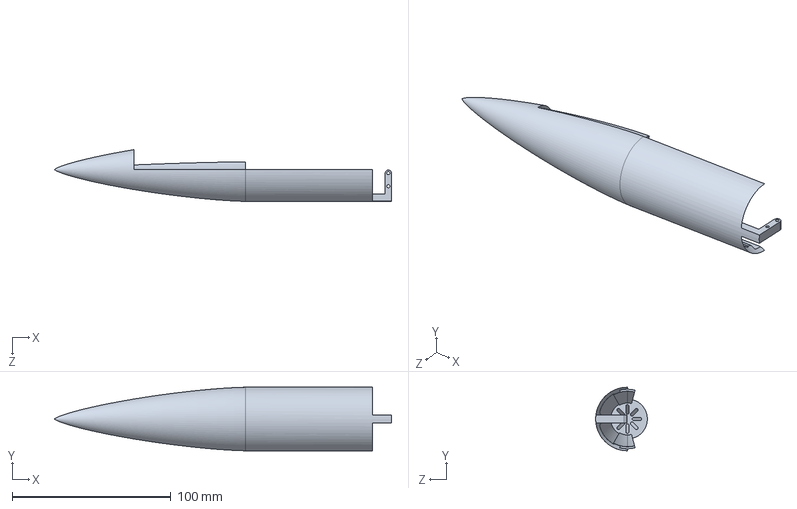
[picture p108: CAD file, 2026-10-19]
mechanical/source/reprint_models/头锥B片.SLDPRT
212.0 x 40.0 x 32.6 mm
