Robusr/DustArrow/mechanical/source/draft/3D/伞舱/水平滑道.SLDPRT

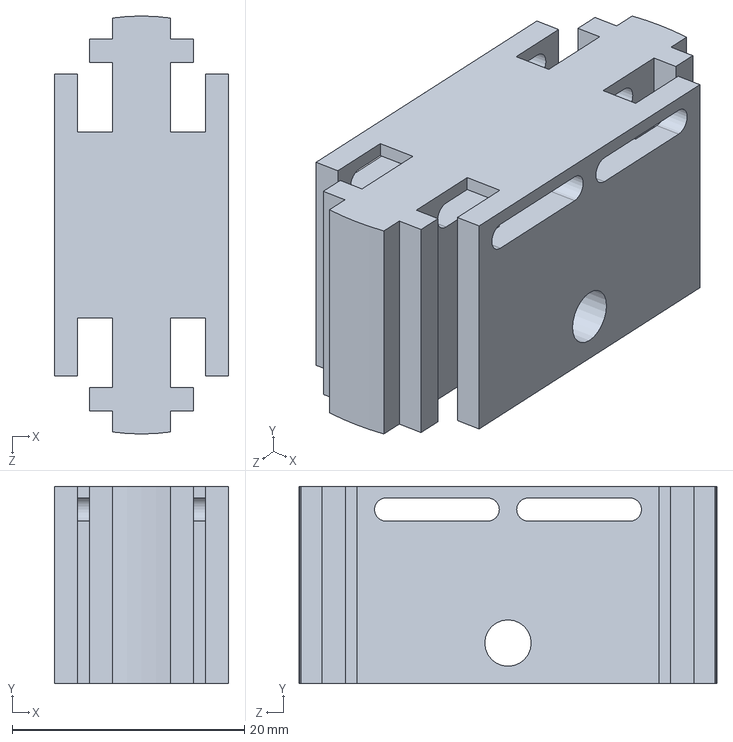
[picture p109: CAD file, 2026-10-19]
mechanical/source/draft/3D/伞舱/水平滑道.SLDPRT
15.0 x 17.0 x 36.0 mm
