Robusr/DustArrow/mechanical/source/draft/3D/标准件/M2螺丝测试.SLDPRT

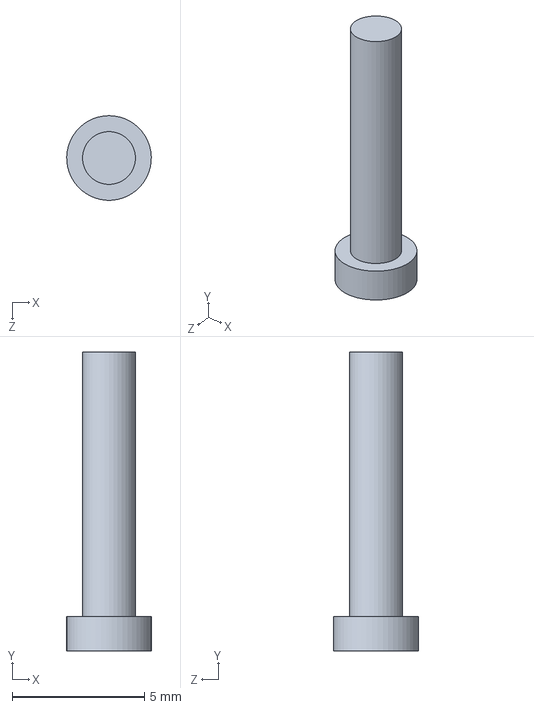
[picture p110: CAD file, 2026-10-19]
mechanical/source/draft/3D/标准件/M2螺丝测试.SLDPRT
3.20 x 11.3 x 3.20 mm
