Robusr/DustArrow/mechanical/source/draft/3D/鸭翼舱/两通道/ES08AII舵机(部分拟合).SLDPRT

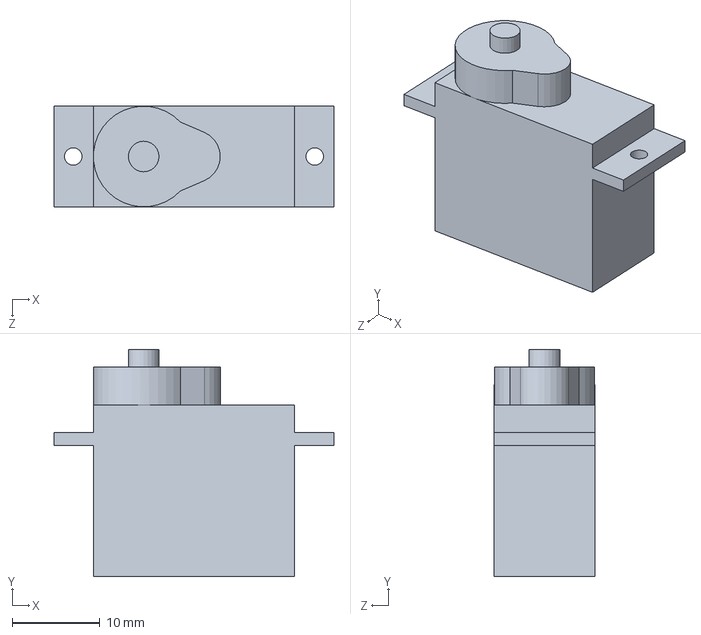
[picture p111: CAD file, 2026-10-19]
mechanical/source/draft/3D/鸭翼舱/两通道/ES08AII舵机(部分拟合).SLDPRT
32.0 x 26.0 x 11.5 mm
