Robusr/DustArrow/mechanical/source/draft/3D/鸭翼舱/四通道/AS0017舵机.SLDPRT

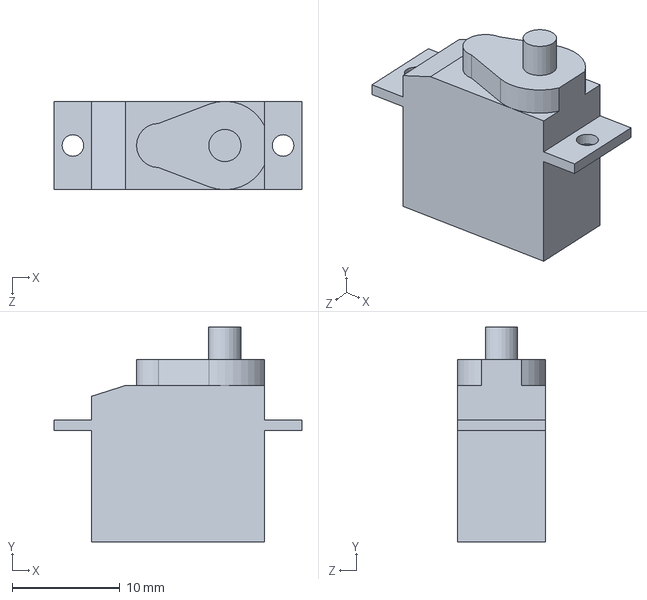
[picture p112: CAD file, 2026-10-19]
mechanical/source/draft/3D/鸭翼舱/四通道/AS0017舵机.SLDPRT
23.0 x 19.9 x 8.20 mm
