Robusr/DustArrow/mechanical/source/launch_revision/推进舱段主体.SLDPRT

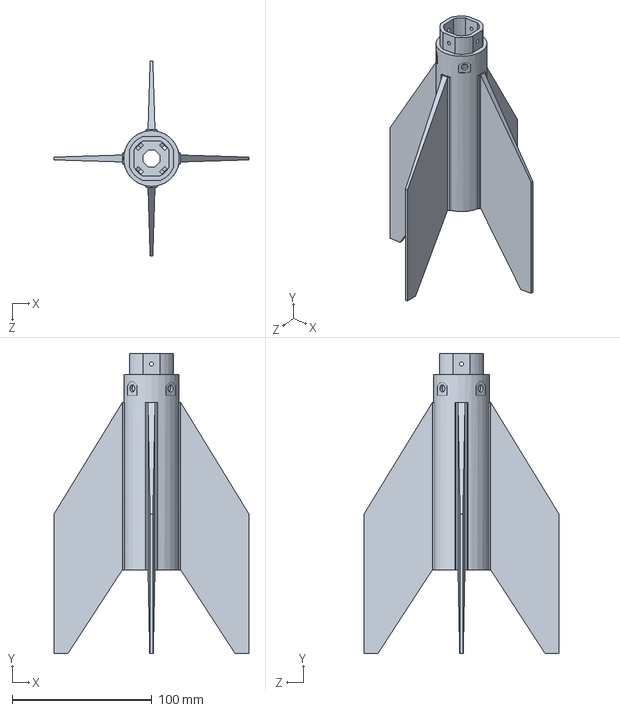
[picture p113: CAD file, 2026-10-19]
mechanical/source/launch_revision/推进舱段主体.SLDPRT
139.7 x 215.0 x 139.7 mm
