Robusr/DustArrow/mechanical/source/draft/3D/伞舱/头锥基础.SLDPRT

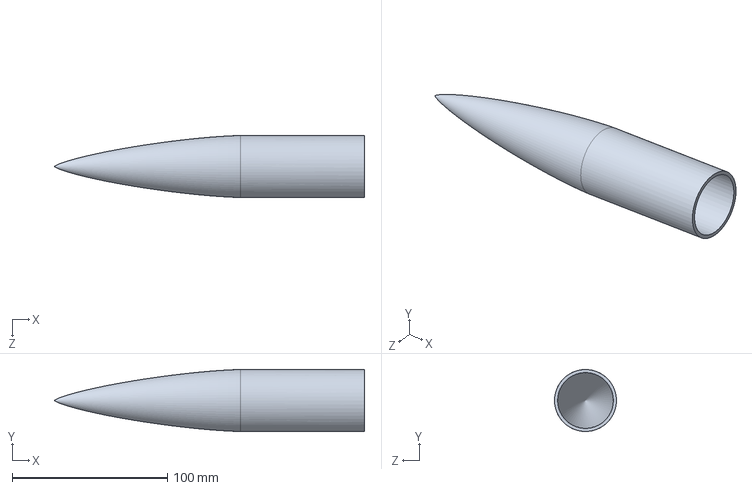
[picture p114: CAD file, 2026-10-19]
mechanical/source/draft/3D/伞舱/头锥基础.SLDPRT
200.0 x 40.0 x 40.0 mm
