Robusr/DustArrow/mechanical/source/draft/3D/鸭翼舱/两通道/鸭翼连接件测试.SLDPRT

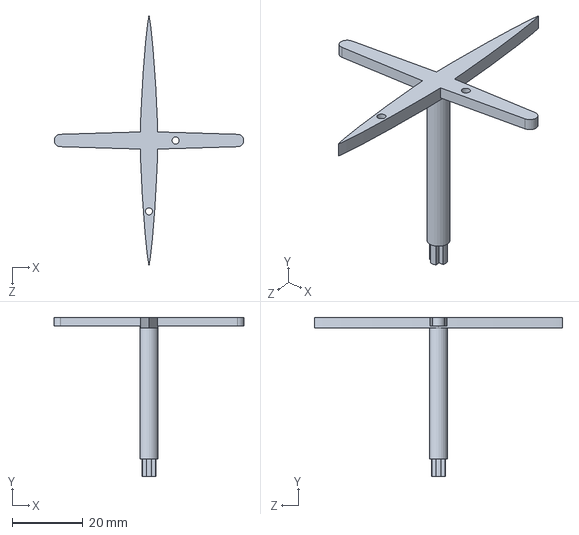
[picture p115: CAD file, 2026-10-19]
mechanical/source/draft/3D/鸭翼舱/两通道/鸭翼连接件测试.SLDPRT
53.5 x 45.0 x 70.0 mm
