Robusr/DustArrow/mechanical/source/draft/草图/鸭翼测试2.SLDPRT

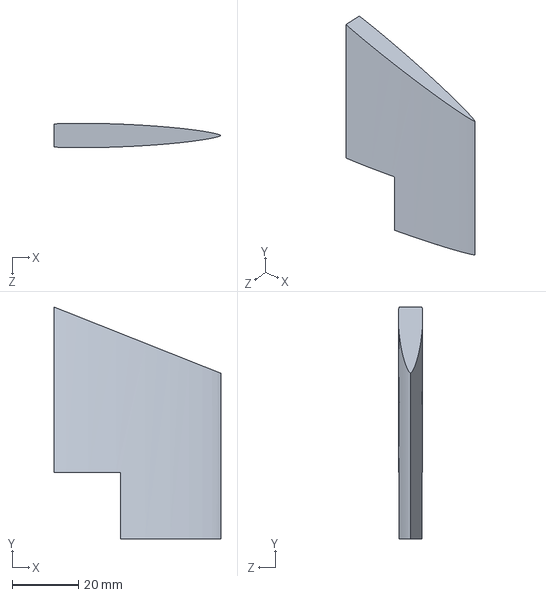
[picture p116: CAD file, 2026-10-19]
mechanical/source/draft/草图/鸭翼测试2.SLDPRT
50.4 x 70.0 x 7.37 mm
