Robusr/DustArrow/mechanical/source/formal/3D打印/原文件/主控模块主体.SLDPRT

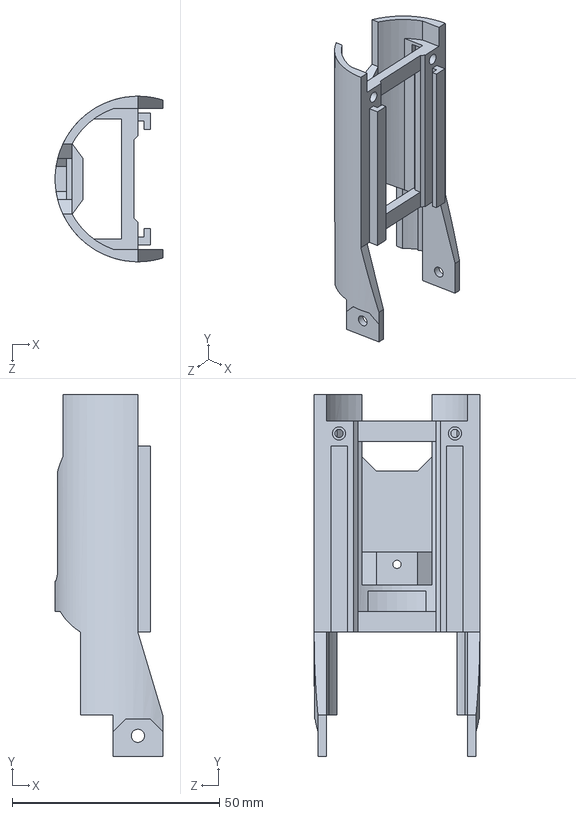
[picture p117: CAD file, 2026-10-19]
mechanical/source/formal/3D打印/原文件/主控模块主体.SLDPRT
26.0 x 87.4 x 40.0 mm
