Robusr/DustArrow/mechanical/source/reprint_models/头锥A片.SLDPRT

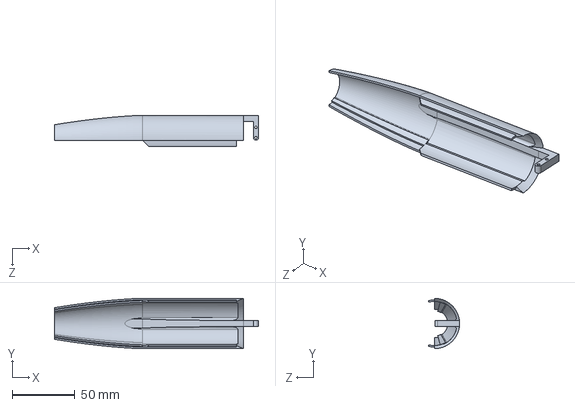
[picture p118: CAD file, 2026-10-19]
mechanical/source/reprint_models/头锥A片.SLDPRT
162.0 x 40.0 x 24.9 mm
