Robusr/DustArrow/mechanical/output/3dp/canard_linkage_rod.stl

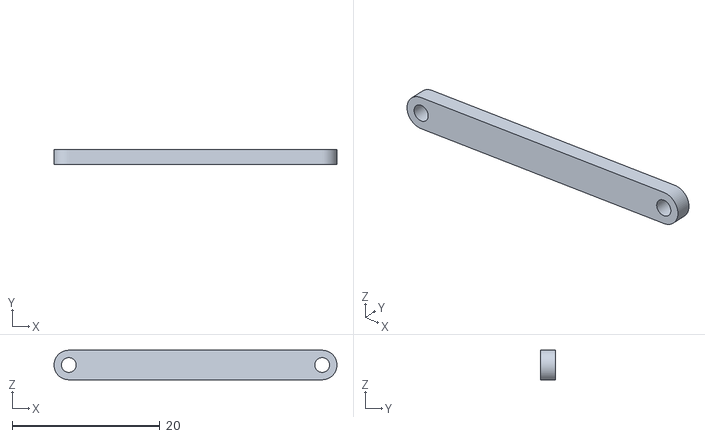
[picture p119: CAD file, 2026-10-19]
mechanical/output/3dp/canard_linkage_rod.stl
38.3 x 2.00 x 4.00
