Robusr/DustArrow/mechanical/source/draft/3D/伞舱/伞舱舵机轴.SLDPRT

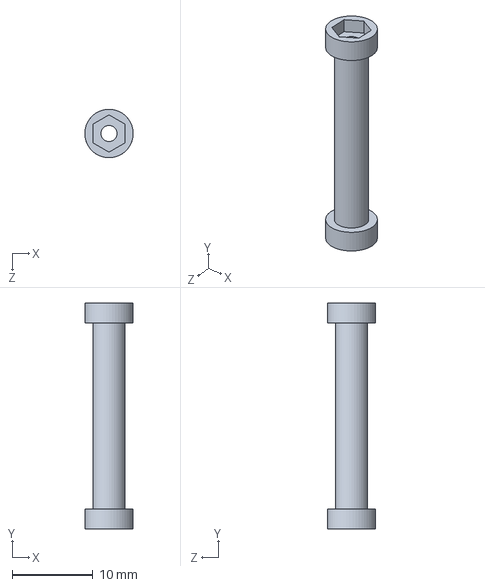
[picture p120: CAD file, 2026-10-19]
mechanical/source/draft/3D/伞舱/伞舱舵机轴.SLDPRT
6.00 x 28.0 x 6.00 mm
