Robusr/DustArrow/mechanical/source/draft/3D/鸭翼舱/两通道/两通道鸭翼舱优化.SLDPRT

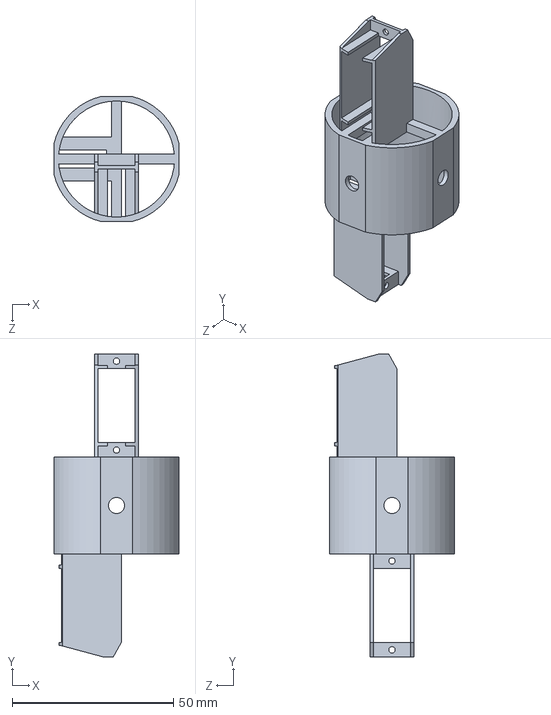
[picture p121: CAD file, 2026-10-19]
mechanical/source/draft/3D/鸭翼舱/两通道/两通道鸭翼舱优化.SLDPRT
38.7 x 94.0 x 38.7 mm
