Robusr/DustArrow/mechanical/source/draft/草图/鸭翼测试3.SLDPRT

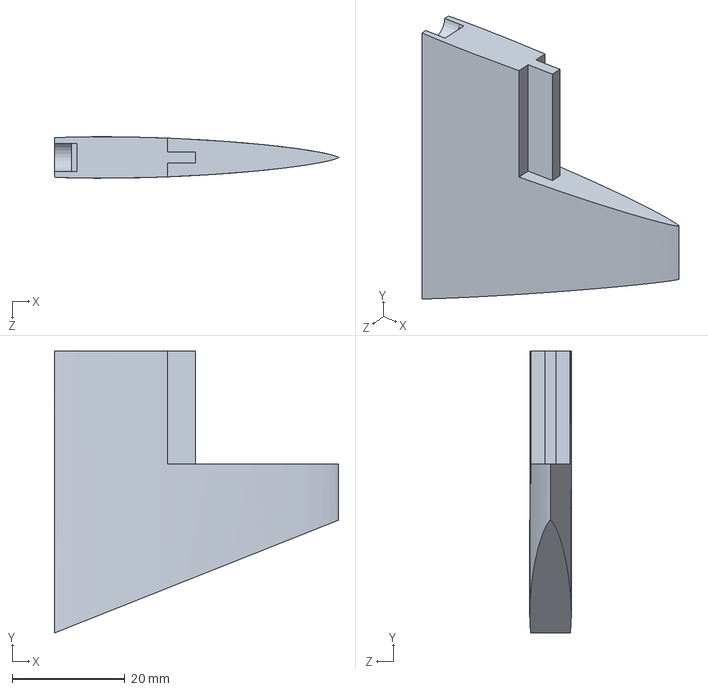
[picture p122: CAD file, 2026-10-19]
mechanical/source/draft/草图/鸭翼测试3.SLDPRT
50.4 x 50.0 x 7.36 mm
