Robusr/DustArrow/mechanical/output/3dp/canard_lock_pin.stl

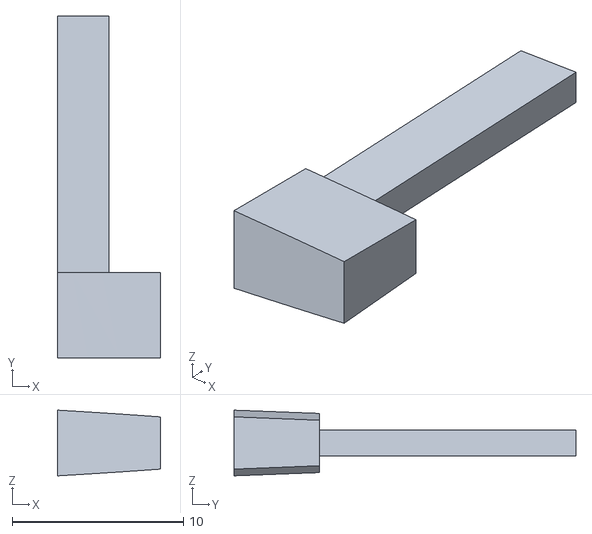
[picture p123: CAD file, 2026-10-19]
mechanical/output/3dp/canard_lock_pin.stl
6.00 x 20.0 x 3.84
