Robusr/DustArrow/mechanical/source/draft/草图/伞舱测试.SLDPRT

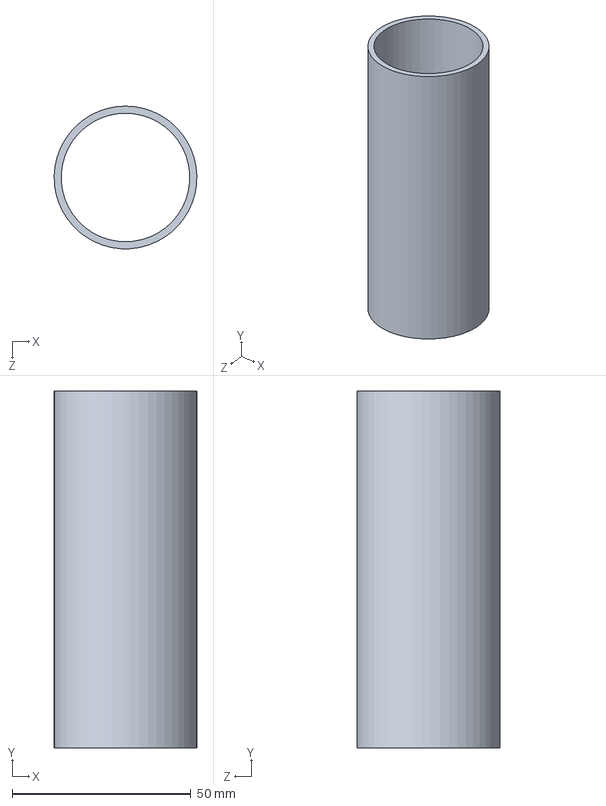
[picture p124: CAD file, 2026-10-19]
mechanical/source/draft/草图/伞舱测试.SLDPRT
40.0 x 100.0 x 40.0 mm
