Robusr/DustArrow/mechanical/source/formal/3D打印/原文件/粉尘传感器模块主体.SLDPRT

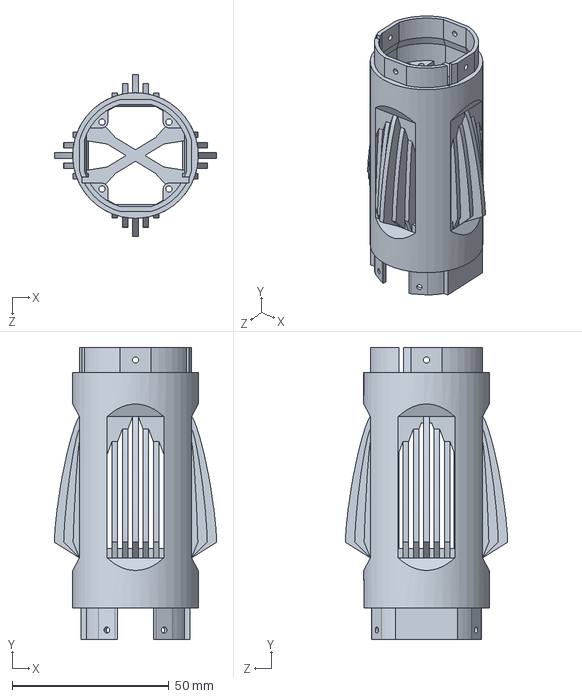
[picture p125: CAD file, 2026-10-19]
mechanical/source/formal/3D打印/原文件/粉尘传感器模块主体.SLDPRT
51.7 x 93.0 x 51.7 mm
