Robusr/DustArrow/mechanical/source/draft/3D/伞舱/GY2Y1014AUOF粉尘传感器.SLDPRT

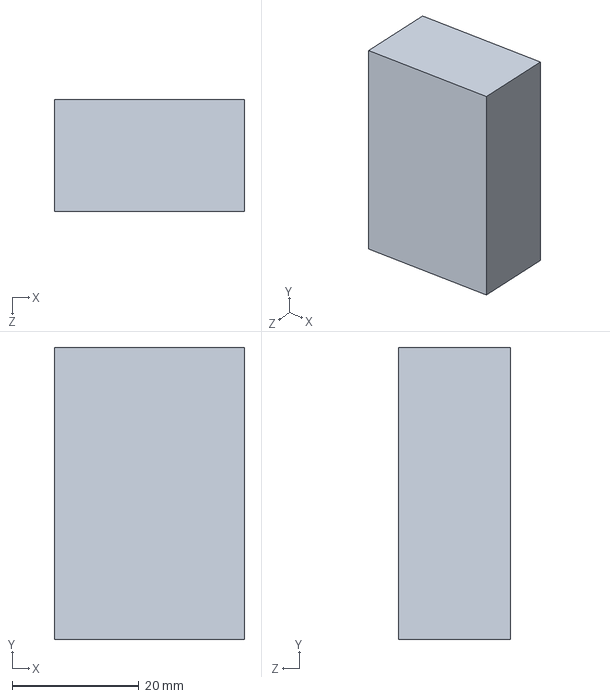
[picture p126: CAD file, 2026-10-19]
mechanical/source/draft/3D/伞舱/GY2Y1014AUOF粉尘传感器.SLDPRT
30.0 x 46.0 x 17.6 mm
