Robusr/DustArrow/mechanical/source/draft/草图/头锥测试.SLDPRT

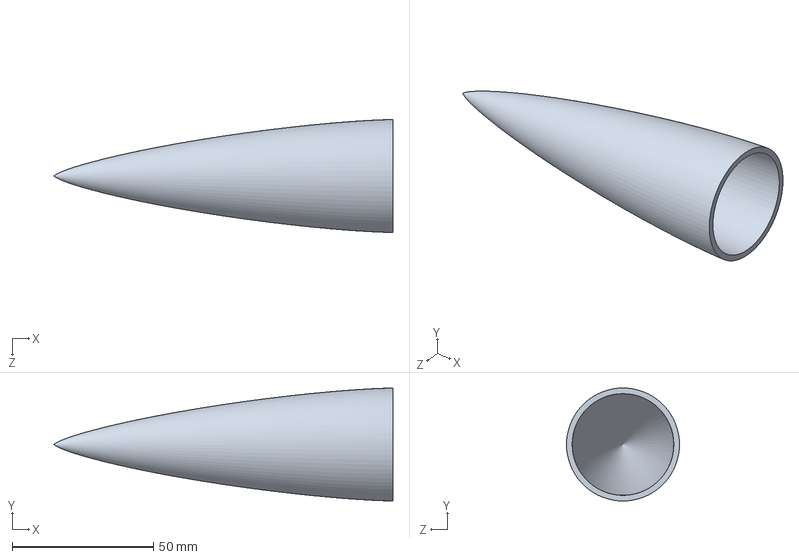
[picture p127: CAD file, 2026-10-19]
mechanical/source/draft/草图/头锥测试.SLDPRT
120.0 x 40.0 x 40.0 mm
