Robusr/DustArrow/mechanical/source/draft/草图/舵臂测试.SLDPRT

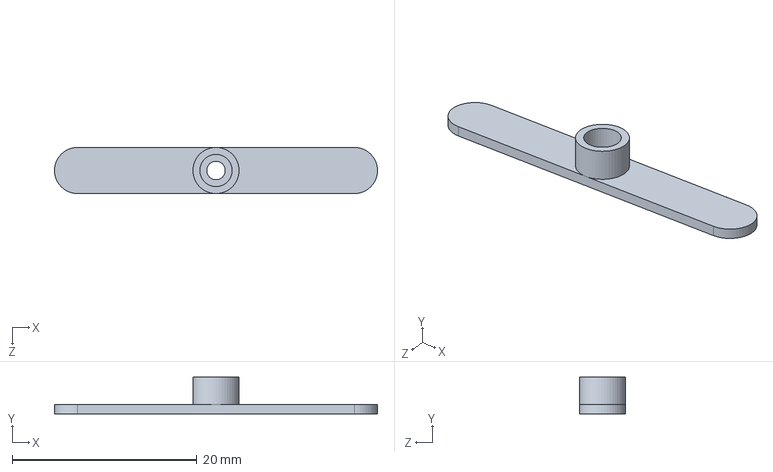
[picture p128: CAD file, 2026-10-19]
mechanical/source/draft/草图/舵臂测试.SLDPRT
35.0 x 4.00 x 5.00 mm
