Robusr/DustArrow/(list of files, cad)

Other CAD files:
mechanical/source/draft/3D/航电舱/数据模块/数据模块装配.SLDASM
mechanical/source/formal/零件/模块化舱段/数据模块/数据模块主体.SLDPRT
mechanical/source/formal/零件/模块化舱段/有害气体传感器/有害气体传感器模块主体.SLDPRT
mechanical/source/formal/零件/模块化舱段/有害气体传感器/模拟/MQ-135气体传感器.SLDPRT
mechanical/source/formal/零件/模块化舱段/电源模块/模拟/电池.SLDPRT
mechanical/source/launch_revision/测控模块主体.SLDPRT
mechanical/source/draft/3D/推进舱/发动机支撑.SLDPRT
mechanical/source/draft/3D/航电舱/伞舱鸭翼/伞舱鸭翼舵机控制电路连接.SLDPRT
mechanical/source/formal/3D打印/原文件/有害气体传感器模块主体.SLDPRT
mechanical/source/formal/零件/推进尾翼舱段/推进舱段主体.SLDPRT
mechanical/source/formal/零件/鸭翼舱段/模拟/舵机插头.SLDPRT
mechanical/source/reprint_models/伞舱舵机轴B段.SLDPRT
simulation/cfd/理想化模型 X60 Y90.SLDPRT
mechanical/source/draft/3D/推进舱/动力一体舱段平滑曲面.SLDPRT
mechanical/source/draft/3D/航电舱/测控模块/测控模块.SLDPRT
mechanical/source/draft/3D/鸭翼舱/两通道/15T舵机臂(部分拟合).SLDPRT
mechanical/source/formal/3D打印/原文件/伞舱滑块.SLDPRT
mechanical/source/formal/零件/鸭翼舱段/鸭翼A片.SLDPRT
simulation/cfd/理想化模型 X60 Y60.SLDPRT
mechanical/output/3dp/motor_mount_support.stl
mechanical/source/draft/3D/航电舱/测控模块/陶瓷天线.SLDPRT
mechanical/source/draft/3D/航电舱/烟雾传感器模块/烟雾传感器模块PCB.SLDPRT
mechanical/source/draft/3D/航电舱/粉尘传感器模块/GP2Y1014AU0F粉尘传感器.SLDPRT
mechanical/source/formal/3D打印/原文件/伞舱舵机轴B段.SLDPRT
mechanical/source/formal/零件/模块化舱段/测控模块/模拟/B片测控PCB.SLDPRT
mechanical/source/formal/零件/鸭翼舱段/鸭翼舱段连接.SLDPRT
mechanical/source/reprint_models/电源模块主体.SLDPRT
mechanical/output/3dp/parachute_bay_slider.stl
mechanical/source/formal/3D打印/原文件/伞舱基座.SLDPRT
mechanical/source/reprint_models/数据模块主体.SLDPRT
mechanical/source/formal/3D打印/原文件/推进发动机支撑.SLDPRT
mechanical/source/reprint_models/伞舱滑块盖板.SLDPRT
mechanical/output/3dp/telemetry_module_body.stl
mechanical/output/3dp/nose_cone_half_b.stl
mechanical/source/formal/3D打印/原文件/鸭翼A片.SLDPRT
mechanical/output/3dp/canard_inner_curved_shaft.stl
mechanical/source/formal/3D打印/原文件/电源模块调试滑动盖板.SLDPRT
mechanical/source/formal/3D打印/原文件/伞舱舵机轴A段.SLDPRT
mechanical/source/formal/3D打印/原文件/电源模块主体.SLDPRT
mechanical/source/formal/3D打印/原文件/鸭翼内直轴.SLDPRT
mechanical/source/formal/3D打印/原文件/鸭翼内弯轴.SLDPRT
mechanical/source/formal/3D打印/原文件/鸭翼固定插销.SLDPRT
mechanical/source/draft/3D/标准件/M2-10螺丝 .SLDPRT
mechanical/source/draft/3D/标准件/M2-15螺丝.SLDPRT
mechanical/source/draft/3D/标准件/M2-20螺丝.SLDPRT
mechanical/source/draft/3D/标准件/M2-4螺丝.SLDPRT
mechanical/source/draft/3D/标准件/M2-5螺丝.SLDPRT
