Robusr/DustArrow/docs/zh-CN/theory_of_operation.md

# 工作原理

## 范围

本文说明 DustArrow X 原型使用的姿态与遥测数学。原始报告只给出了简短推导；
本文补充明确的坐标约定、适用边界，并把每处修正对应到 `../errata.md` 与
`../verification.md`。

## 证据状态

| 项目 | 状态 | 来源 |
|---|---|---|
| 40.0 mm 箭体直径 | 实测 | STL 包围盒，`scripts/verify_theory/test_geometry.py` |
| 25.0 × 25.1 mm 电源板 | 实测 | Gerber 外形层 |
| 由重力解算横滚与俯仰 | 推导 | 本文，已数值验证 |
| 互补滤波权重 | 报告原文，信息不完整 | 原始报告第 2 节 |
| 仅凭 MPU6050 解算偏航 | 不可观测 | 六轴 IMU 无磁力计 |
| 千米级数传 | 未验证的设计目标 | 报告声明；归档中没有链路预算或外场测试 |
| PID 飞行控制 | 未实现 | 报告写明算法仍处于探究阶段 |

## 坐标约定

报告把绕 $x$ 轴的旋转定义为横滚、绕 $y$ 轴定义为俯仰、绕 $z$ 轴定义为
偏航，但没有说明轴向和传感器安装方向。验证脚本采用以下约定：

- 机体坐标系：$x$ 向前、$y$ 向右、$z$ 向上，右手系。
- 惯性坐标系：当地水平，$z$ 向上。
- 四元数 $q$ 把矢量从机体系旋转到惯性系。
- 惯性系重力为 $\mathbf{g}_i = [0, 0, g]^T$，其中
  $g = 9.80665\ \mathrm{m/s^2}$。

如果飞控板的实际安装方向不同，下文所有符号都要重新核对。该项在勘误表中
标记为 `[待确认]`。

## 由重力解算静态姿态

在水平、无加速度的静态条件下，加速度计测量的是重力的反作用：

$$
\mathbf{a}_b = R(q)^T \mathbf{g}_i .
$$

设横滚角为 $\phi$、俯仰角为 $\theta$，重力分量为

$$
a_x = -g \sin\theta, \qquad
a_y = g \sin\phi \cos\theta, \qquad
a_z = g \cos\phi \cos\theta .
$$

因此

$$
\phi = \mathrm{atan2}(a_y, a_z),
$$

$$
\theta = \mathrm{atan2}\left(-a_x,\sqrt{a_y^2+a_z^2}\right).
$$

报告写作 $\phi = \arctan(a_y/a_z)$。该式丢失象限，且在 $a_z = 0$ 时无定义。
例如 $\phi = 150^\circ$ 时它返回 $-30^\circ$。勘误将公式改为 `atan2`，
数值测试复现了原公式的错误。

报告中的俯仰公式形如
$\sin\theta = a_x/\sqrt{a_y^2+a_z^2}$。只有在确定轴向符号后，它才与上式
等价。由于报告没有给出安装方向，该项标记为 `[待确认]`。

## 互补滤波

报告给出

$$
\theta_k = k\,\theta_{\mathrm{acc},k} + (1-k)\,\theta_{\mathrm{gyro},k},
\qquad
\theta_{\mathrm{gyro},k} = \theta_{k-1} + \omega_y \Delta t .
$$

这是一阶互补滤波。原文没有给出 $\Delta t$、采样率、初值和陀螺零偏。
可复现的写法使用时间常数 $\tau$：

$$
\alpha = \frac{\tau}{\tau+\Delta t},
$$

$$
\theta_k = \alpha\,\theta_{\mathrm{acc},k} +
(1-\alpha)\left(\theta_{k-1} + \omega_y \Delta t\right).
$$

滤波器在低频信任加速度计、在高频信任陀螺仪。它不能使加速度计在推力阶段
重新变得有效。按上式取 $\alpha = \tau/(\tau+\Delta t)$ 时，恒定陀螺零偏
$b$ 造成的稳态偏移为 $b\,\Delta t^2/\tau$，而纯陀螺积分会漂移 $b t$。
验证脚本同时检查这两种行为，并说明固定 $k$ 会随 $\Delta t$ 改变截止频率。

## 偏航与六轴 IMU 的边界

重力不携带航向信息。绕 $z$ 轴旋转不会改变
$\mathbf{a}_b = [0,0,g]^T$，所以横滚和俯仰可观测，偏航不可观测。
MPU6050 没有磁力计。因此地面站的立方体只是横滚/俯仰指示器，不是完整的
三维姿态显示。若要得到航向，需要磁力计、GNSS 航迹角，或在已知初始偏航的
条件下用陀螺递推并监控漂移。

## 动态加速度

发动机工作时，加速度计测量推力与重力的合成。对于水平放置、轴向推力为
20 m/s² 的箭体，静态俯仰公式会给出约 $-64^\circ$，而不是 $0^\circ$。
互补滤波只能削弱短时瞬态，无法消除持续加速度。归档中没有飞行加速度数据，
因此无法量化真实箭体上的误差。

## 遥测分帧

归档地面站使用正则表达式
`X(.+)Y(.+)GX(.+)GY(.+)GZ(.+)`。它没有帧头、长度和校验。串口一次读取只拿到
半帧时数据会被丢弃；两帧粘连时，贪婪的 `.+` 会错误合并字段。

经验证的替代帧格式为：

```
0x24 | LEN（1 字节） | PAYLOAD（0..64 字节） | CRC-16/CCITT-FALSE（2 字节） | 0x2A
```

它能在帧头重新同步，支持逐字节到达，拒绝错误 CRC，并允许一次读取中出现
多帧。解析器与测试位于 `../../scripts/verify_theory/test_protocol.py`。
这是建议格式，不是对归档固件的描述。

## 四元数

报告没有使用四元数。`../../scripts/verify_theory/quaternion.py` 固定了本仓库
使用的约定：

- Hamilton 乘法。
- 标量在前，$q = [w,x,y,z]$。
- 主动旋转，机体系到惯性系。
- 每次积分后归一化。
- 姿态误差使用测地角
  $2\arccos(|\langle q_1,q_2\rangle|)$，不使用分量差。

测试覆盖单位旋转、90° 与 180° 旋转、复合顺序、逆、旋转矩阵正交性、欧拉角
往返、四元数符号等价和常角速度积分。它们为未来的完整姿态估计提供基础，
并不表示原始固件使用了四元数。

## 验证

运行：

```bash
python scripts/verify_theory/run_verification.py
```

测试数量、被修正的测试预期和仍未确认的项目记录在 `../verification.md` 与
`../errata.md`。
