Robusr/DustArrow/media/photos/project/bench_exploded_assembly.png

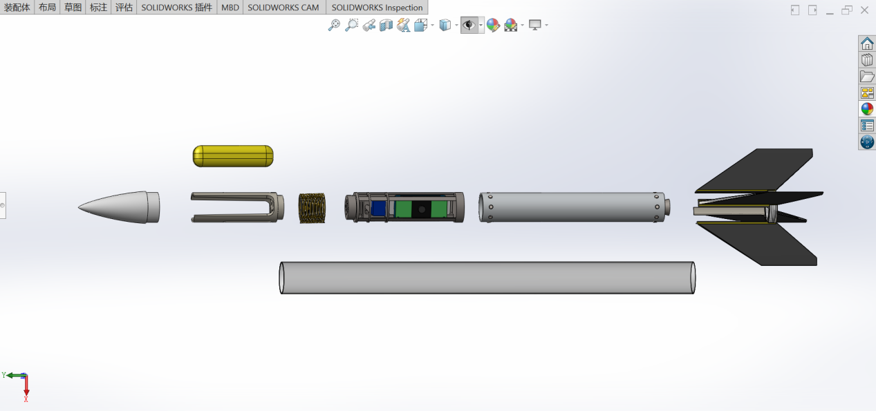
media/photos/project/bench_exploded_assembly.png
