Robusr/DustArrow/media/photos/project/bench_full_assembly.png

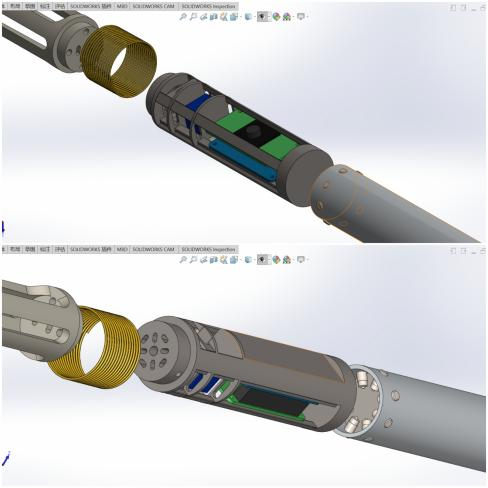
media/photos/project/bench_full_assembly.png
