Robusr/DustArrow/media/photos/reference/fig3_3_bench_assembly.png

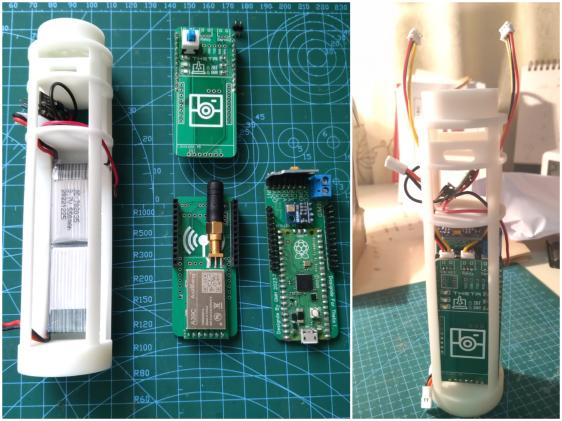
media/photos/reference/fig3_3_bench_assembly.png
