Robusr/DustArrow/docs/errata.md

# 理论审查与勘误记录

## 1. 审查范围与方法

审查对象为 `docs/archive/report/沙尘利“箭”.pdf` 与同名 DOCX，共 10 页。重点核对
姿态解算、互补滤波、坐标与单位、遥测协议、数据记录以及报告中的工程声明。
方法如下：

1. 逐段提取报告原文与内嵌公式图片。
2. 对可数值化的公式使用纯 Python 复算，脚本位于 `../scripts/verify_theory/`。
3. 对无法从归档材料确认的事实标记 `[待确认]`，不把设计目标写成实测值。
4. 保留原始报告，不覆盖 PDF/DOCX；修正内容只写入本文档、README 和验证脚本。

## 2. 统一约定

- 机体坐标系：$x$ 向前、$y$ 向右、$z$ 向上，右手系。
- 惯性坐标系：当地水平，$z$ 向上。
- 四元数：Hamilton 乘法，标量在前 $q=[w,x,y,z]$，主动旋转，机体系到惯性系。
- 角度单位：内部计算使用弧度，界面与本文使用度。
- 加速度单位：$\mathrm{m/s^2}$；重力取 $g=9.80665\ \mathrm{m/s^2}$。
- 报告没有明确写出上述轴向与安装方向，因此 E-01 仍为待确认项。

## 3. 勘误表

| ID | 位置 | 原文或原实现 | 修正或说明 | 类型 | 状态 | 依据与验证 |
|---|---|---|---|---|---|---|
| E-01 | 第 2 节 (1)①，约第 4 页 | 只写“绕 x 轴为 roll、绕 y 轴为 pitch、绕 z 轴为 yaw”，未定义轴向与传感器安装 | 明确采用 $x$ 前、$y$ 右、$z$ 上；实际板卡安装需对照丝印复核 | 坐标/符号 | [待确认] | 报告无安装图注；`test_attitude.py` 按此约定构造重力向量 |
| E-02 | 第 2 节 (1)①，约第 4 页 | $\Phi=\arctan(A_y/A_z)$ | $\phi=\mathrm{atan2}(A_y,A_z)$ | 数值/符号 | 已修正 | $\phi=150^\circ$ 时原式返回 $-30^\circ$；`test_atan_loses_quadrant` |
| E-03 | 第 2 节 (1)① 内嵌公式图 | 图示为 $\sin\theta=A_x/\sqrt{A_y^2+A_z^2}$，正文未给出俯仰推导 | 在本仓库约定下 $\theta=\mathrm{atan2}(-A_x,\sqrt{A_y^2+A_z^2})$；符号取决于安装方向 | 公式/符号 | [待确认] | `test_pitch_estimate` 在假定轴向下通过；实际安装未验证 |
| E-04 | 第 2 节 (1)②，约第 5 页 | $\theta_k=k\theta_{acc,k}+(1-k)\theta_{gyro,k}$，$\theta_{gyro,k}=\theta_{k-1}+\omega_y\Delta t$ | 补充 $\alpha=\tau/(\tau+\Delta t)$ 与完整离散更新；明确 $\Delta t$、初值和零偏 | 控制/数值 | 已补充 | 固定 $k$ 会随采样周期改变截止频率；`test_fixed_k_depends_on_sample_rate` |
| E-05 | 摘要、第 2 节 (2)、图 2.214 | 声称“3D 姿态信息实时反馈” | 六轴 IMU 仅能观测横滚/俯仰；偏航需磁力计、GNSS 航迹角或已知初值 | 运动学/结论 | 已修正表述 | 重力对偏航不变；`test_yaw_not_observable_from_gravity` |
| E-06 | 第 2 节 (1)① | 用静态重力公式解算姿态，未讨论推力 | 推力会叠加到加速度计；静态公式在主动段失效 | 动力学/实验 | [待确认] | 合成 20 m/s² 轴向推力时俯仰估计约 $-64^\circ$；`test_thrust_corrupts_accelerometer_angle` |
| E-07 | 第 2 节 (1)④，约第 6 页 | “可实现千米级稳定数传” | 改为设计目标；归档中无链路预算、天线增益、RSSI 或外场距离测试 | 实验/数值 | [待确认] | 只在 README 中标注“未验证设计目标” |
| E-08 | 第 3 节结论，约第 9 页 | “针对编码数据丢失做了鲁棒性处理” | 归档正则在分包时丢帧、粘包时误解析，且无校验 | 软件/协议 | 已修正声明 | `test_split_frame_is_lost`、`test_greedy_regex_misparses_concatenated_frames` |
| E-09 | 第 2 节 (5)，约第 5 页；Command B BOM | 正文写 BMP-180，BOM 写 GY-BMP280 | 以 BOM 的 BMP280 为准，正文待作者确认 | 器件/符号 | [待确认] | BOM `command_b_bom.csv`；两者 I2C 地址与换算不同 |
| E-10 | 第 2 节 (1)，约第 2 页；Exploration BOM | 正文写 RP2040 以 SMT 贴片封装上板，BOM 含树莓派 Pico 模块 | 记录两种说法，不擅自改写硬件结论 | 器件/装配 | [待确认] | BOM `exploration_bom.csv`；实际装配照片无法分辨封装 |
| E-11 | 第 2 节 (2) 实时信息反馈 | “数据的实时分析与精确记录” | 归档代码每帧覆盖写 `data.txt`，无时间戳、无落盘策略 | 软件 | 已修正声明 | `software/ground_station/myMainWindow.py` 的 `DATA()` |
| E-12 | 界面标签、BMP280 数据手册 | 界面标签为 `气压(KPa)`，BMP280 原始输出为 Pa | 若实现压力显示，需要除以 1000；当前代码未解析压力字段 | 单位 | [待确认] | UI 标签与 BOM/数据手册对照 |
| E-13 | 第 2 节 (2)、图 2.212–2.214 | 声称曲线与 3D 姿态实时显示 | 归档界面中六张图为 $y=x^2$ 占位；OpenGL 组件被注释；命令按钮未连接 | 软件 | 已修正声明 | 代码审查；软件 README 已列出“可用/未实现” |
| E-14 | 全文 | 报告未使用四元数 | 不修改原结论；新增四元数约定与参考实现，供后续完整姿态估计使用 | 四元数 | 说明 | `quaternion.py` 与 9 项测试 |
| E-15 | 第 2 节控制模块 | 报告自述 PID、空气舵/燃气舵算法“尚处于探究阶段” | 确认控制律未实现，归档中无控制增益、执行器模型或闭环试验 | 控制/结论 | 已确认局限 | 报告原文；无对应代码或数据 |
| E-16 | 电视专题片《少年爱迪生》第八季，2024-01-27；`docs/zh-CN/media_coverage.md` | 归档报告称进行了远距离数据传输测试并给出结论 | 电视专题片记录了一次试飞：遥控点火失败，改线控；火箭离架；传感器段回收，伞舱与推进模块丢失，回收完整度约 80%；无遥测日志、定量数据或链路测量 | 实验/结论 | 部分证实，无量化数据 | 专题片 11:30–17:24；电视专题文档 |

## 4. 对结论的影响

- **飞行试验**：E-16 把“进行过试飞”从报告声明提升为电视记录，但仍没有遥测日志；80% 是学生估计，千米级数传未被测量。
- **姿态显示**：E-02 会改变第二、三象限的横滚符号。原式在 $\phi=150^\circ$
  时显示 $-30^\circ$，方向相反。
- **俯仰与航向**：E-03、E-05 说明归档只能给出横滚/俯仰的静态估计；所谓
  “3D 姿态”实际是两自由度立方体，不含航向。
- **动态段**：E-06 表明起飞与主动段的姿态估计不可直接使用静态公式；需要
  飞行数据才能给出误差包络。
- **数传与记录**：E-07、E-08、E-11 将“千米级、鲁棒、精确记录”降级为设计
  目标或未实现项。README 的规格表已按“实测/设计目标/未验证”分列。
- **硬件口径**：E-09、E-10 不影响已解析的板卡尺寸与 BOM 成本，但会影响
  固件目标平台和气压换算，复现前必须确认。
- **数值结论**：本仓库没有改写报告中的任何实测数据，因为归档中没有可核对
  的飞行或标定数据。

## 5. 未能确认的问题

1. 飞控板实际安装方向与丝印轴向（E-01）。
2. 报告俯仰公式图对应的轴符号（E-03）。
3. 真实飞行中的加速度与姿态误差（E-06）。
4. A39C 的实际通信距离、天线形式与链路余量（E-07）。
5. 气压传感器到底是 BMP-180 还是 BMP280（E-09）。
6. RP2040 是贴片上板还是 Pico 模块（E-10）。
7. 压力字段的单位与换算位置（E-12）。
8. 原始固件、飞行日志与标定数据的存放位置。
9. 电视专题片所说“四个部分”与正式 CAD 十个舱段的对应关系。
10. 第三方资料所称“全国二等奖”的官方依据；目前未取得获奖名单。

以上项目在 README 与文档中均保留 `[待确认]` 标记，未写成既成事实。

## 6. 复算脚本

```bash
python scripts/verify_theory/run_verification.py
```

结果记录在 `docs/verification.md`。脚本只依赖 Python 标准库，不依赖 NumPy 或
硬件。测试失败时不得把对应勘误标记为“已修正”。
