Robusr/DustArrow/(commit log)

2026-10-19 chore(repo): reorganize CAD, electronics, simulation and archived sources
    Move the original project into a source/output layout, normalize export
    filenames, consolidate the BOM, and preserve the original report,
    presentation and legacy software under docs/archive.
2026-10-19 docs(theory): add errata, trilingual design docs and verification suite
    Document the coordinate conventions, correct the roll formula to atan2,
    add the complementary-filter derivation, propose a CRC-16 frame, and add
    32 pure-Python tests plus repository validation.
2026-10-19 feat(media): add GIF demos, report figures and architecture diagrams
    Convert the CFD and canard animations to looping GIFs with posters,
    extract the report figures, and add system architecture and telemetry
    frame diagrams.
2026-10-19 docs(repo): correct STL count and preserve archived build spec
    The formal print set contains 28 STL files, not 27. Track the original
    PyInstaller spec from the contest build and document the exclusion of
    transient solver logs and backups.
2026-10-19 release: package ground station v0.1.0
    Add a reproducible PyInstaller build script that produces a Windows
    one-folder bundle and a versioned zip with a SHA-256 checksum. Resolve the
    window icon via sys._MEIPASS when frozen and redirect stdout/stderr to
    devnull in windowed builds so runtime print() calls do not crash. Record
    the v0.1.0 artifact details in docs/releases and exclude the ignored
    release directory from the repository validator.
