Robusr/DustArrow/(notices)

Notices in the files:
README.md:
License: MIT
